TechPaula/PC6502/README.md

# GITHUB PROJECT NOW DEAD
I've now moved away from Micros**t and it's AI slop.

Find this project here - (https://codeberg.org/TechPaula/)
