TechPaula/PC6502/Schematics/PC6502-FM-SPEECH/PC6502-FM-SPEECH.step

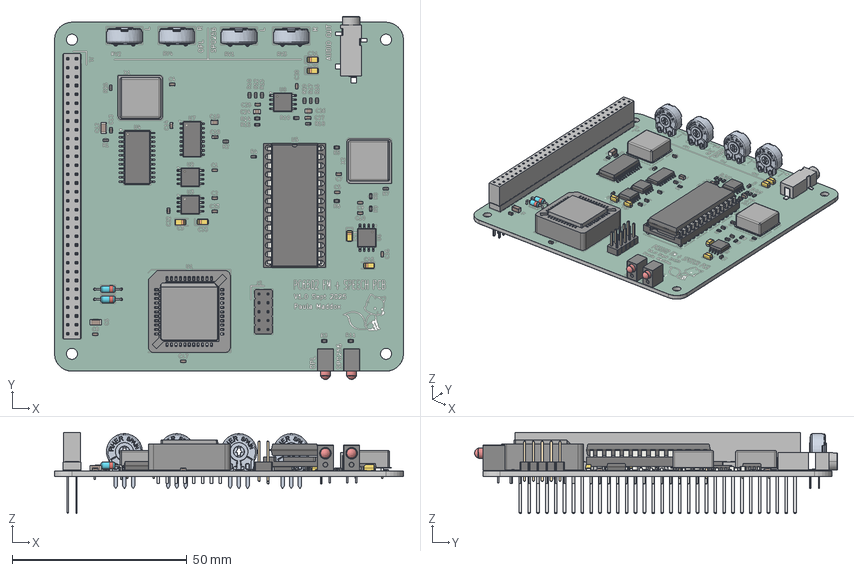
[picture p1: CAD file, 2025-10-02, last stored version]
Schematics/PC6502-FM-SPEECH/PC6502-FM-SPEECH.step
100.0 x 104.0 x 23.2 mm
SOIC-8_5.3x5.3mm_P1.27mm x 4
R_0603_1608Metric x 21
PLCC-44-AT
plcc44
D_DO-35_SOD27_P7.62mm_Horizontal x 2
PT10LH01-CARCASA x 4
PT10LH01-TERMINAL DERECHO x 4
PT10LH01-TERMINAL IZQUIERDO x 4
PT10LH01-COLECTOR x 4
PT10LH01-PORTACURSOR_Predeterminada x 4
C_0603_1608Metric x 18
PinHeader_2x05_P2.54mm_Vertical
C_0805_2012Metric x 3
C_1206_3216Metric x 2
Oscillator_DIP-8 x 2
CP_EIA-3216-18_Kemet-A x 6
LTL-4221NHBP x 2
SOIC-24W_7.5x15.4mm_P1.27mm
ESW-132-14-T-D_socket
ESW-132-14-T-D_pins
ESW-132-14-T-D2_PINS
ESW-132-14-T-D_bsocket
SOIC-16W_5.3x10.2mm_P1.27mm
SJ-3523-SMT-TR
DIP-28_W15.24mm_Socket
DIP-28_W15.24mm
PC6502-FM-SPEECH_silkscreen
PC6502-FM-SPEECH_soldermask
PC6502-FM-SPEECH_PCB
