TechPaula/PC6502/Schematics/PC6502-POWER/PC6502-POWER.step

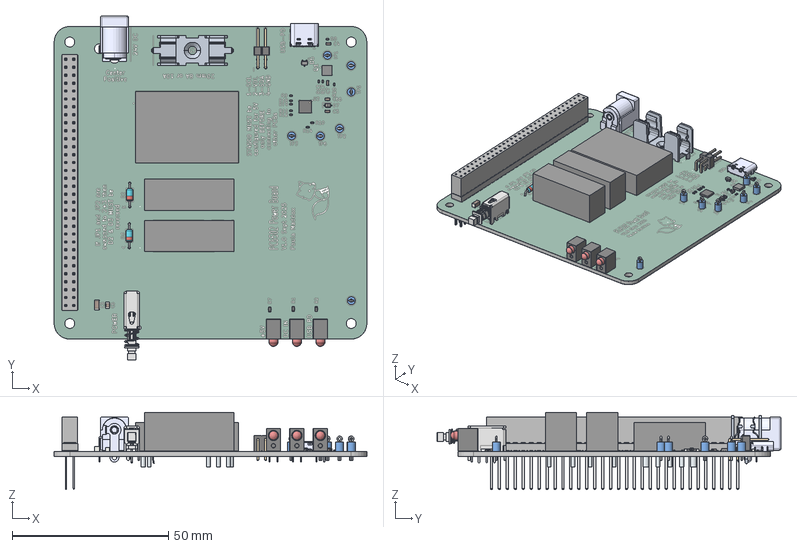
[picture p2: CAD file, 2025-10-02, last stored version]
Schematics/PC6502-POWER/PC6502-POWER.step
100.0 x 110.0 x 24.6 mm
TestPoint_Loop_D1.80mm_Drill1.0mm_Beaded x 7
R_0402_1005Metric x 11
C_0603_1608Metric x 4
C_0805_2012Metric
C_1206_3216Metric
Leads x 18
LC1258EENP
UJ20-C-H-G-SMT-1-P16-TR
R_0603_1608Metric x 3
PinsArrayL
FilletPinR
QFN-24-1EP_4x4mm_P0.5mm_EP2.7x2.7mm
D_SOD-323
LTL-4221NHBP x 3
ESW-132-14-T-D_socket
ESW-132-14-T-D_pins
ESW-132-14-T-D2_PINS
ESW-132-14-T-D_bsocket
STL9P3LLH6
D_DO-35_SOD27_P7.62mm_Horizontal x 2
PinHeader_2x02_P2.54mm_Horizontal
PC6502-POWER_silkscreen
PC6502-POWER_soldermask
PC6502-POWER_PCB
