TechPaula/PC6502/Schematics/PC6502-STORAGE/PC6502-STORAGE.step

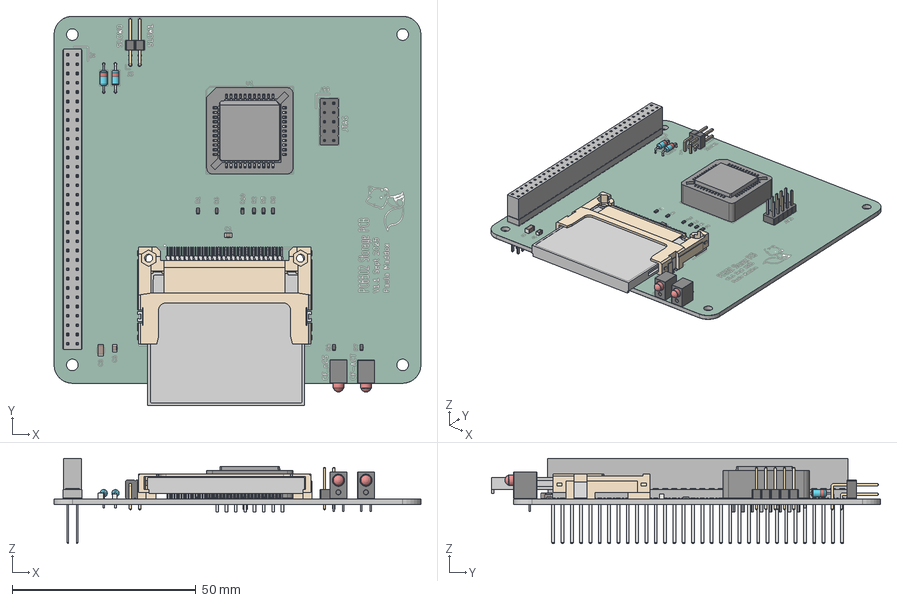
[picture p3: CAD file, 2025-10-02, last stored version]
Schematics/PC6502-STORAGE/PC6502-STORAGE.step
100.0 x 106.1 x 23.2 mm
LTL-4221NHBP x 2
R_0603_1608Metric x 8
D_DO-35_SOD27_P7.62mm_Horizontal x 2
C_0805_2012Metric x 3
C_1206_3216Metric
PinHeader_2x02_P2.54mm_Horizontal
ESW-132-14-T-D_socket
ESW-132-14-T-D_pins
ESW-132-14-T-D2_PINS
ESW-132-14-T-D_bsocket
PinHeader_2x05_P2.54mm_Vertical
693120035011_PATTE x 2
693120035011_PIN_HAUT_COURTE
693120035011_PIN_BAS_LONGUE x 3
693120035011_PIN_HAUT_LONGUE x 2
693120035011_PIN_BAS x 22
693120035011_PIN_HAUT x 22
CompactFlash (CF) Memory Card
PLCC-44-AT
plcc44
PC6502-STORAGE_silkscreen
PC6502-STORAGE_soldermask
PC6502-STORAGE_PCB
