TechPaula/PC6502/Schematics/PC6502-KEYTFT/PC6502-KEYTFT.kicad_pcb

## KiCad design Schematics/PC6502-KEYTFT/PC6502-KEYTFT.kicad_pcb (2026-03-21, last stored version)

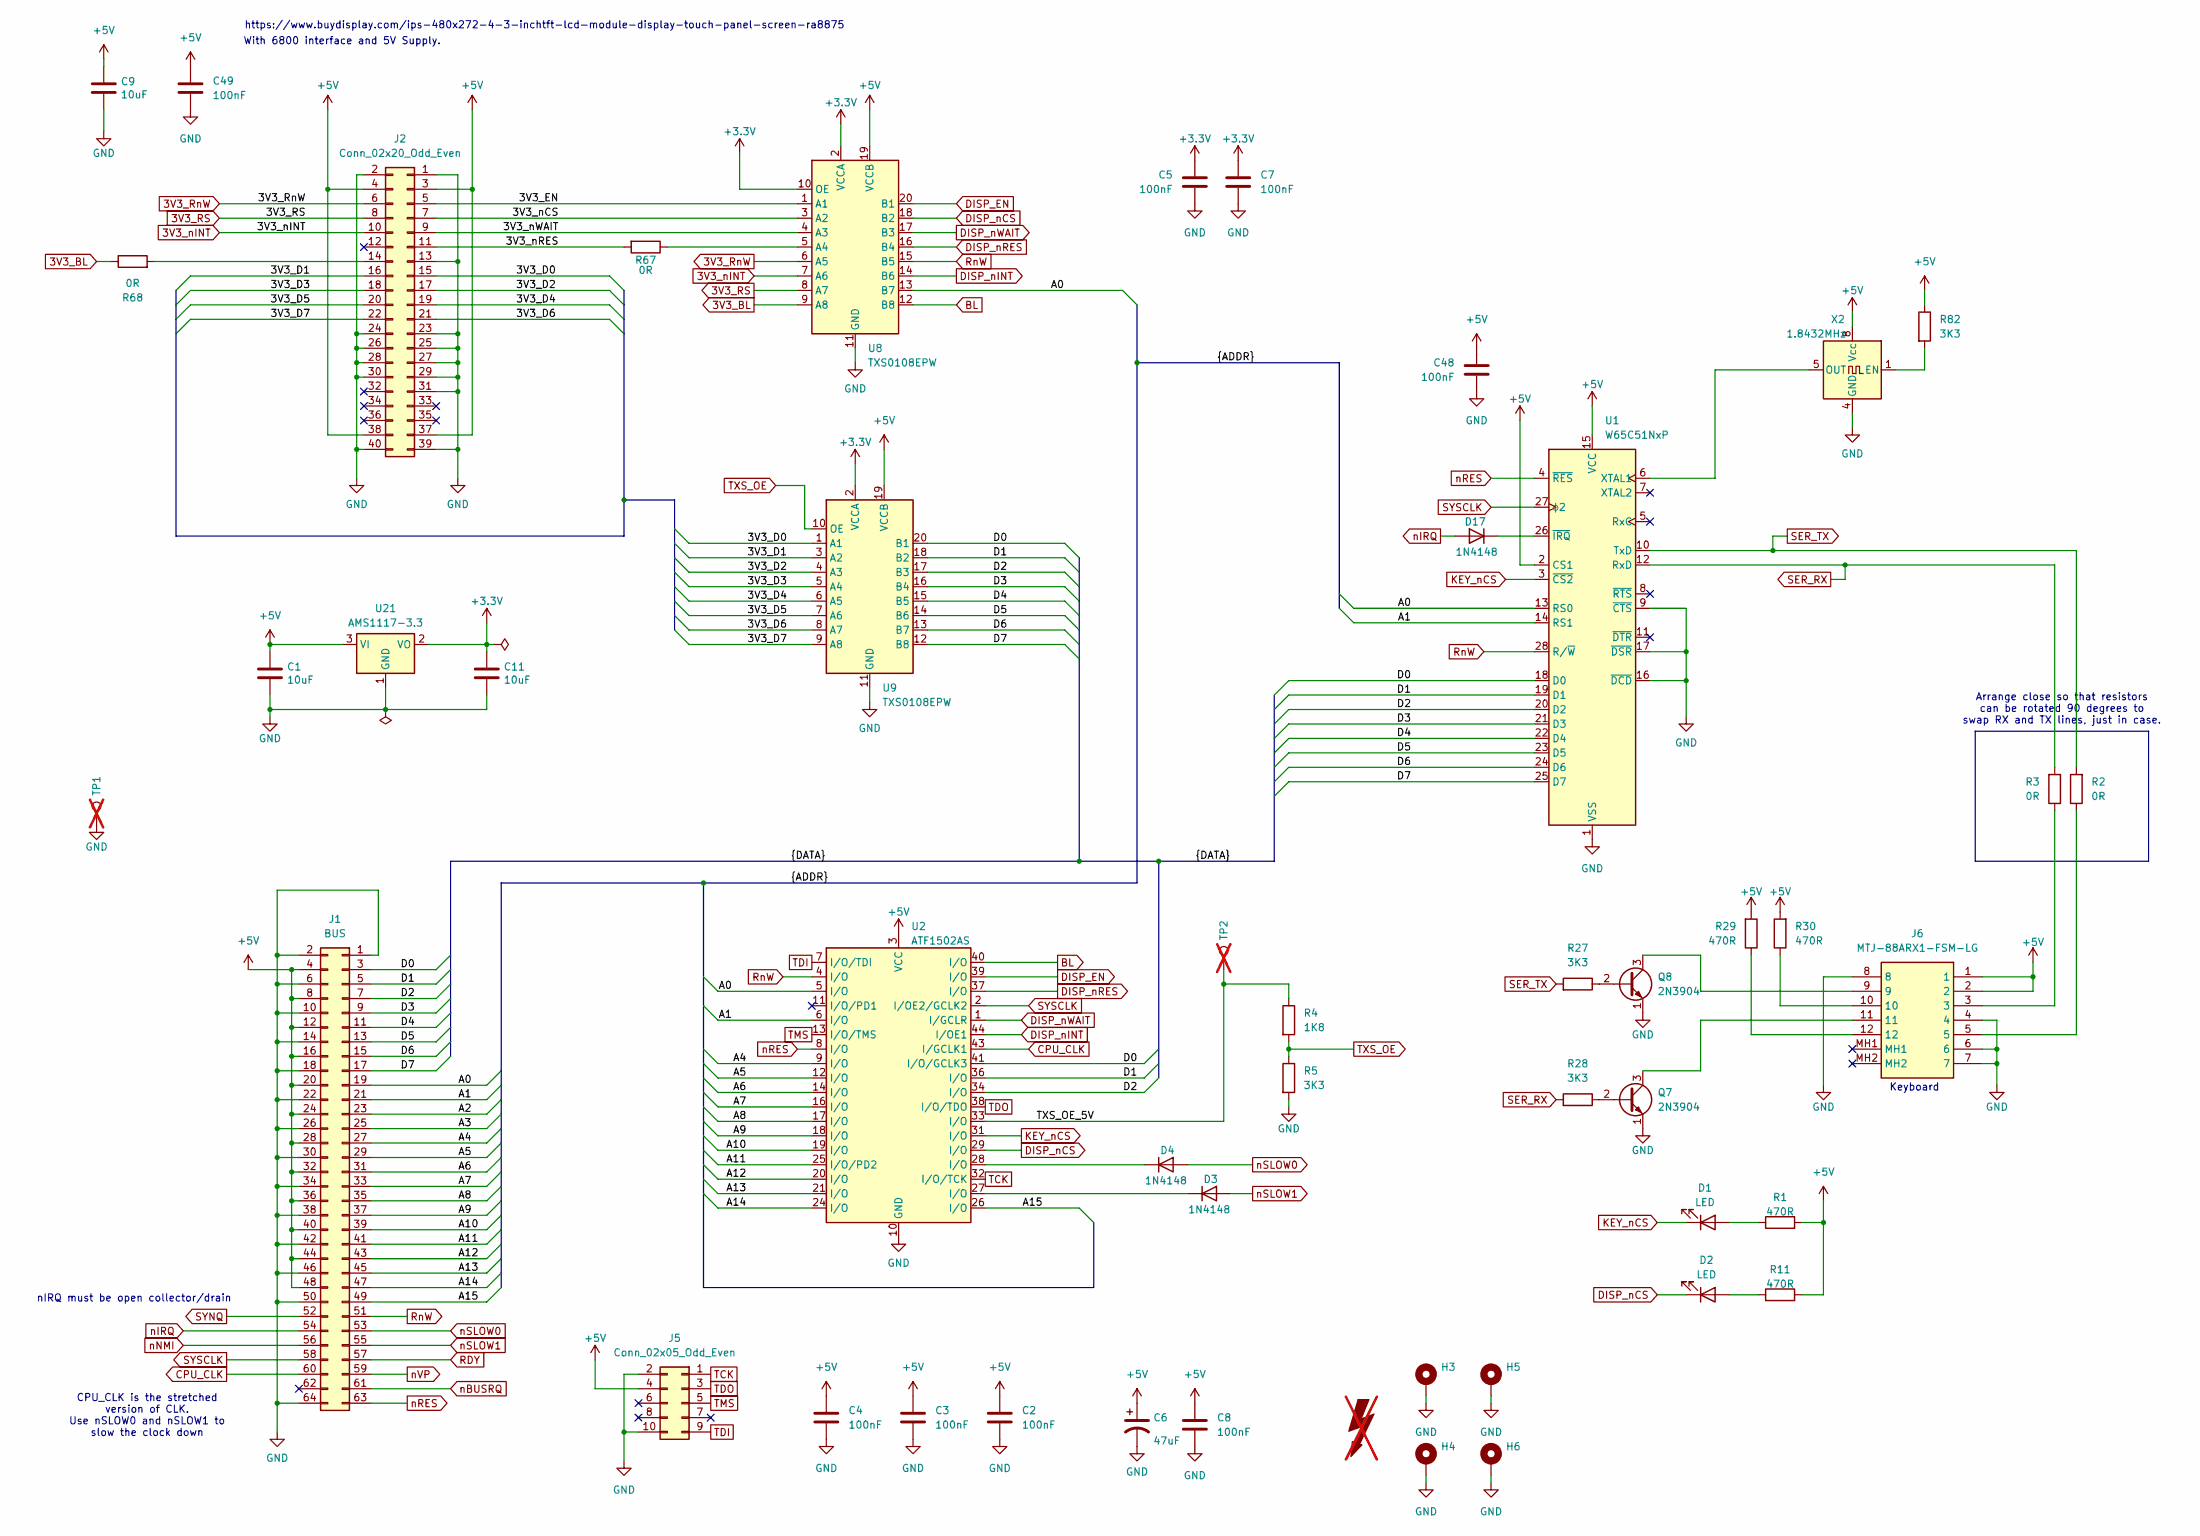
[picture p4: schematic PC6502-KEYTFT.kicad_sch]

Parts:
C1, C9, C11: 10uF; C_0805_2012Metric; ManufacturerPN C3216X7R1E475M085AB; LCSC C15850
C2, C3, C4, C8: 100nF; C_0603_1608Metric
C5, C7, C48, C49: 100nF; C_0603_1608Metric; LCSC C49678
C6: 47uF; C_1206_3216Metric; LCSC C96123
D1, D2: LED; LTL4221NHBP; LCSC DNF
D3, D4: 1N4148; D_DO-35_SOD27_P7.62mm_Horizontal; LCSC DNF
D17: 1N4148; D_DO-35_SOD27_P7.62mm_Horizontal
FOX1: SYM_Flash_Large; Fox_avatar_18mm; LCSC DNF; not fitted
H3, H4, H5, H6: MountingHole_Pad; MountingHole_3.2mm_M3_Pad_TopBottom; LCSC DNF
J1: BUS; PinSocket_2x32_P2.54mm_Vertical; LCSC DNF
J2: Conn_02x20_Odd_Even; PinSocket_2x20_P2.54mm_Horizontal
J5: Conn_02x05_Odd_Even; PinHeader_2x05_P2.54mm_Vertical; LCSC DNF
J6: MTJ-88ARX1-FSM-LG; MTJ88ARX1FSMLG; Mouser Part Number 737-MTJ88ARX1FSMLG
Q7, Q8: 2N3904; TO-92_Inline
R1, R11, R29, R30: 470R; R_0603_1608Metric; LCSC C23179
R2, R3: 0R; R_0603_1608Metric_Pad0.98x0.95mm_HandSolder; LCSC C23179
R4: 1K8; R_0603_1608Metric; LCSC C25890
R5, R27, R28, R82: 3K3; R_0603_1608Metric; LCSC C25890
R67, R68: 0R; R_0603_1608Metric; LCSC DNF
TP1, TP2: TestPoint; TestPoint_Loop_D1.80mm_Drill1.0mm_Beaded; LCSC DNF; not fitted
U1: W65C51NxP; DIP-28_W15.24mm
U2: ATF1502AS; PLCC-44_THT-Socket; LCSC DNF
U8, U9: TXS0108EPW; TSSOP-20_4.4x6.5mm_P0.65mm
U21: AMS1117-3.3; SOT-223-3_TabPin2; LCSC C6186
X2: 1.8432MHz; Oscillator_DIP-8; LCSC DNF

Connections:
3V3_BL: R68.1, U8.9 (A8)
3V3_RS: J2.8, U8.8 (A7)
3V3_RnW: J2.6, U8.6 (A5)
3V3_nINT: J2.10, U8.7 (A6)
+3.3V: C5.1, C7.1, C11.1, U8.2 (VCCA), U8.10 (OE), U9.2 (VCCA), U21.2 (VO)
+5V: C1.1, C2.1, C3.1, C4.1, C6.1, C8.1, C9.1, C48.1, C49.1, J1.4, J1.8, J1.12, J1.16, J1.20, J1.24, J1.28, J1.32, J1.36, J1.40, J1.44, J1.48, J2.3, J2.4, J2.37, J2.38, J5.4, J6.1, J6.2, R1.2, R11.2, R29.2, R30.2, R82.1, U1.2 (CS1), U1.15 (VCC), U2.3 (VCC), U2.15 (VCC), U2.23 (VCC), U2.35 (VCC), U8.19 (VCCB), U9.19 (VCCB), U21.3 (VI), X2.8 (Vcc)
/3V3_D0: J2.15, U9.1 (A1)
/3V3_D1: J2.16, U9.3 (A2)
/3V3_D2: J2.17, U9.4 (A3)
/3V3_D3: J2.18, U9.5 (A4)
/3V3_D4: J2.19, U9.6 (A5)
/3V3_D5: J2.20, U9.7 (A6)
/3V3_D6: J2.21, U9.8 (A7)
/3V3_D7: J2.22, U9.9 (A8)
/3V3_EN: J2.5, U8.1 (A1)
/3V3_nCS: J2.7, U8.3 (A2)
/3V3_nRES: J2.11, R67.2
/3V3_nWAIT: J2.9, U8.4 (A3)
/A0: J1.19, U1.13 (RS0), U2.5 (I/O), U8.13 (B7)
/A1: J1.21, U1.14 (RS1), U2.6 (I/O)
/A2: J1.23
/A3: J1.25
/A4: J1.27, U2.9 (I/O)
/A5: J1.29, U2.12 (I/O)
/A6: J1.31, U2.14 (I/O)
/A7: J1.33, U2.16 (I/O)
/A8: J1.35, U2.17 (I/O)
/A9: J1.37, U2.18 (I/O)
/A10: J1.39, U2.19 (I/O)
/A11: J1.41, U2.25 (I/O/PD2)
/A12: J1.43, U2.20 (I/O)
/A13: J1.45, U2.21 (I/O)
/A14: J1.47, U2.24 (I/O)
/A15: J1.49, U2.26 (I/O)
/D0: J1.3, U1.18 (D0), U2.41 (I/O/GCLK3), U9.20 (B1)
/D1: J1.5, U1.19 (D1), U2.36 (I/O), U9.18 (B2)
/D2: J1.7, U1.20 (D2), U2.34 (I/O), U9.17 (B3)
/D3: J1.9, U1.21 (D3), U9.16 (B4)
/D4: J1.11, U1.22 (D4), U9.15 (B5)
/D5: J1.13, U1.23 (D5), U9.14 (B6)
/D6: J1.15, U1.24 (D6), U9.13 (B7)
/D7: J1.17, U1.25 (D7), U9.12 (B8)
/TXS_OE_5V: R4.1, TP2.1, U2.33 (I/O)
BL: U2.40 (I/O), U8.12 (B8)
CPU_CLK: J1.60, U2.43 (I/GCLK1)
DISP_EN: U2.39 (I/O), U8.20 (B1)
DISP_nCS: D2.1 (K), U2.29 (I/O), U8.18 (B2)
DISP_nINT: U2.44 (I/OE1), U8.14 (B6)
DISP_nRES: U2.37 (I/O), U8.16 (B4)
DISP_nWAIT: U2.1 (I/GCLR), U8.17 (B3)
GND: C1.2, C2.2, C3.2, C4.2, C5.2, C6.2, C7.2, C8.2, C9.2, C11.2, C48.2, C49.2, H3.1, H4.1, H5.1, H6.1, J1.1, J1.2, J1.6, J1.10, J1.14, J1.18, J1.22, J1.26, J1.30, J1.34, J1.38, J1.42, J1.46, J1.50, J1.64, J2.1, J2.2, J2.13, J2.23, J2.24, J2.25, J2.26, J2.27, J2.28, J2.29, J2.30, J2.31, J2.39, J2.40, J5.2, J5.10, J6.4, J6.6, J6.7, J6.8, Q7.1 (E), Q8.1 (E), R5.2, TP1.1, U1.1 (VSS), U1.9 (~CTS), U1.16 (~DCD), U1.17 (~DSR), U2.10 (GND), U2.22 (GND), U2.30 (GND), U2.42 (GND), U8.11 (GND), U9.11 (GND), U21.1 (GND), X2.4 (GND)
KEY_nCS: D1.1 (K), U1.3 (~CS2), U2.31 (I/O)
unnamed: D1.2 (A), R1.1
unnamed: D2.2 (A), R11.1
unnamed: D3.1 (K), U2.27 (I/O)
unnamed: D4.1 (K), U2.28 (I/O)
unnamed: D17.1 (K), U1.26 (~IRQ)
unnamed: J2.14, R68.2
unnamed: J6.3, R3.1
unnamed: J6.5, R2.1
unnamed: J6.10, R30.1
unnamed: J6.12, R29.1
unnamed: Q7.2 (B), R28.1
unnamed: J6.11, Q7.3 (C)
unnamed: Q8.2 (B), R27.1
unnamed: J6.9, Q8.3 (C)
unnamed: U1.6 (XTAL1), X2.5 (OUT)
unnamed: R67.1, U8.5 (A4)
unnamed: R82.2, X2.1 (EN)
RDY: J1.57
RnW: J1.51, U1.28 (R/~W), U2.4 (I/O), U8.15 (B5)
SER_RX: R3.2, R28.2, U1.12 (RxD)
SER_TX: R2.2, R27.2, U1.10 (TxD)
SYNQ: J1.52
SYSCLK: J1.58, U1.27 (ϕ2), U2.2 (I/OE2/GCLK2)
TCK: J5.1, U2.32 (I/O/TCK)
TDI: J5.9, U2.7 (I/O/TDI)
TDO: J5.3, U2.38 (I/O/TDO)
TMS: J5.5, U2.13 (I/O/TMS)
TXS_OE: R4.2, R5.1, U9.10 (OE)
nBUSRQ: J1.61
nIRQ: D17.2 (A), J1.54
nNMI: J1.56
nRES: J1.63, U1.4 (~RES), U2.8 (I/O)
nSLOW0: D4.2 (A), J1.53
nSLOW1: D3.2 (A), J1.55
nVP: J1.59

Notes on the sheet:
With 6800 interface and 5V Supply.
CPU_CLK is the stretched version of CLK. Use nSLOW0 and nSLOW1 to slow the clock down
Arrange close so that resistors can be rotated 90 degrees to swap RX and TX lines, just in case.
https://www.buydisplay.com/ips-480x272-4-3-inchtft-lcd-module-display-touch-panel-screen-ra8875
Keyboard
nIRQ must be open collector/drain

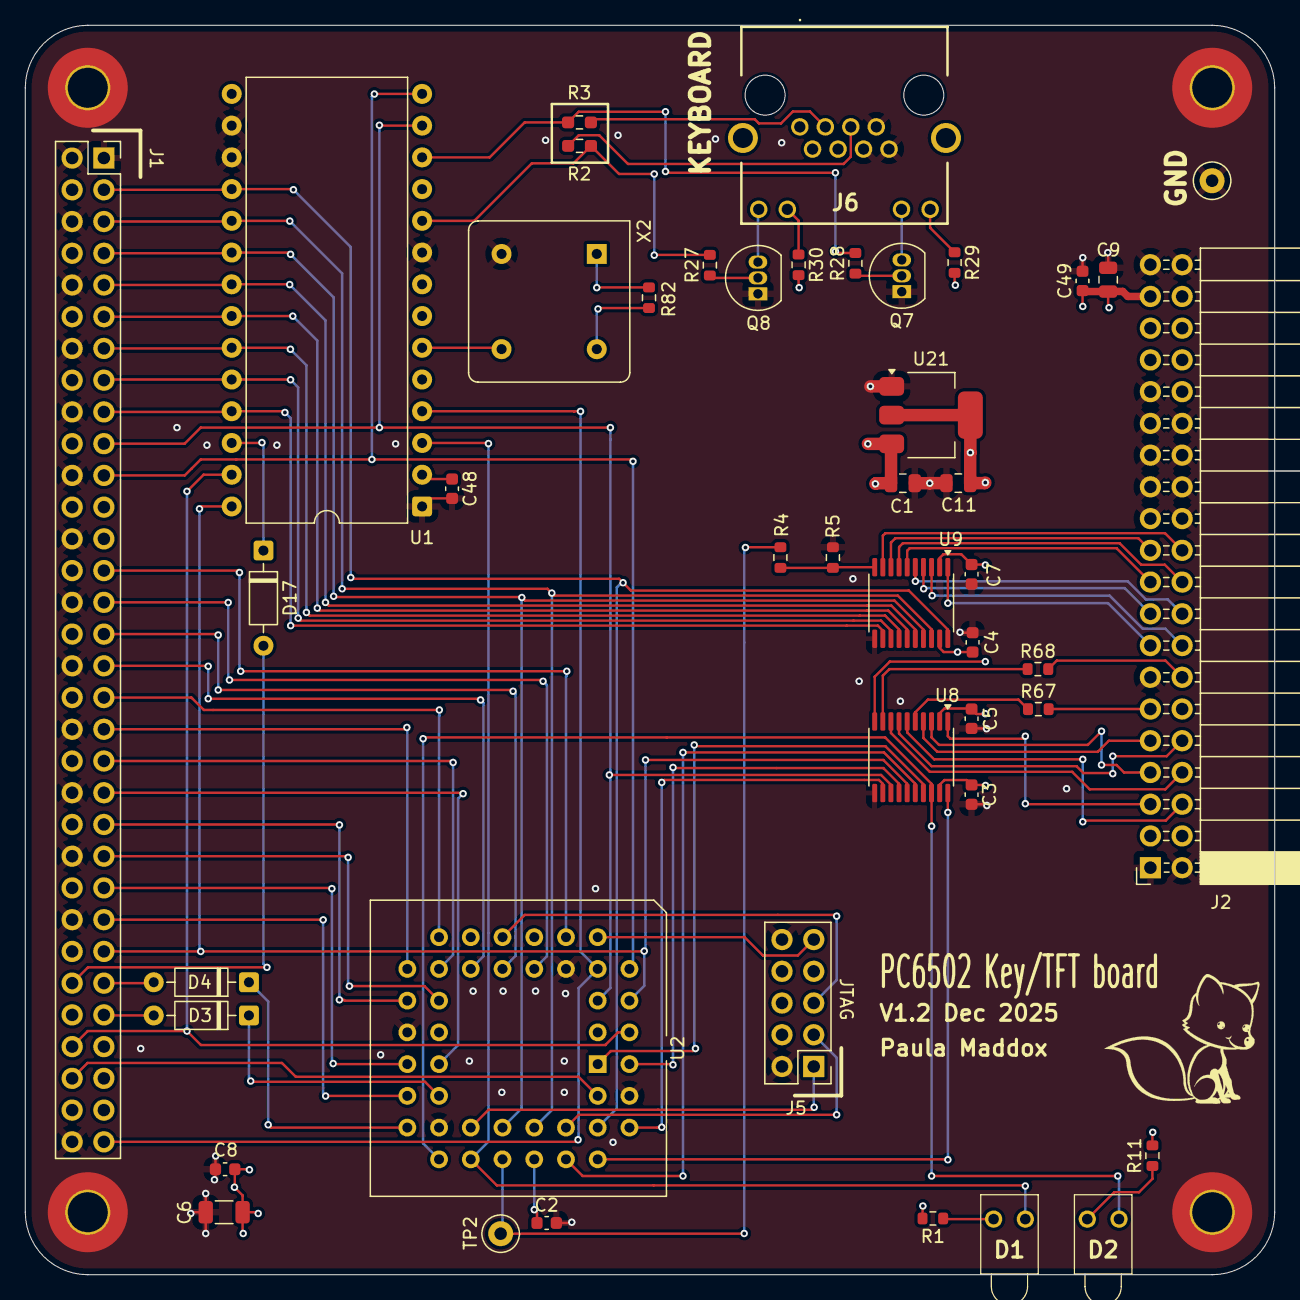
[picture p5: board PC6502-KEYTFT.kicad_pcb from above]

Board: 4 copper layers, 100.0 x 100.0 mm, 49 parts (0 on the bottom side), 80 nets.
