TechPaula/PC6502/Schematics/PC6502-SOUND_GEN_A/PC6502-SOUND_GEN_A.kicad_pcb

## KiCad design Schematics/PC6502-SOUND_GEN_A/PC6502-SOUND_GEN_A.kicad_pcb (2025-12-28, last stored version)

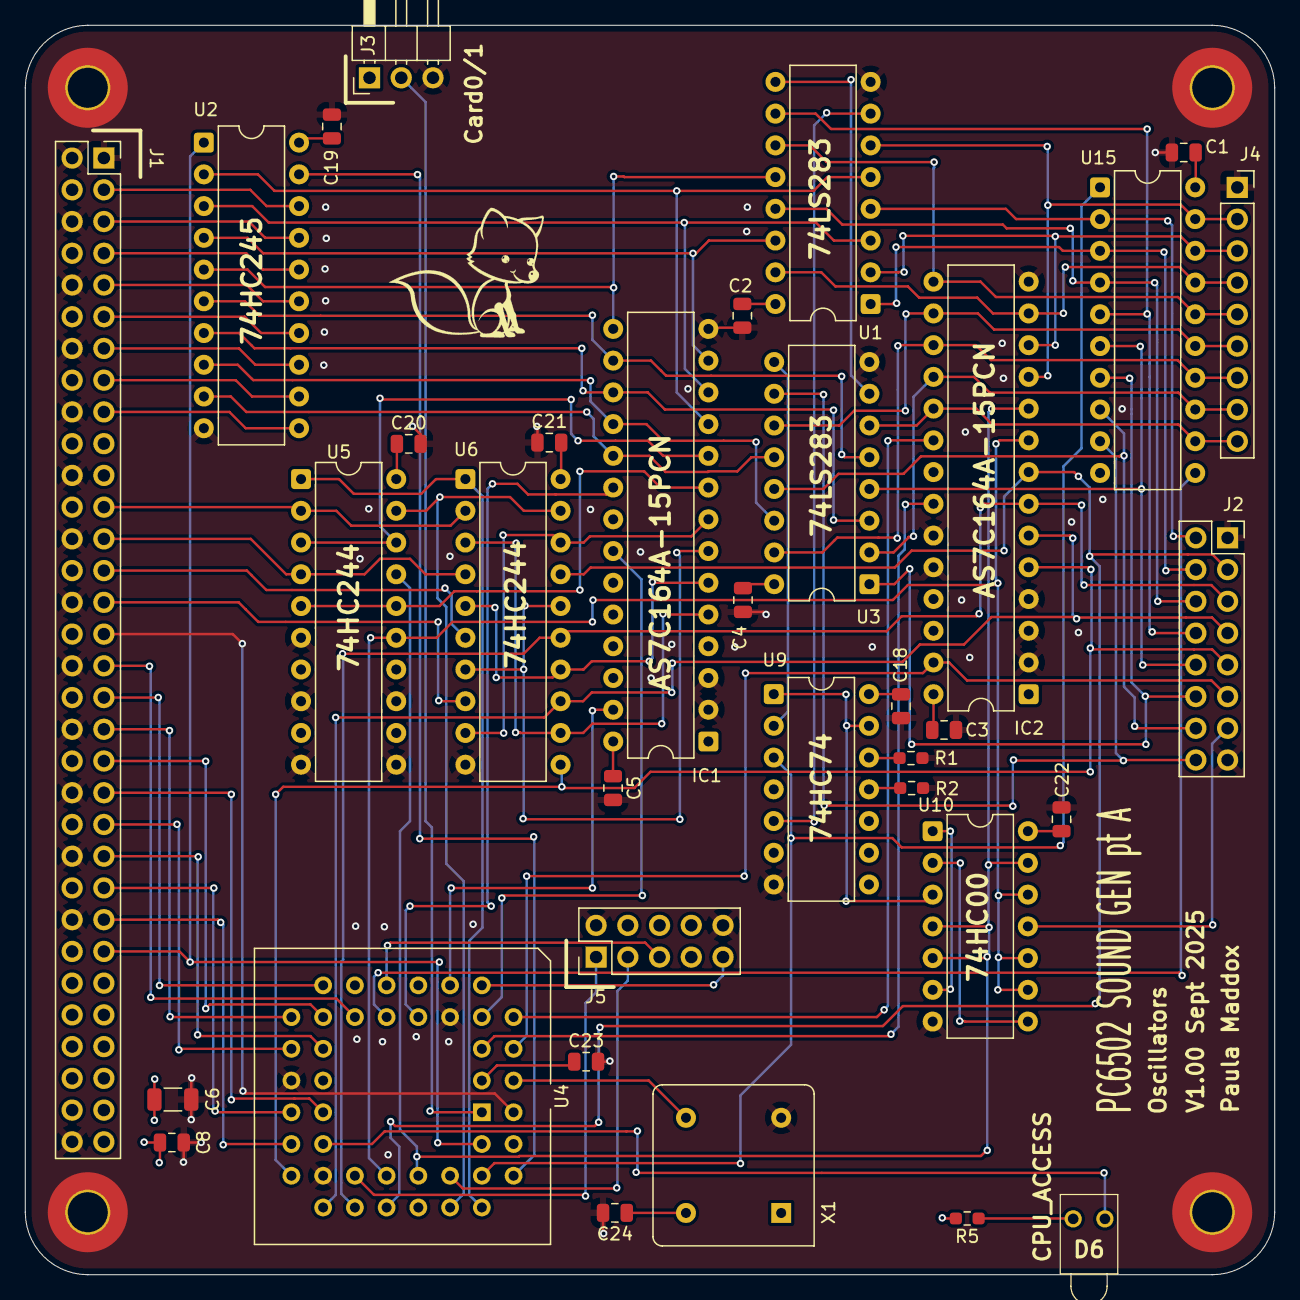
[picture p6: board PC6502-SOUND_GEN_A.kicad_pcb from above]

Board: 4 copper layers, 100.0 x 100.0 mm, 40 parts (0 on the bottom side), 89 nets.

Parts:
C1, C2, C3, C4, C5, C8, C18, C19, C20, C21, C22, C23, C24: 100nF; C_0805_2012Metric
C6: 47uF; C_1206_3216Metric
D6: LED; LTL4221NHBP
FOX1: SYM_Flash_Large; Fox_avatar_18mm
H3, H4, H5, H6: MountingHole_Pad; MountingHole_3.2mm_M3_Pad_TopBottom
IC1, IC2: AS7C164A-15PCN; DIP-28_W7.62mm
J1: BUS; PinSocket_2x32_P2.54mm_Vertical
J2: NCO_OUT; PinSocket_2x08_P2.54mm_Vertical
J3: SND0/SND1; PinHeader_1x03_P2.54mm_Horizontal
J4: Conn_01x09; PinSocket_1x09_P2.54mm_Vertical
J5: Conn_02x05_Odd_Even; PinHeader_2x05_P2.54mm_Vertical
R1, R2: 10K; R_0603_1608Metric_Pad0.98x0.95mm_HandSolder
R5: 470R; R_0603_1608Metric_Pad0.98x0.95mm_HandSolder
U1, U3: 74LS283; DIP-16_W7.62mm
U2: 74HC245; DIP-20_W7.62mm
U4: ATF1504AS; PLCC-44_THT-Socket
U5, U6: 74AHCT244; DIP-20_W7.62mm
U9: 74HC74; DIP-14_W7.62mm
U10: 74HC00; DIP-14_W7.62mm
U15: 74HCT574; DIP-20_W7.62mm
X1: CXO_DIP8; Oscillator_DIP-8

Connections:
+5V: C1.1, C2.1, C3.1, C4.1, C5.1, C6.1, C8.1, C18.1, C19.1, C20.1, C21.1, C22.1, C23.1, C24.1, IC1.21 (A10), IC1.23 (A11), IC1.24 (A9), IC1.25 (A8), IC1.26 (CE2), IC1.28 (VCC), IC2.26 (CE2), IC2.28 (VCC), J1.4, J1.8, J1.12, J1.16, J1.20, J1.24, J1.28, J1.32, J1.36, J1.40, J1.44, J1.48, J3.1, J5.4, R5.2, U1.16 (VCC), U2.20 (VCC), U3.16 (VCC), U4.3 (VCC), U4.15 (VCC), U4.23 (VCC), U4.35 (VCC), U5.20 (VCC), U6.20 (VCC), U9.4 (~S), U9.10 (~S), U9.14 (VCC), U10.14 (VCC), U15.20 (VCC), X1.8 (Vcc)
/8BitNCO/ACC_DQ0: IC2.11 (DQ0), J4.2, U1.6 (B1), U15.19 (Q0)
/8BitNCO/ACC_DQ1: IC2.12 (DQ1), J4.3, U1.2 (B2), U15.18 (Q1)
/8BitNCO/ACC_DQ2: IC2.13 (DQ2), J4.4, U1.15 (B3), U15.17 (Q2)
/8BitNCO/ACC_DQ3: IC2.15 (DQ3), J4.5, U1.11 (B4), U15.16 (Q3)
/8BitNCO/ACC_DQ4: IC2.16 (DQ4), J4.6, U3.11 (B4), U15.15 (Q4)
/8BitNCO/ACC_DQ5: IC2.17 (DQ5), J4.7, U3.15 (B3), U15.14 (Q5)
/8BitNCO/ACC_DQ6: IC2.18 (DQ6), J4.8, U3.2 (B2), U15.13 (Q6)
/8BitNCO/ACC_DQ7: IC2.19 (DQ7), J4.9, U3.6 (B1), U15.12 (Q7)
/8BitNCO/Cin: U1.7 (C0), U9.5 (Q)
/8BitNCO/Cout: U3.9 (C4), U9.2 (D)
/8BitNCO/PTC_A0: IC1.10 (A0), U5.3 (2Y0), U5.18 (1Y0)
/8BitNCO/PTC_A1: IC1.9 (A1), U5.5 (2Y1), U5.16 (1Y1)
/8BitNCO/PTC_A2: IC1.8 (A2), U6.9 (2Y3), U6.18 (1Y0)
/8BitNCO/PTC_A3: IC1.7 (A3), U6.7 (2Y2), U6.16 (1Y1)
/8BitNCO/PTC_A4: IC1.6 (A4), U6.5 (2Y1), U6.14 (1Y2)
/8BitNCO/PTC_A5: IC1.5 (A5), U6.3 (2Y0), U6.12 (1Y3)
/8BitNCO/PTC_DQ0: IC1.11 (DQ0), U1.5 (A1), U2.2 (A0)
/8BitNCO/PTC_DQ1: IC1.12 (DQ1), U1.3 (A2), U2.3 (A1)
/8BitNCO/PTC_DQ2: IC1.13 (DQ2), U1.14 (A3), U2.4 (A2)
/8BitNCO/PTC_DQ3: IC1.15 (DQ3), U1.12 (A4), U2.5 (A3)
/8BitNCO/PTC_DQ4: IC1.16 (DQ4), U2.6 (A4), U3.5 (A1)
/8BitNCO/PTC_DQ5: IC1.17 (DQ5), U2.7 (A5), U3.3 (A2)
/8BitNCO/PTC_DQ6: IC1.18 (DQ6), U2.8 (A6), U3.14 (A3)
/8BitNCO/PTC_DQ7: IC1.19 (DQ7), U2.9 (A7), U3.12 (A4)
/8BitNCO/SUM0: J2.2, U1.4 (S1), U15.2 (D0)
/8BitNCO/SUM1: J2.4, U1.1 (S2), U15.3 (D1)
/8BitNCO/SUM2: J2.6, U1.13 (S3), U15.4 (D2)
/8BitNCO/SUM3: J2.8, U1.10 (S4), U15.5 (D3)
/8BitNCO/SUM4: J2.10, U3.4 (S1), U15.6 (D4)
/8BitNCO/SUM5: J2.12, U3.1 (S2), U15.7 (D5)
/8BitNCO/SUM6: J2.14, U3.13 (S3), U15.8 (D6)
/8BitNCO/SUM7: J2.16, U3.10 (S4), U15.9 (D7)
/A2: J1.23, U5.2 (1A0), U6.2 (1A0)
/A3: J1.25, U5.4 (1A1), U6.4 (1A1)
/A4: J1.27, U6.6 (1A2)
/A5: J1.29, U6.8 (1A3)
/A6: J1.31, U4.44 (I/OE1)
/A7: J1.33, U4.16 (I/O)
/A8: J1.35, U4.17 (I/O)
/A9: J1.37, U4.18 (I/O)
/A10: J1.39, U4.19 (I/O)
/A11: J1.41, U4.25 (I/O/PD2)
/A12: J1.43, U4.20 (I/O)
/A13: J1.45, U4.21 (I/O)
/A14: J1.47, U4.24 (I/O)
/A15: J1.49, U4.26 (I/O)
/D0: J1.3, U2.18 (B0)
/D1: J1.5, U2.17 (B1)
/D2: J1.7, U2.16 (B2)
/D3: J1.9, U2.15 (B3)
/D4: J1.11, U2.14 (B4)
/D5: J1.13, U2.13 (B5)
/D6: J1.15, U2.12 (B6)
/D7: J1.17, U2.11 (B7)
/nWAVE_VALID: J2.13, U10.11
/nZERO_CARRY: U9.1 (~R), U9.13 (~R), U10.3
ACC_nCS: IC2.20 (CE#), U4.6 (I/O)
ACC_nOE: IC2.22 (OE#), U4.5 (I/O)
ACC_nWR: IC2.27 (WE#), J2.11, U4.4 (I/O)
BYTE_SEL_A0: IC2.10 (A0), U4.36 (I/O), U5.17 (2A0), U10.4, U10.5, U10.13
BYTE_SEL_A1: IC2.9 (A1), U4.34 (I/O), U5.15 (2A1), U10.9, U10.10, U10.12
GND: C1.2, C2.2, C3.2, C4.2, C5.2, C6.2, C8.2, C18.2, C19.2, C20.2, C21.2, C22.2, C23.2, C24.2, H3.1, H4.1, H5.1, H6.1, IC1.2 (A12), IC1.3 (A7), IC1.4 (A6), IC1.14 (VSS), IC2.2 (A12), IC2.3 (A7), IC2.4 (A6), IC2.14 (VSS), IC2.21 (A10), IC2.23 (A11), IC2.24 (A9), IC2.25 (A8), J1.1, J1.2, J1.6, J1.10, J1.14, J1.18, J1.22, J1.26, J1.30, J1.34, J1.38, J1.42, J1.46, J1.50, J1.64, J2.1, J2.15, J3.3, J4.1, J5.2, J5.10, R1.2, R2.2, U1.8 (GND), U2.10 (GND), U3.8 (GND), U4.10 (GND), U4.22 (GND), U4.30 (GND), U4.42 (GND), U5.6 (1A2), U5.8 (1A3), U5.10 (GND), U5.11 (2A3), U5.13 (2A2), U6.10 (GND), U9.7 (GND), U10.7 (GND), U15.10 (GND), X1.4 (GND)
NCO_ADDR_nEN: U4.37 (I/O), U5.19 (2OE), U6.19 (2OE)
NCO_CLK: U4.2 (I/OE2/GCLK2), X1.5 (OUT)
unnamed: D6.2 (A), R5.1
unnamed: D6.1 (K), U4.27 (I/O)
unnamed: J3.2, U4.1 (I/GCLR)
unnamed: U1.9 (C4), U3.7 (C0)
unnamed: R2.1, U9.11 (C)
unnamed: R1.1, U9.12 (D)
unnamed: U10.1, U10.6
unnamed: U10.2, U10.8
OSC_A0: IC2.8 (A2), J2.3, U4.33 (I/O), U6.17 (2A0)
OSC_A1: IC2.7 (A3), J2.5, U4.31 (I/O), U6.15 (2A1)
OSC_A2: IC2.6 (A4), J2.7, U4.29 (I/O), U6.13 (2A2)
OSC_A3: IC2.5 (A5), J2.9, U4.28 (I/O), U6.11 (2A3)
PTC_nCS: IC1.20 (CE#), U4.12 (I/O)
PTC_nOE: IC1.22 (OE#), U4.8 (I/O)
PTC_nWR: IC1.27 (WE#), U4.9 (I/O)
RnW: J1.51, U2.1 (A->B), U4.43 (I/GCLK1)
SUM_BUFF_CK: U4.14 (I/O), U15.11 (Cp)
SUM_BUFF_nOE: U4.41 (I/O/GCLK3), U9.3 (C), U15.1 (OE)
SYS_ADDR_nEN: U4.39 (I/O), U5.1 (1OE), U6.1 (1OE)
TCK: J5.1, U4.32 (I/O/TCK)
TDI: J5.9, U4.7 (I/O/TDI)
TDO: J5.3, U4.38 (I/O/TDO)
TMS: J5.5, U4.13 (I/O/TMS)
nSYSDATA_TO_PTC: U2.19 (CE), U4.40 (I/O)
