TechPaula/PC6502/Schematics/PC6502-DUALTRANSPUTER/PC6502-DUALTRANSPUTER.kicad_pcb

## KiCad design Schematics/PC6502-DUALTRANSPUTER/PC6502-DUALTRANSPUTER.kicad_pcb (2025-12-24, last stored version)

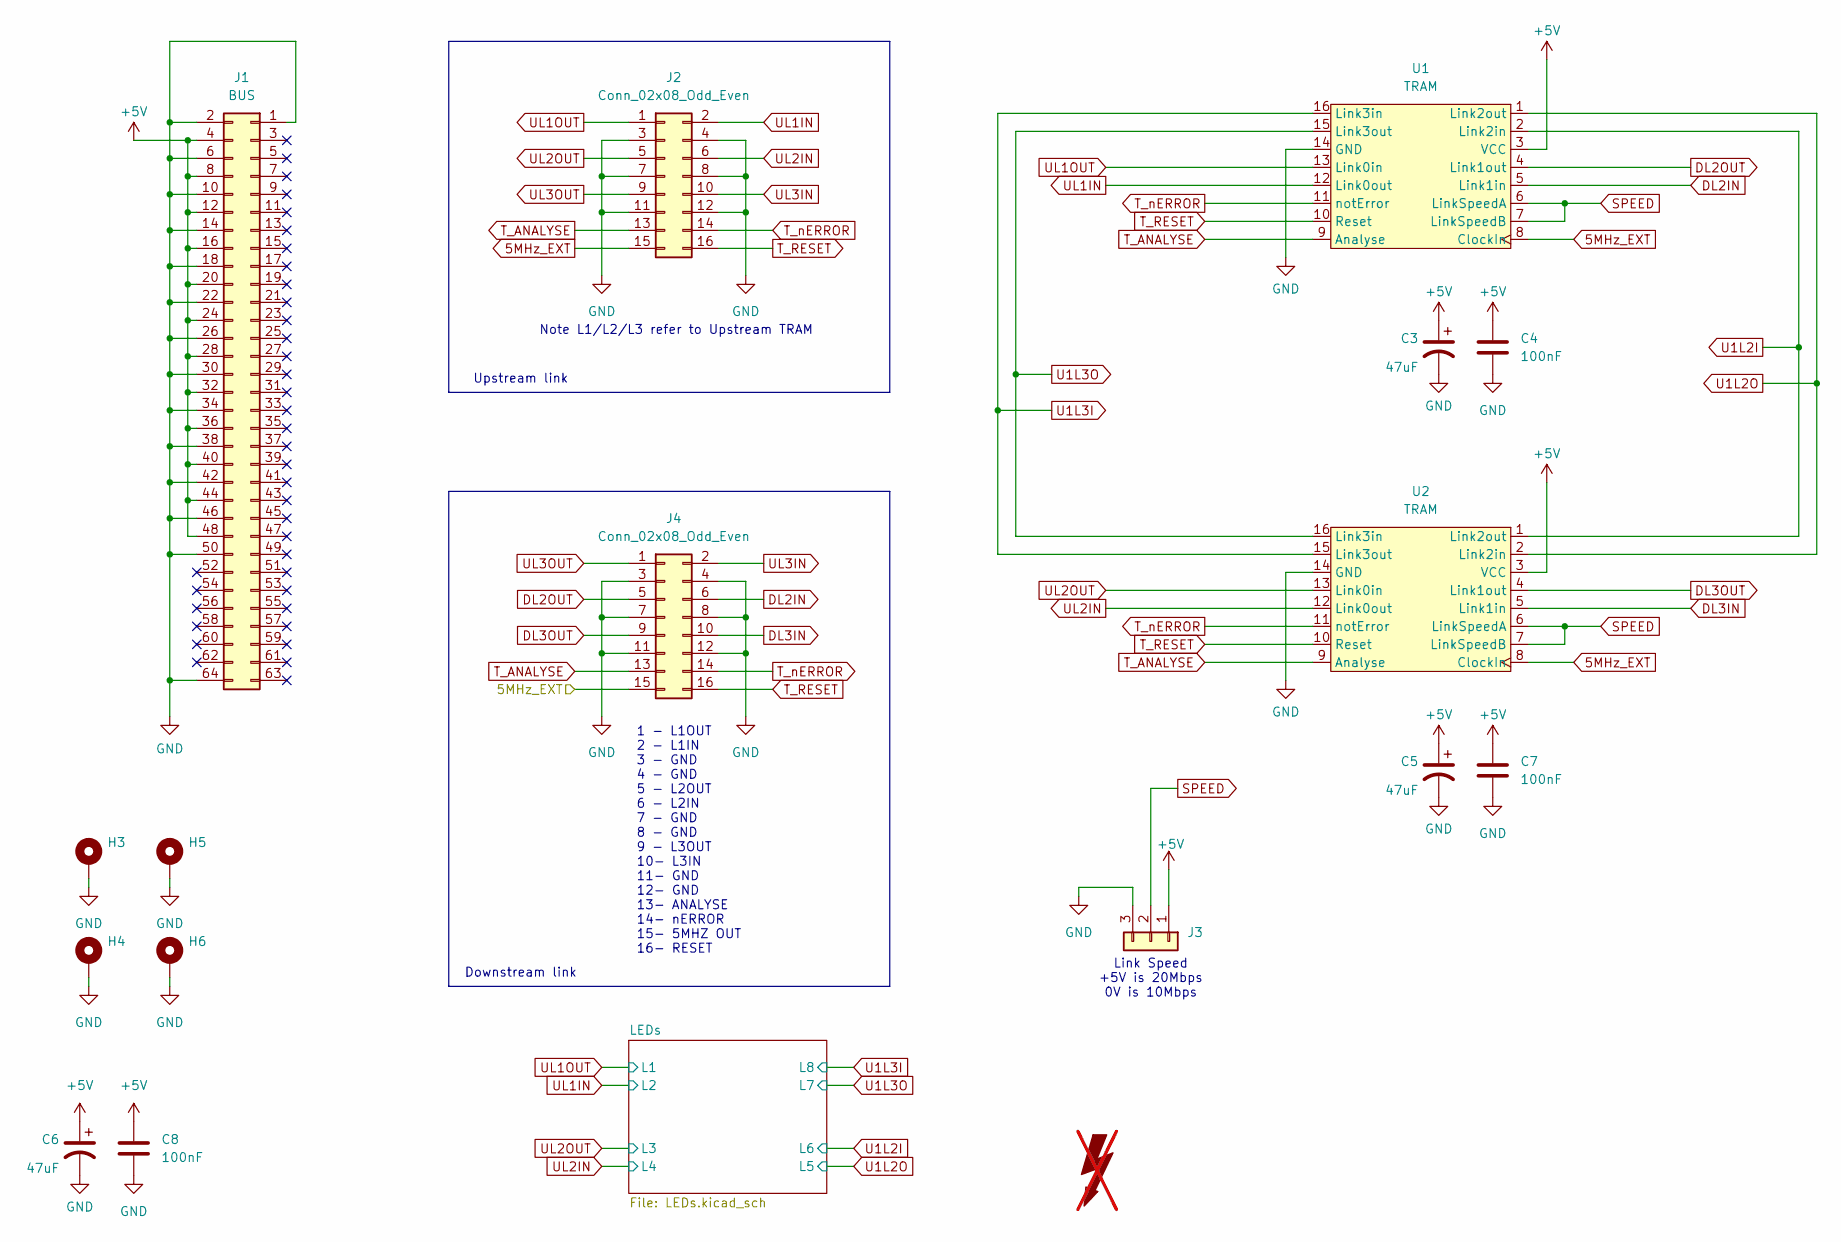
[picture p7: schematic PC6502-DUALTRANSPUTER.kicad_sch]

Parts:
C3, C5, C6: 47uF; C_1206_3216Metric; LCSC C96123
C4, C7: 100nF; C_0603_1608Metric
C8: 100nF; C_0805_2012Metric
FOX1: SYM_Flash_Large; Fox_avatar_18mm; LCSC DNF; not fitted
H3, H4, H5, H6: MountingHole_Pad; MountingHole_3.2mm_M3_Pad_TopBottom; LCSC DNF
J1: BUS; PinSocket_2x32_P2.54mm_Vertical; LCSC DNF
J2, J4: Conn_02x08_Odd_Even; PinHeader_2x08_P2.54mm_Horizontal
J3: Conn_01x03; PinHeader_1x03_P2.54mm_Horizontal
U1, U2: TRAM

Connections:
5MHz_EXT: J2.15, J4.15, U1.8 (ClockIn), U2.8 (ClockIn)
+5V: C3.1, C4.1, C5.1, C6.1, C7.1, C8.1, J1.4, J1.8, J1.12, J1.16, J1.20, J1.24, J1.28, J1.32, J1.36, J1.40, J1.44, J1.48, J3.1, U1.3 (VCC), U2.3 (VCC); also elsewhere on the board
DL2IN: J4.6, U1.5 (Link1in)
DL2OUT: J4.5, U1.4 (Link1out)
DL3IN: J4.10, U2.5 (Link1in)
DL3OUT: J4.9, U2.4 (Link1out)
GND: C3.2, C4.2, C5.2, C6.2, C7.2, C8.2, H3.1, H4.1, H5.1, H6.1, J1.1, J1.2, J1.6, J1.10, J1.14, J1.18, J1.22, J1.26, J1.30, J1.34, J1.38, J1.42, J1.46, J1.50, J1.64, J2.3, J2.4, J2.7, J2.8, J2.11, J2.12, J3.3, J4.3, J4.4, J4.7, J4.8, J4.11, J4.12, U1.14 (GND), U2.14 (GND); also elsewhere on the board
SPEED: J3.2, U1.6 (LinkSpeedA), U1.7 (LinkSpeedB), U2.6 (LinkSpeedA), U2.7 (LinkSpeedB)
T_ANALYSE: J2.13, J4.13, U1.9 (Analyse), U2.9 (Analyse)
T_RESET: J2.16, J4.16, U1.10 (Reset), U2.10 (Reset)
T_nERROR: J2.14, J4.14, U1.11 (notError), U2.11 (notError)
U1L2I: U1.2 (Link2in), U2.1 (Link2out); also elsewhere on the board
U1L2O: U1.1 (Link2out), U2.2 (Link2in); also elsewhere on the board
U1L3I: U1.16 (Link3in), U2.15 (Link3out); also elsewhere on the board
U1L3O: U1.15 (Link3out), U2.16 (Link3in); also elsewhere on the board
UL1IN: J2.2, U1.12 (Link0out); also elsewhere on the board
UL1OUT: J2.1, U1.13 (Link0in); also elsewhere on the board
UL2IN: J2.6, U2.12 (Link0out); also elsewhere on the board
UL2OUT: J2.5, U2.13 (Link0in); also elsewhere on the board
UL3IN: J2.10, J4.2
UL3OUT: J2.9, J4.1

Notes on the sheet:
Upstream link
1 - L1OUT 2 - L1IN 3 - GND 4 - GND 5 - L2OUT 6 - L2IN 7 - GND 8 - GND 9 - L3OUT 10- L3IN 11- GND 12- GND 13- ANALYSE 14- nERROR 15- 5MHZ OUT 16- RESET
Link Speed +5V is 20Mbps 0V is 10Mbps
Downstream link
Note L1/L2/L3 refer to Upstream TRAM

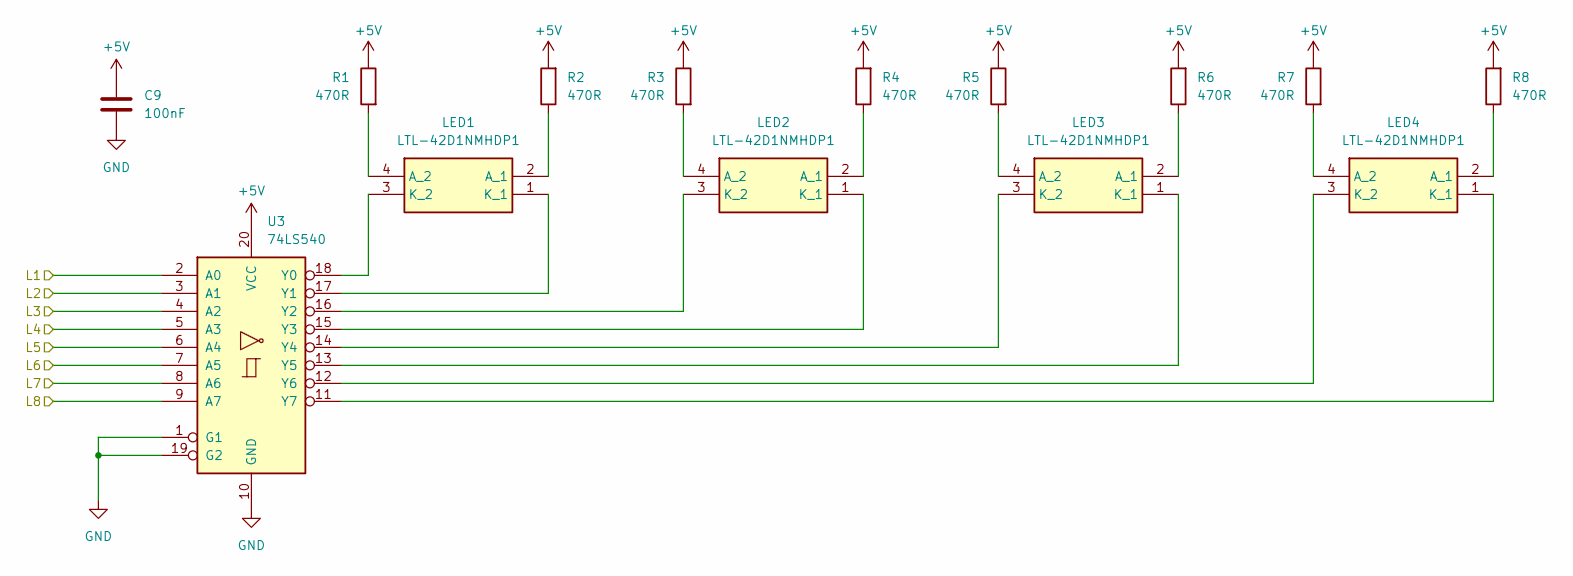
[picture p8: schematic LEDs.kicad_sch]

Parts:
C9: 100nF; C_0603_1608Metric
LED1, LED2, LED3, LED4: LTL-42D1NMHDP1; LTL42D1NMHDP1; Mouser Part Number 859-LTL-42D1NMHDP1
R1, R2, R3, R4, R5, R6, R7, R8: 470R; R_0603_1608Metric_Pad0.98x0.95mm_HandSolder; LCSC C23179
U3: 74LS540; TSSOP-20_4.4x6.5mm_P0.65mm

Connections:
+5V: C9.1, R1.1, R2.2, R3.1, R4.2, R5.1, R6.2, R7.1, R8.2, U3.20 (VCC); also elsewhere on the board
GND: C9.2, U3.1 (G1), U3.10 (GND), U3.19 (G2); also elsewhere on the board
unnamed: LED1.2 (A_1), R2.1
unnamed: LED1.4 (A_2), R1.2
unnamed: LED1.1 (K_1), U3.17 (Y1)
unnamed: LED1.3 (K_2), U3.18 (Y0)
unnamed: LED2.2 (A_1), R4.1
unnamed: LED2.4 (A_2), R3.2
unnamed: LED2.1 (K_1), U3.15 (Y3)
unnamed: LED2.3 (K_2), U3.16 (Y2)
unnamed: LED3.2 (A_1), R6.1
unnamed: LED3.4 (A_2), R5.2
unnamed: LED3.1 (K_1), U3.13 (Y5)
unnamed: LED3.3 (K_2), U3.14 (Y4)
unnamed: LED4.2 (A_1), R8.1
unnamed: LED4.4 (A_2), R7.2
unnamed: LED4.1 (K_1), U3.11 (Y7)
unnamed: LED4.3 (K_2), U3.12 (Y6)
U1L2I: U3.7 (A5); also elsewhere on the board
U1L2O: U3.6 (A4); also elsewhere on the board
U1L3I: U3.8 (A6); also elsewhere on the board
U1L3O: U3.9 (A7); also elsewhere on the board
UL1IN: U3.3 (A1); also elsewhere on the board
UL1OUT: U3.2 (A0); also elsewhere on the board
UL2IN: U3.5 (A3); also elsewhere on the board
UL2OUT: U3.4 (A2); also elsewhere on the board

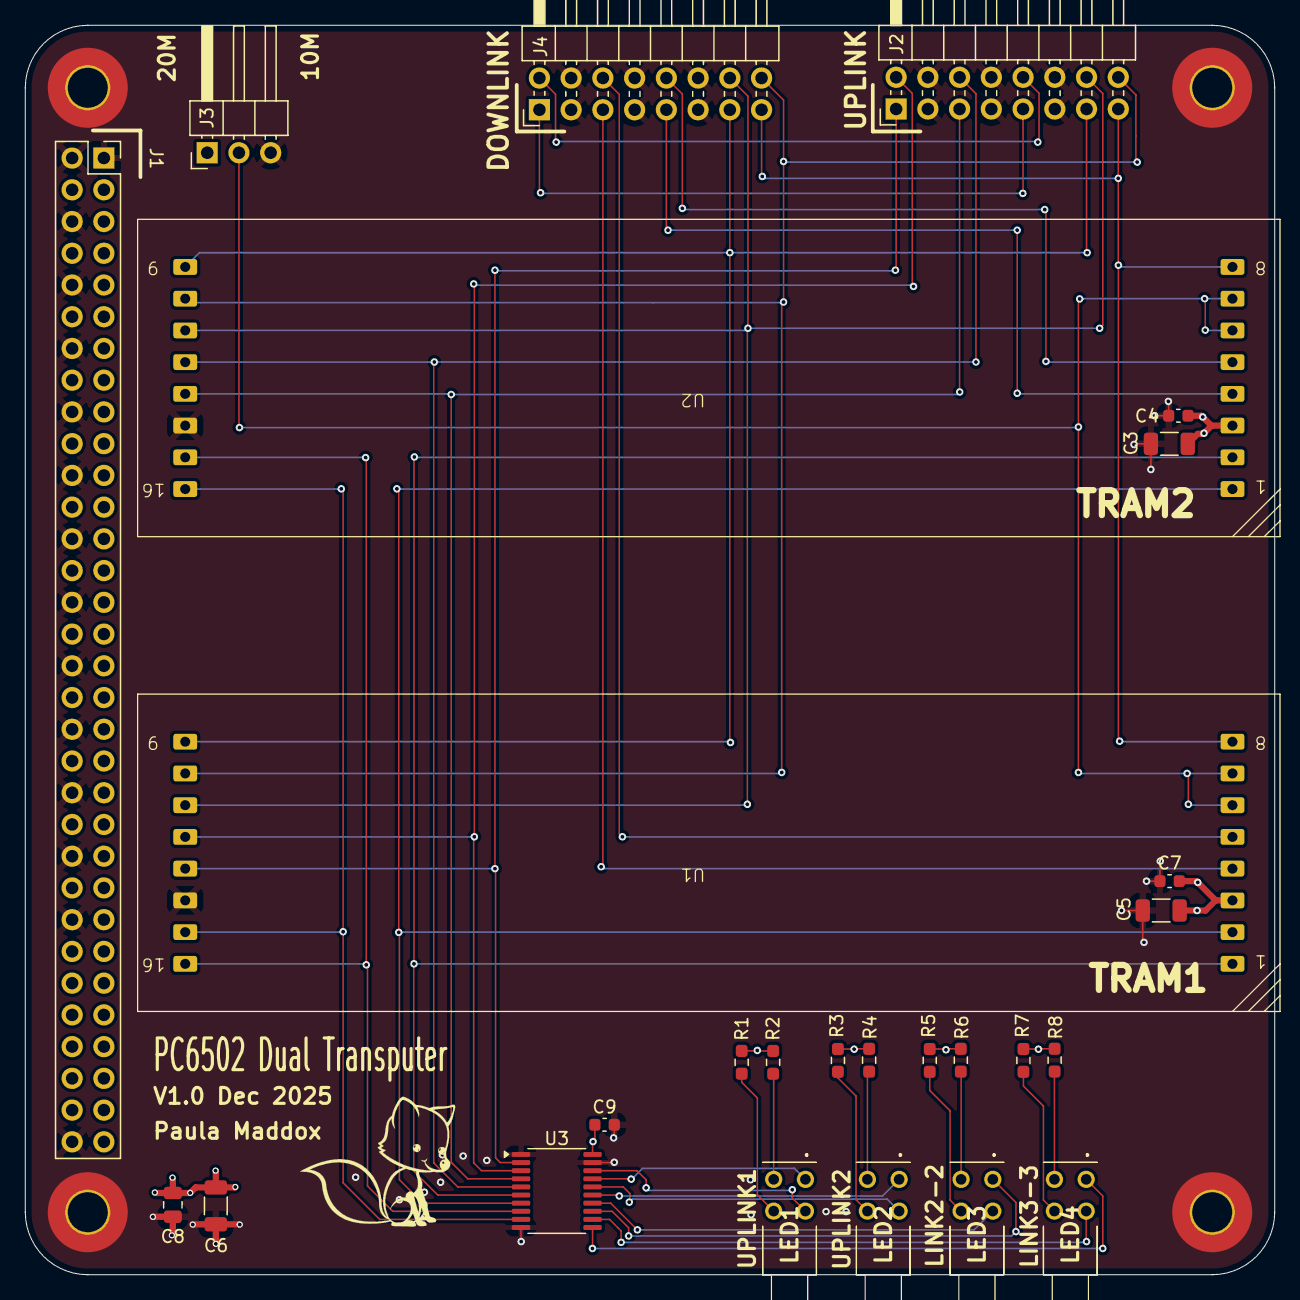
[picture p9: board PC6502-DUALTRANSPUTER.kicad_pcb from above]

Board: 4 copper layers, 100.0 x 100.0 mm, 31 parts (0 on the bottom side), 37 nets.
