TechPaula/PC6502/Schematics/PC6502-TRANSPUTER/PC6502-TRANSPUTER.kicad_pcb

## KiCad design Schematics/PC6502-TRANSPUTER/PC6502-TRANSPUTER.kicad_pcb (2025-12-24, last stored version)

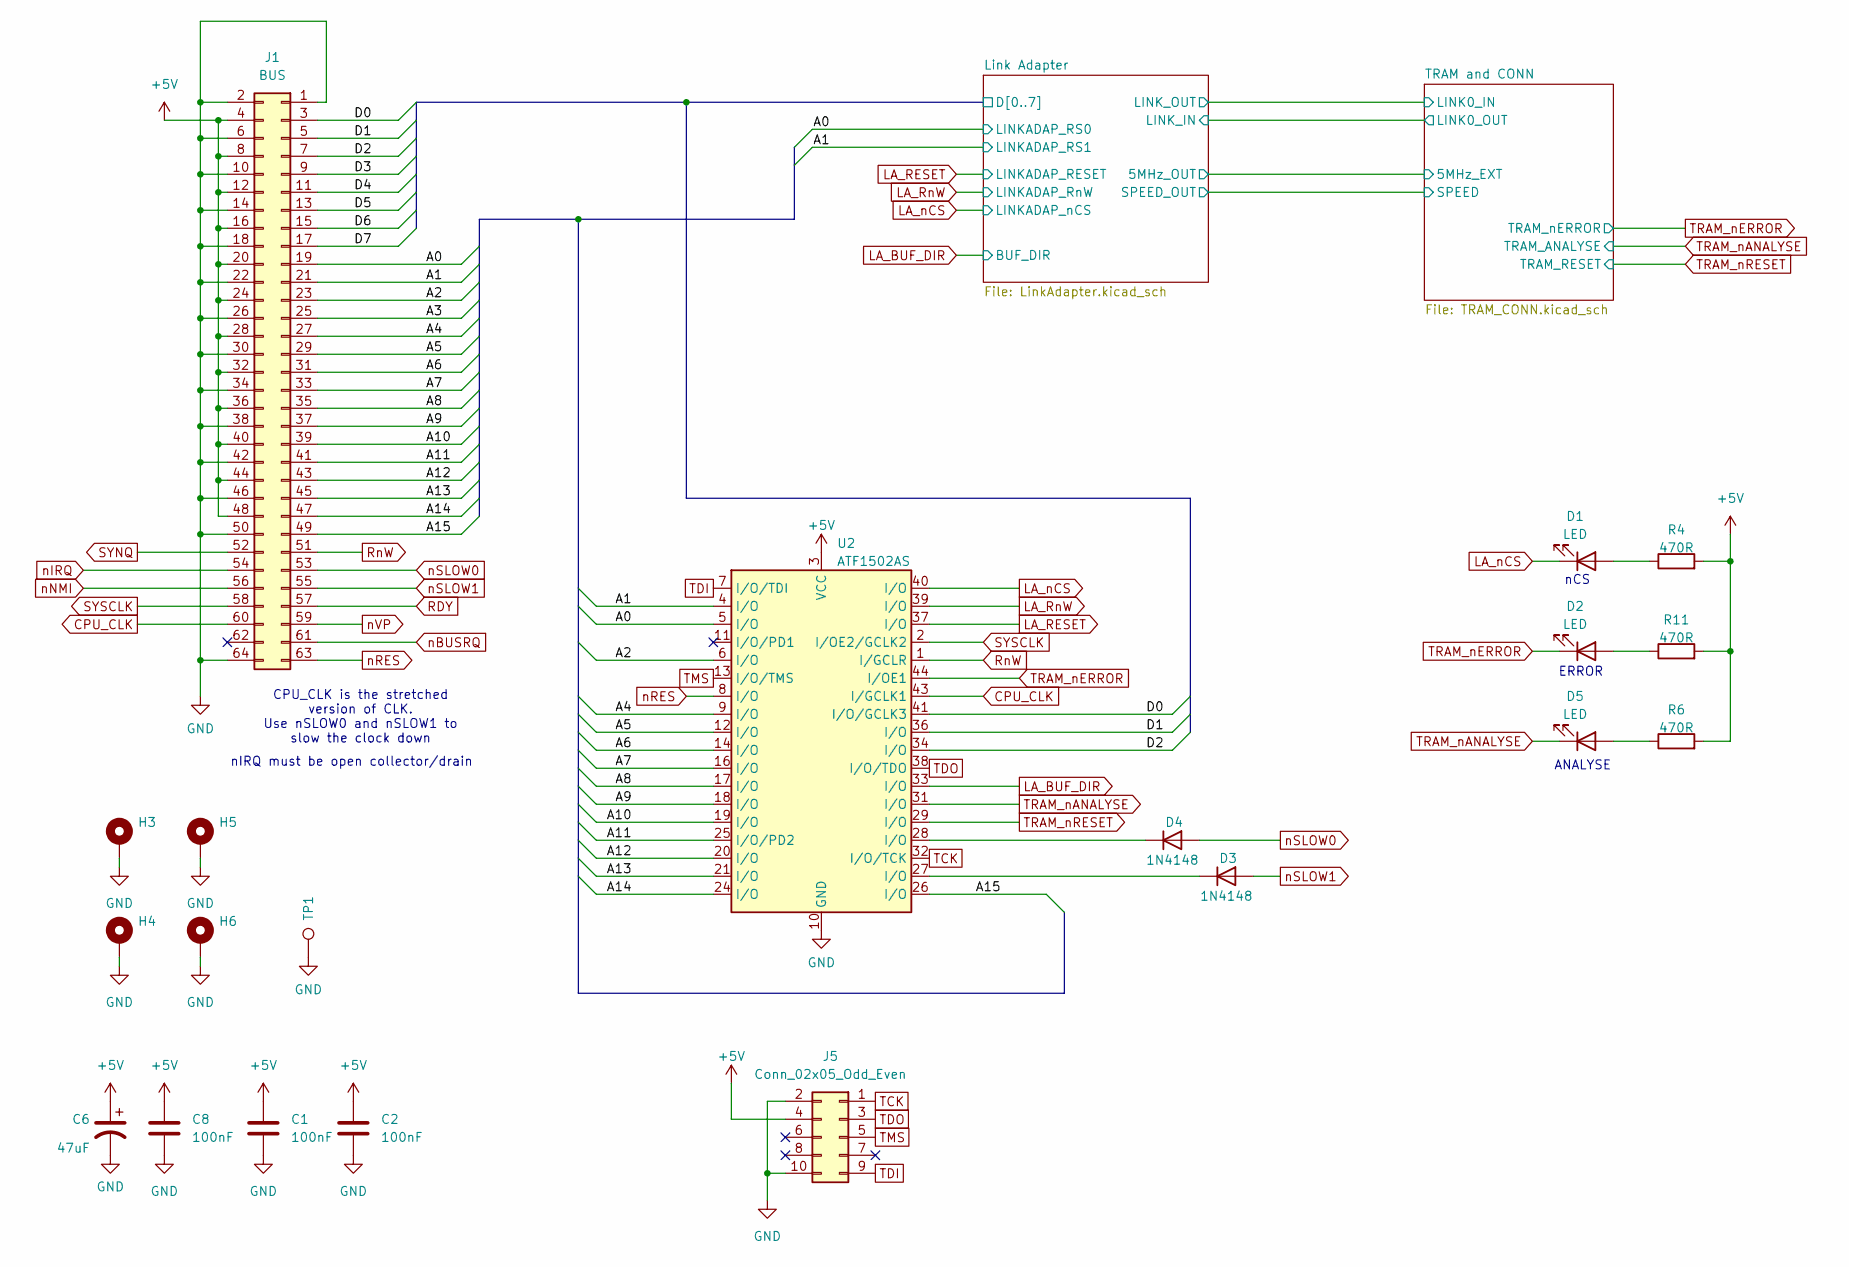
[picture p10: schematic PC6502-TRANSPUTER.kicad_sch]

Parts:
C1, C2: 100nF; C_0603_1608Metric
C6: 47uF; C_1206_3216Metric; LCSC C96123
C8: 100nF; C_0805_2012Metric
D1, D2, D5: LED; LTL4221NHBP; LCSC DNF
D3, D4: 1N4148; D_DO-35_SOD27_P7.62mm_Horizontal; LCSC DNF
H3, H4, H5, H6: MountingHole_Pad; MountingHole_3.2mm_M3_Pad_TopBottom; LCSC DNF
J1: BUS; PinSocket_2x32_P2.54mm_Vertical; LCSC DNF
J5: Conn_02x05_Odd_Even; PinHeader_2x05_P2.54mm_Vertical; LCSC DNF
R4, R6, R11: 470R; R_0603_1608Metric_Pad0.98x0.95mm_HandSolder; LCSC C23179
TP1: TestPoint; TestPoint_Loop_D1.80mm_Drill1.0mm_Beaded; LCSC DNF
U2: ATF1502AS; PLCC-44_THT-Socket; LCSC DNF

Connections:
+5V: C1.1, C2.1, C6.1, C8.1, J1.4, J1.8, J1.12, J1.16, J1.20, J1.24, J1.28, J1.32, J1.36, J1.40, J1.44, J1.48, J5.4, R4.2, R6.2, R11.2, U2.3 (VCC), U2.15 (VCC), U2.23 (VCC), U2.35 (VCC); also elsewhere on the board
/A0: J1.19, U2.5 (I/O); also elsewhere on the board
/A1: J1.21, U2.4 (I/O); also elsewhere on the board
/A2: J1.23, U2.6 (I/O)
/A3: J1.25
/A4: J1.27, U2.9 (I/O)
/A5: J1.29, U2.12 (I/O)
/A6: J1.31, U2.14 (I/O)
/A7: J1.33, U2.16 (I/O)
/A8: J1.35, U2.17 (I/O)
/A9: J1.37, U2.18 (I/O)
/A10: J1.39, U2.19 (I/O)
/A11: J1.41, U2.25 (I/O/PD2)
/A12: J1.43, U2.20 (I/O)
/A13: J1.45, U2.21 (I/O)
/A14: J1.47, U2.24 (I/O)
/A15: J1.49, U2.26 (I/O)
/Link Adapter/D0: J1.3, U2.41 (I/O/GCLK3); also elsewhere on the board
/Link Adapter/D1: J1.5, U2.36 (I/O); also elsewhere on the board
/Link Adapter/D2: J1.7, U2.34 (I/O); also elsewhere on the board
/Link Adapter/D3: J1.9; also elsewhere on the board
/Link Adapter/D4: J1.11; also elsewhere on the board
/Link Adapter/D5: J1.13; also elsewhere on the board
/Link Adapter/D6: J1.15; also elsewhere on the board
/Link Adapter/D7: J1.17; also elsewhere on the board
CPU_CLK: J1.60, U2.43 (I/GCLK1)
GND: C1.2, C2.2, C6.2, C8.2, H3.1, H4.1, H5.1, H6.1, J1.1, J1.2, J1.6, J1.10, J1.14, J1.18, J1.22, J1.26, J1.30, J1.34, J1.38, J1.42, J1.46, J1.50, J1.64, J5.2, J5.10, TP1.1, U2.10 (GND), U2.22 (GND), U2.30 (GND), U2.42 (GND); also elsewhere on the board
LA_BUF_DIR: U2.33 (I/O); also elsewhere on the board
LA_RESET: U2.37 (I/O); also elsewhere on the board
LA_RnW: U2.39 (I/O); also elsewhere on the board
LA_nCS: D1.1 (K), U2.40 (I/O); also elsewhere on the board
unnamed: D1.2 (A), R4.1
unnamed: D2.2 (A), R11.1
unnamed: D3.1 (K), U2.27 (I/O)
unnamed: D4.1 (K), U2.28 (I/O)
unnamed: D5.2 (A), R6.1
RDY: J1.57
RnW: J1.51, U2.1 (I/GCLR)
SYNQ: J1.52
SYSCLK: J1.58, U2.2 (I/OE2/GCLK2)
TCK: J5.1, U2.32 (I/O/TCK)
TDI: J5.9, U2.7 (I/O/TDI)
TDO: J5.3, U2.38 (I/O/TDO)
TMS: J5.5, U2.13 (I/O/TMS)
TRAM_nANALYSE: D5.1 (K), U2.31 (I/O); also elsewhere on the board
TRAM_nERROR: D2.1 (K), U2.44 (I/OE1); also elsewhere on the board
TRAM_nRESET: U2.29 (I/O); also elsewhere on the board
nBUSRQ: J1.61
nIRQ: J1.54
nNMI: J1.56
nRES: J1.63, U2.8 (I/O)
nSLOW0: D4.2 (A), J1.53
nSLOW1: D3.2 (A), J1.55
nVP: J1.59

Notes on the sheet:
ANALYSE
CPU_CLK is the stretched version of CLK. Use nSLOW0 and nSLOW1 to slow the clock down
nCS
ERROR
nIRQ must be open collector/drain

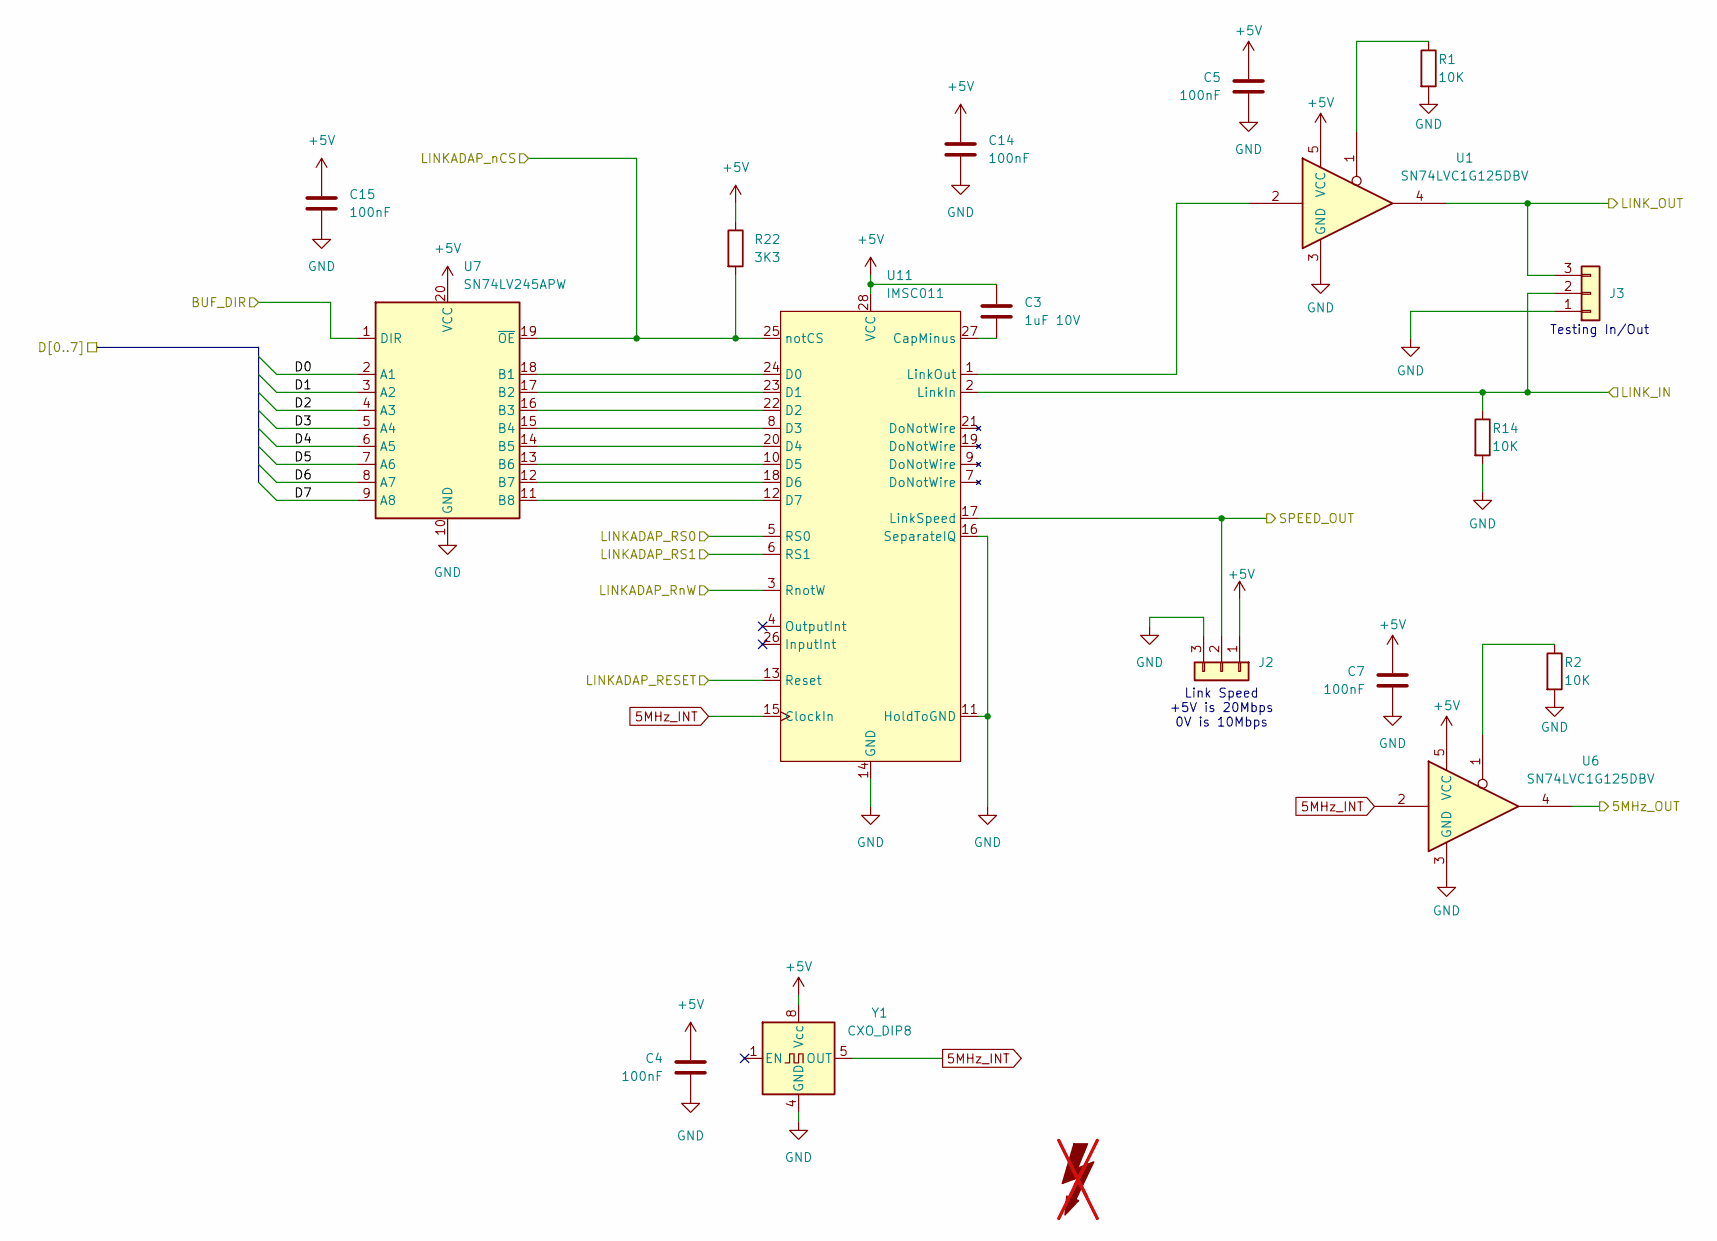
[picture p11: schematic LinkAdapter.kicad_sch]

Parts:
C3: 1uF 10V; C_0805_2012Metric
C4, C5, C7, C14, C15: 100nF; C_0603_1608Metric
FOX1: SYM_Flash_Large; Fox_avatar_18mm; LCSC DNF; not fitted
J2: Conn_01x03; PinHeader_1x03_P2.54mm_Horizontal
J3: Conn_01x03; PinHeader_1x03_P2.54mm_Vertical
R1, R2, R14: 10K; R_0603_1608Metric_Pad0.98x0.95mm_HandSolder; LCSC C25744
R22: 3K3; R_0603_1608Metric_Pad0.98x0.95mm_HandSolder; LCSC C25890
U1, U6: SN74LVC1G125DBV; SOT-23-5; Mouser PN 595-SN74LVC1G125DBVR
U7: SN74LV245APW; TSSOP-20_4.4x6.5mm_P0.65mm; Mouser PN 595-SN74LV245ATPWR
U11: IMSC011; DIP-28_W15.24mm
Y1: CXO_DIP8; Oscillator_DIP-8

Connections:
5MHz_INT: U6.2, U11.15 (ClockIn), Y1.5 (OUT)
+5V: C3.1, C4.1, C5.1, C7.1, C14.1, C15.1, J2.1, R22.1, U1.5 (VCC), U6.5 (VCC), U7.20 (VCC), U11.28 (VCC), Y1.8 (Vcc); also elsewhere on the board
/A0: U11.5 (RS0); also elsewhere on the board
/A1: U11.6 (RS1); also elsewhere on the board
/Link Adapter/5MHz_OUT: U6.4; also elsewhere on the board
/Link Adapter/D0: U7.2 (A1); also elsewhere on the board
/Link Adapter/D1: U7.3 (A2); also elsewhere on the board
/Link Adapter/D2: U7.4 (A3); also elsewhere on the board
/Link Adapter/D3: U7.5 (A4); also elsewhere on the board
/Link Adapter/D4: U7.6 (A5); also elsewhere on the board
/Link Adapter/D5: U7.7 (A6); also elsewhere on the board
/Link Adapter/D6: U7.8 (A7); also elsewhere on the board
/Link Adapter/D7: U7.9 (A8); also elsewhere on the board
/Link Adapter/LINK_IN: J3.2, R14.1, U11.2 (LinkIn); also elsewhere on the board
/Link Adapter/LINK_OUT: J3.3, U1.4; also elsewhere on the board
/Link Adapter/SPEED_OUT: J2.2, U11.17 (LinkSpeed); also elsewhere on the board
GND: C4.2, C5.2, C7.2, C14.2, C15.2, J2.3, J3.1, R1.2, R2.2, R14.2, U1.3 (GND), U6.3 (GND), U7.10 (GND), U11.11 (HoldToGND), U11.14 (GND), U11.16 (SeparateIQ), Y1.4 (GND); also elsewhere on the board
LA_BUF_DIR: U7.1 (DIR); also elsewhere on the board
LA_RESET: U11.13 (Reset); also elsewhere on the board
LA_RnW: U11.3 (RnotW); also elsewhere on the board
LA_nCS: R22.2, U7.19 (~OE), U11.25 (notCS); also elsewhere on the board
unnamed: R1.1, U1.1
unnamed: R2.1, U6.1
unnamed: C3.2, U11.27 (CapMinus)
unnamed: U7.18 (B1), U11.24 (D0)
unnamed: U7.17 (B2), U11.23 (D1)
unnamed: U7.16 (B3), U11.22 (D2)
unnamed: U7.15 (B4), U11.8 (D3)
unnamed: U7.14 (B5), U11.20 (D4)
unnamed: U7.13 (B6), U11.10 (D5)
unnamed: U7.12 (B7), U11.18 (D6)
unnamed: U7.11 (B8), U11.12 (D7)
unnamed: U1.2, U11.1 (LinkOut)

Notes on the sheet:
Link Speed +5V is 20Mbps 0V is 10Mbps
Testing In/Out

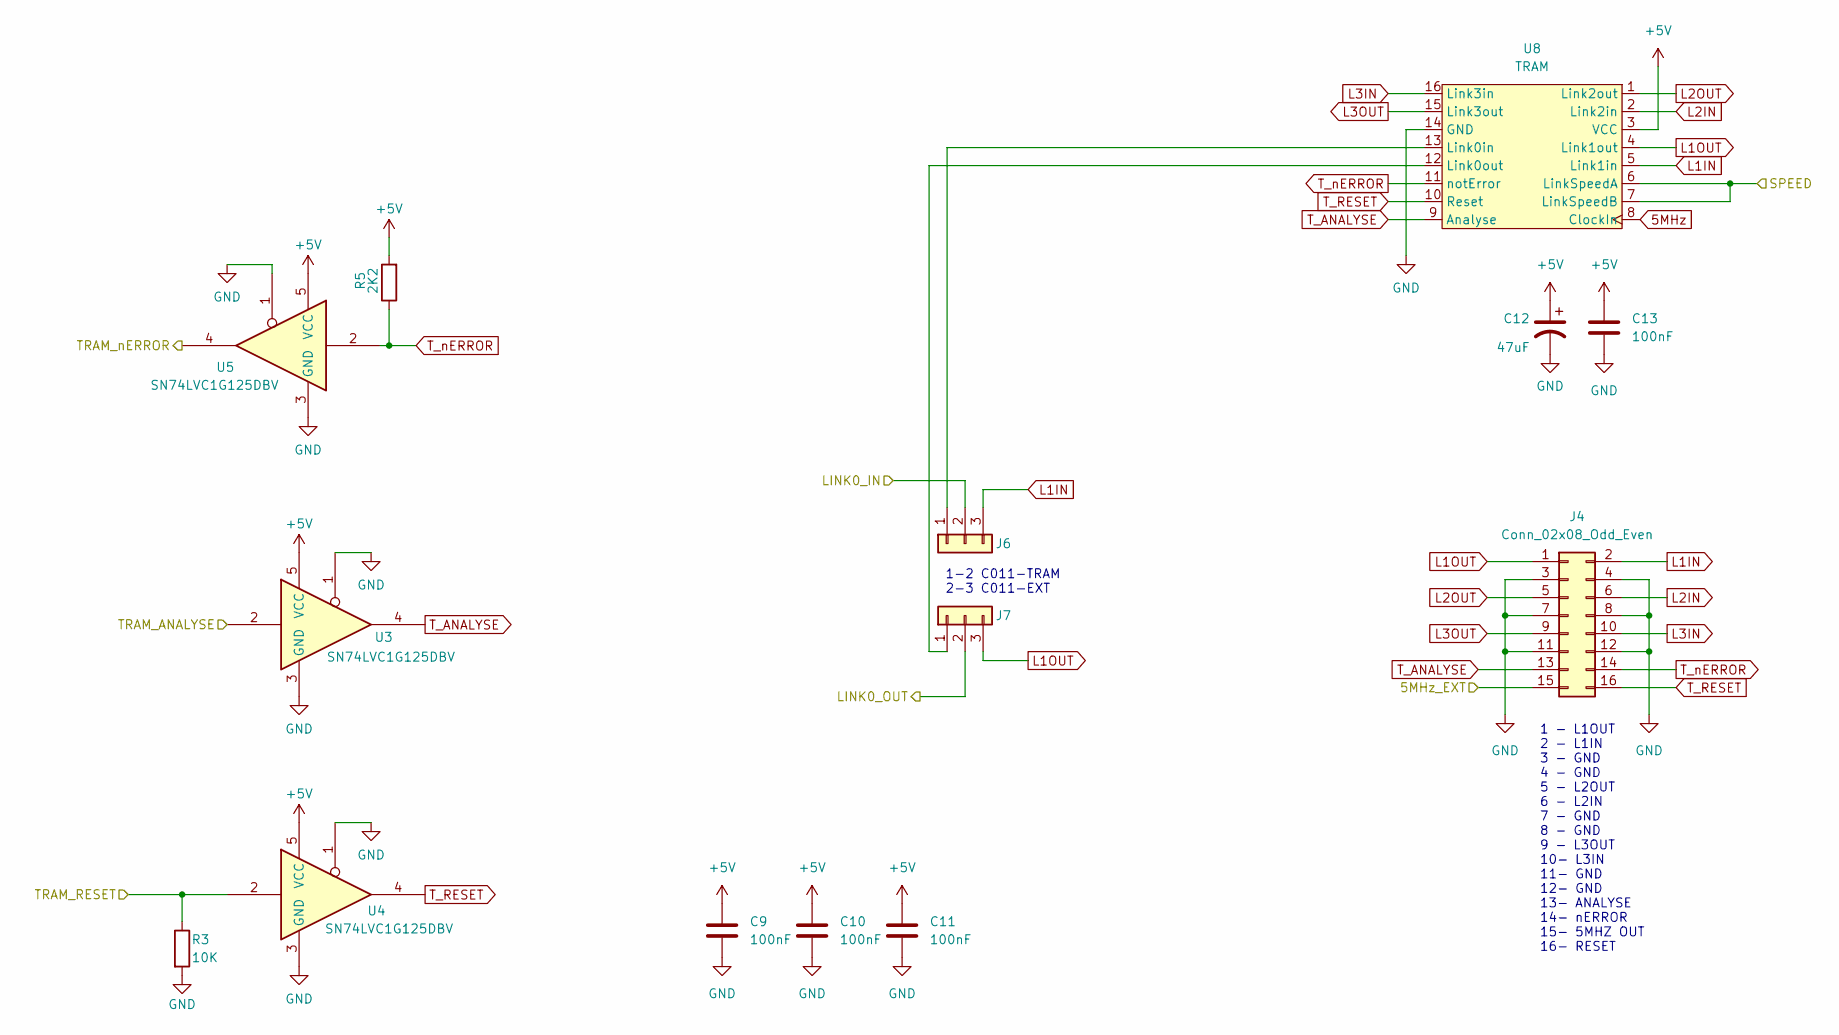
[picture p12: schematic TRAM_CONN.kicad_sch]

Parts:
C9, C10, C11, C13: 100nF; C_0603_1608Metric
C12: 47uF; C_1206_3216Metric; LCSC C96123
J4: Conn_02x08_Odd_Even; PinHeader_2x08_P2.54mm_Horizontal
J6, J7: Conn_01x03; PinHeader_1x03_P2.54mm_Vertical
R3: 10K; R_0603_1608Metric_Pad0.98x0.95mm_HandSolder; LCSC C25744
R5: 2K2; R_0603_1608Metric
U3, U4, U5: SN74LVC1G125DBV; SOT-23-5; Mouser PN 595-SN74LVC1G125DBVR
U8: TRAM

Connections:
5MHz: U8.8 (ClockIn)
+5V: C9.1, C10.1, C11.1, C12.1, C13.1, R5.2, U3.5 (VCC), U4.5 (VCC), U5.5 (VCC), U8.3 (VCC); also elsewhere on the board
/Link Adapter/5MHz_OUT: J4.15; also elsewhere on the board
/Link Adapter/LINK_IN: J7.2; also elsewhere on the board
/Link Adapter/LINK_OUT: J6.2; also elsewhere on the board
/Link Adapter/SPEED_OUT: U8.6 (LinkSpeedA), U8.7 (LinkSpeedB); also elsewhere on the board
GND: C9.2, C10.2, C11.2, C12.2, C13.2, J4.3, J4.4, J4.7, J4.8, J4.11, J4.12, R3.2, U3.1, U3.3 (GND), U4.1, U4.3 (GND), U5.1, U5.3 (GND), U8.14 (GND); also elsewhere on the board
L1IN: J4.2, J6.3, U8.5 (Link1in)
L1OUT: J4.1, J7.3, U8.4 (Link1out)
L2IN: J4.6, U8.2 (Link2in)
L2OUT: J4.5, U8.1 (Link2out)
L3IN: J4.10, U8.16 (Link3in)
L3OUT: J4.9, U8.15 (Link3out)
unnamed: J6.1, U8.13 (Link0in)
unnamed: J7.1, U8.12 (Link0out)
TRAM_nANALYSE: U3.2; also elsewhere on the board
TRAM_nERROR: U5.4; also elsewhere on the board
TRAM_nRESET: R3.1, U4.2; also elsewhere on the board
T_ANALYSE: J4.13, U3.4, U8.9 (Analyse)
T_RESET: J4.16, U4.4, U8.10 (Reset)
T_nERROR: J4.14, R5.1, U5.2, U8.11 (notError)

Notes on the sheet:
1 - L1OUT 2 - L1IN 3 - GND 4 - GND 5 - L2OUT 6 - L2IN 7 - GND 8 - GND 9 - L3OUT 10- L3IN 11- GND 12- GND 13- ANALYSE 14- nERROR 15- 5MHZ OUT 16- RESET
1-2 C011-TRAM 2-3 C011-EXT

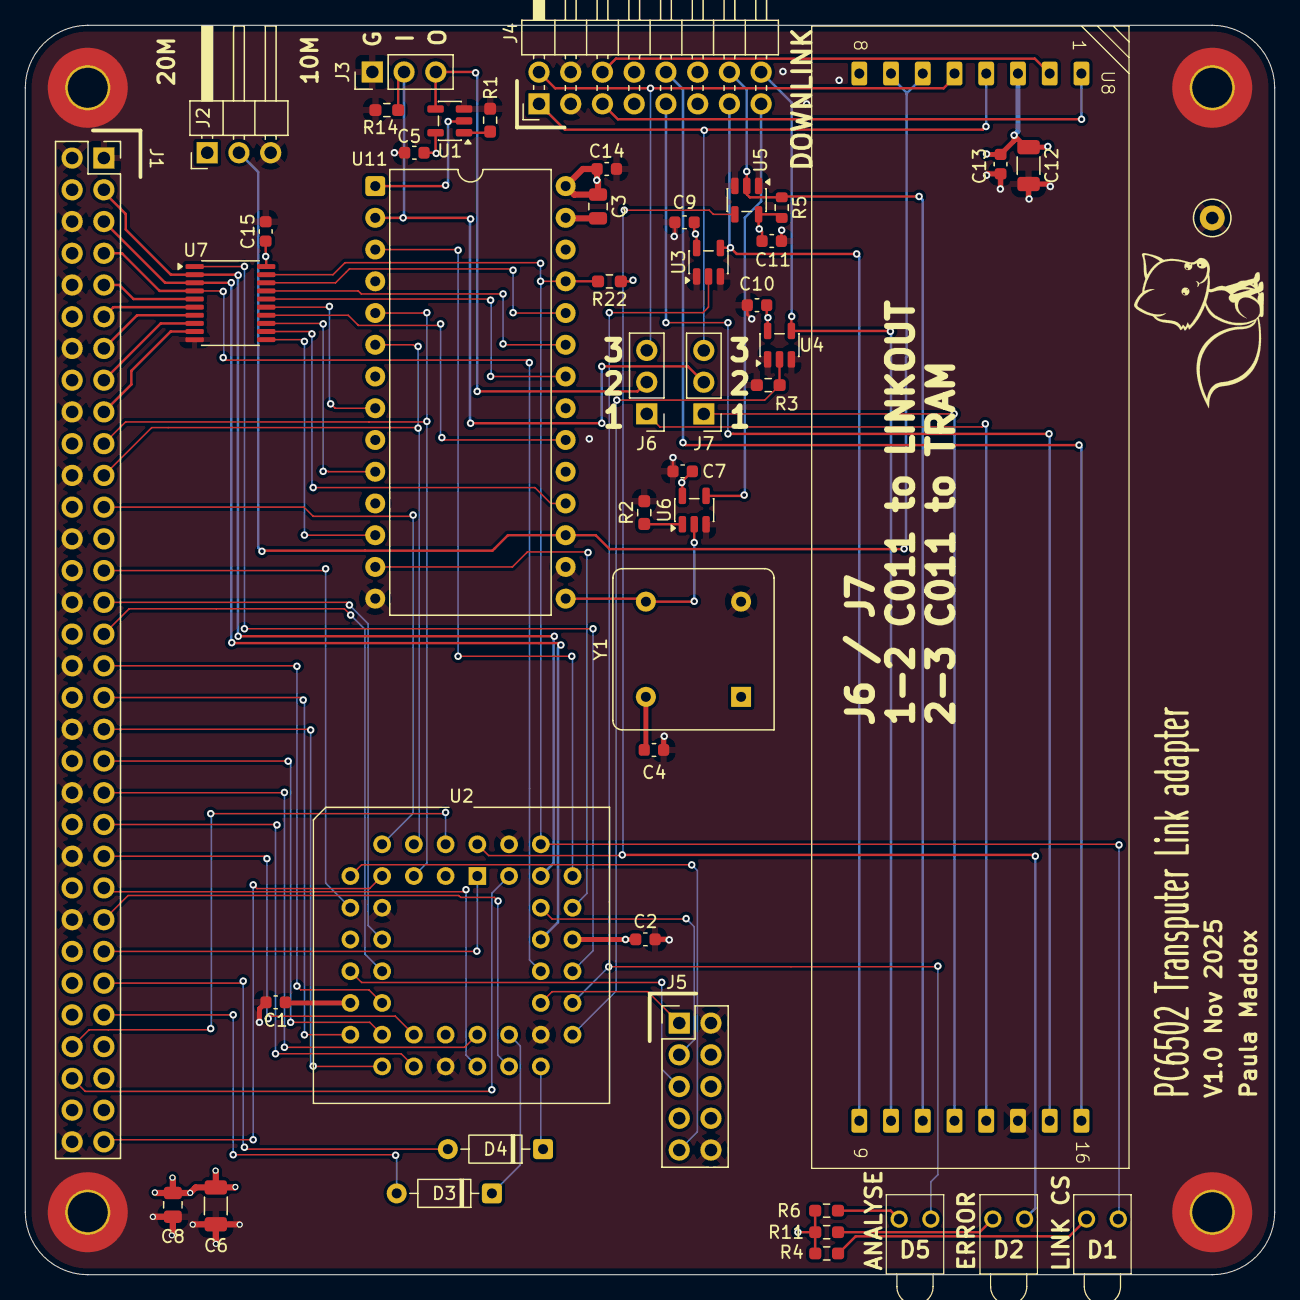
[picture p13: board PC6502-TRANSPUTER.kicad_pcb from above]

Board: 4 copper layers, 100.0 x 100.0 mm, 52 parts (0 on the bottom side), 75 nets.
