TechPaula/PC6502/Schematics/PC6502-CPU/PC6502-CPU.kicad_pcb

## KiCad design Schematics/PC6502-CPU/PC6502-CPU.kicad_pcb (2025-11-15, last stored version)

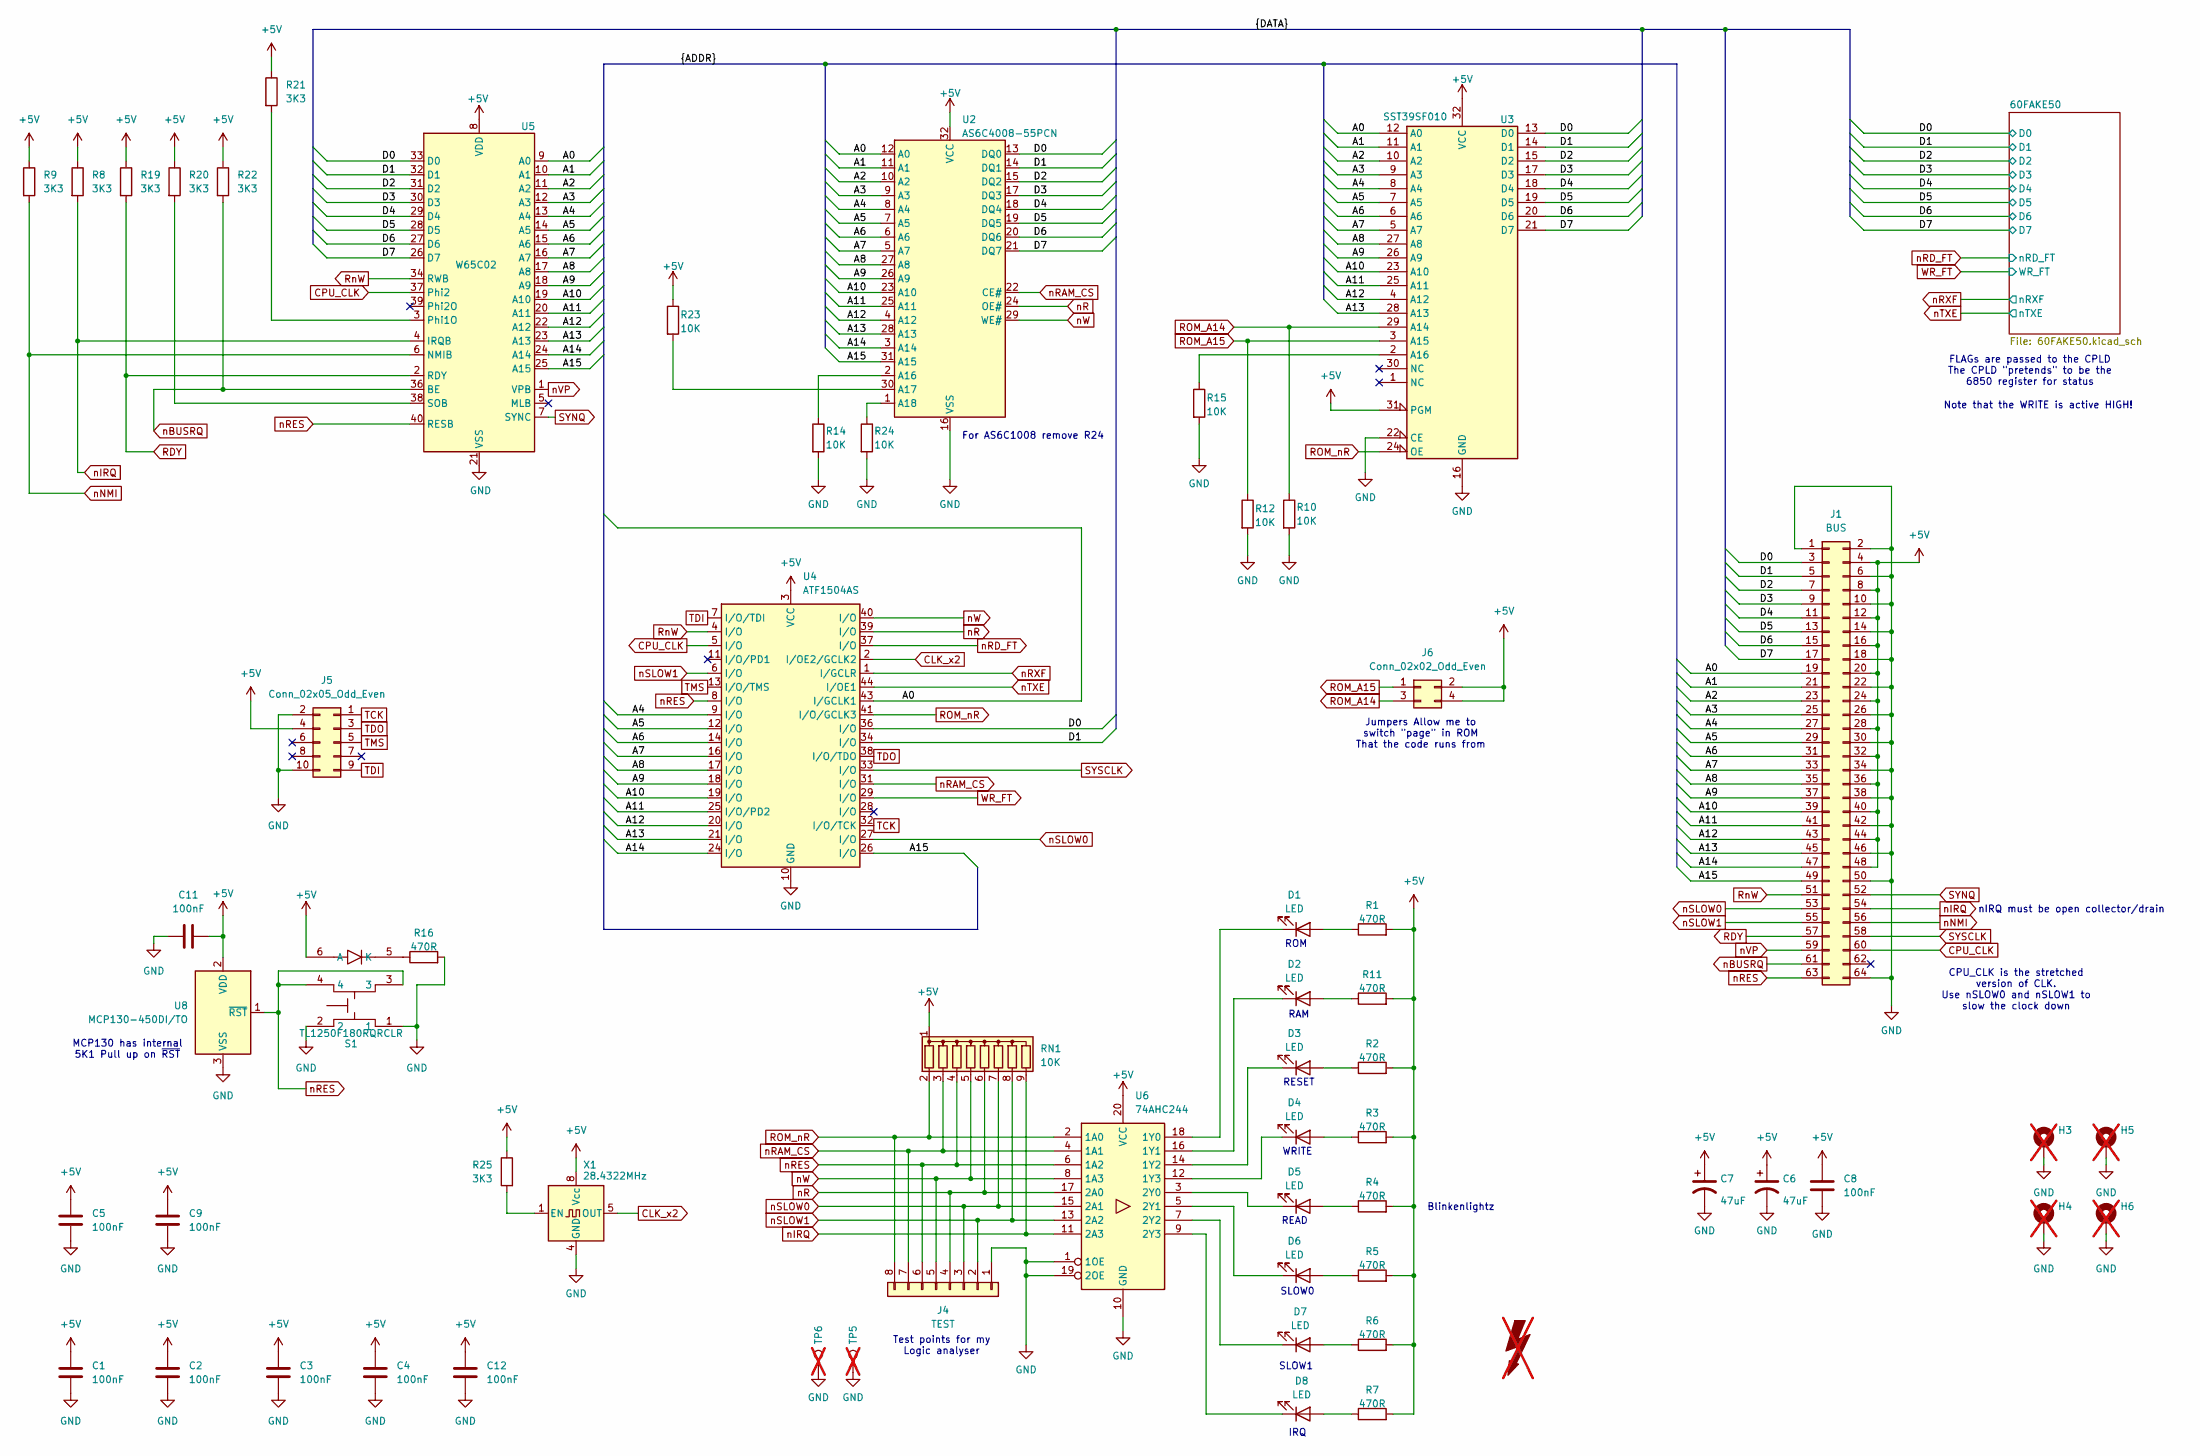
[picture p14: schematic PC6502-CPU.kicad_sch]

Parts:
C1, C2, C3, C4, C5, C8, C9, C11, C12: 100nF; C_0805_2012Metric; LCSC C49678
C6, C7: 47uF; C_1206_3216Metric; LCSC C96123
D1, D2, D3, D4, D5, D6, D7, D8: LED; LTL4221NHBP; LCSC DNF
FOX1: SYM_Flash_Large; Fox_avatar_18mm; LCSC DNF; not fitted
H3, H4, H5, H6: MountingHole_Pad; MountingHole_3.2mm_M3_Pad_TopBottom; LCSC DNF; not fitted
J1: BUS; PinSocket_2x32_P2.54mm_Vertical; LCSC DNF
J4: TEST; PinHeader_1x08_P2.54mm_Vertical; LCSC DNF
J5: Conn_02x05_Odd_Even; PinHeader_2x05_P2.54mm_Vertical; LCSC DNF
J6: Conn_02x02_Odd_Even; PinHeader_2x02_P2.54mm_Horizontal; LCSC D NF
R1, R2, R3, R4, R5, R6, R7, R11, R16: 470R; R_0603_1608Metric_Pad0.98x0.95mm_HandSolder; LCSC C23179
R8, R9, R19, R20, R22, R25: 3K3; R_0603_1608Metric_Pad0.98x0.95mm_HandSolder; LCSC C25890
R10, R12, R14, R15, R23, R24: 10K; R_0603_1608Metric_Pad0.98x0.95mm_HandSolder; LCSC C25744
R21: 3K3; R_0603_1608Metric_Pad0.98x0.95mm_HandSolder; LCSC DNF
RN1: 10K; R_Array_SIP9; LCSC DNF
S1: TL1250F180RQRCLR; Mouser Part Number 612-TL1250F180RQRCLR
TP5, TP6: TestPoint; TestPoint_Loop_D1.80mm_Drill1.0mm_Beaded; LCSC DNF; not fitted
U2: AS6C4008-55PCN; DIP-32_W15.24mm; LCSC DNF
U3: SST39SF010; DIP-32_W15.24mm_Socket; LCSC DNF
U4: ATF1504AS; PLCC-44_THT-Socket; LCSC DNF
U5: W65C02; DIP-40_W15.24mm_LongPads; LCSC DNF
U6: 74AHC244; DIP-20_W7.62mm_Socket; LCSC DNF
U8: MCP130-450DI/TO; TO-92_Inline; LCSC DNF
X1: 28.4322MHz; Oscillator_DIP-8; LCSC DNF

Connections:
+5V: C1.1, C2.1, C3.1, C4.1, C5.1, C6.1, C7.1, C8.1, C9.1, C11.2, C12.1, J1.4, J1.8, J1.12, J1.16, J1.20, J1.24, J1.28, J1.32, J1.36, J1.40, J1.44, J1.48, J5.4, J6.2, J6.4, R1.2, R2.2, R3.2, R4.2, R5.2, R6.2, R7.2, R8.1, R9.1, R11.2, R19.1, R20.1, R21.1, R22.1, R23.1, R25.1, RN1.1 (common), S1.6 (A), U2.32 (VCC), U3.31 (PGM), U3.32 (VCC), U4.3 (VCC), U4.15 (VCC), U4.23 (VCC), U4.35 (VCC), U5.8 (VDD), U6.20 (VCC), U8.2 (VDD), X1.8 (Vcc); also elsewhere on the board
/A0: J1.19, U2.12 (A0), U3.12 (A0), U4.43 (I/GCLK1), U5.9 (A0)
/A1: J1.21, U2.11 (A1), U3.11 (A1), U5.10 (A1)
/A2: J1.23, U2.10 (A2), U3.10 (A2), U5.11 (A2)
/A3: J1.25, U2.9 (A3), U3.9 (A3), U5.12 (A3)
/A4: J1.27, U2.8 (A4), U3.8 (A4), U4.9 (I/O), U5.13 (A4)
/A5: J1.29, U2.7 (A5), U3.7 (A5), U4.12 (I/O), U5.14 (A5)
/A6: J1.31, U2.6 (A6), U3.6 (A6), U4.14 (I/O), U5.15 (A6)
/A7: J1.33, U2.5 (A7), U3.5 (A7), U4.16 (I/O), U5.16 (A7)
/A8: J1.35, U2.27 (A8), U3.27 (A8), U4.17 (I/O), U5.17 (A8)
/A9: J1.37, U2.26 (A9), U3.26 (A9), U4.18 (I/O), U5.18 (A9)
/A10: J1.39, U2.23 (A10), U3.23 (A10), U4.19 (I/O), U5.19 (A10)
/A11: J1.41, U2.25 (A11), U3.25 (A11), U4.25 (I/O/PD2), U5.20 (A11)
/A12: J1.43, U2.4 (A12), U3.4 (A12), U4.20 (I/O), U5.22 (A12)
/A13: J1.45, U2.28 (A13), U3.28 (A13), U4.21 (I/O), U5.23 (A13)
/A14: J1.47, U2.3 (A14), U4.24 (I/O), U5.24 (A14)
/A15: J1.49, U2.31 (A15), U4.26 (I/O), U5.25 (A15)
/D0: J1.3, U2.13 (DQ0), U3.13 (D0), U4.36 (I/O), U5.33 (D0); also elsewhere on the board
/D1: J1.5, U2.14 (DQ1), U3.14 (D1), U4.34 (I/O), U5.32 (D1); also elsewhere on the board
/D2: J1.7, U2.15 (DQ2), U3.15 (D2), U5.31 (D2); also elsewhere on the board
/D3: J1.9, U2.17 (DQ3), U3.17 (D3), U5.30 (D3); also elsewhere on the board
/D4: J1.11, U2.18 (DQ4), U3.18 (D4), U5.29 (D4); also elsewhere on the board
/D5: J1.13, U2.19 (DQ5), U3.19 (D5), U5.28 (D5); also elsewhere on the board
/D6: J1.15, U2.20 (DQ6), U3.20 (D6), U5.27 (D6); also elsewhere on the board
/D7: J1.17, U2.21 (DQ7), U3.21 (D7), U5.26 (D7); also elsewhere on the board
CLK_x2: U4.2 (I/OE2/GCLK2), X1.5 (OUT)
CPU_CLK: J1.60, U4.5 (I/O), U5.37 (Phi2)
GND: C1.2, C2.2, C3.2, C4.2, C5.2, C6.2, C7.2, C8.2, C9.2, C11.1, C12.2, H3.1, H4.1, H5.1, H6.1, J1.1, J1.2, J1.6, J1.10, J1.14, J1.18, J1.22, J1.26, J1.30, J1.34, J1.38, J1.42, J1.46, J1.50, J1.64, J4.1, J5.2, J5.10, R10.2, R12.2, R14.2, R15.2, R16.2, R24.2, S1.1, S1.2, TP5.1, TP6.1, U2.16 (VSS), U3.16 (GND), U3.22 (CE), U4.10 (GND), U4.22 (GND), U4.30 (GND), U4.42 (GND), U5.21 (VSS), U6.1 (1OE), U6.10 (GND), U6.19 (2OE), U8.3 (VSS), X1.4 (GND); also elsewhere on the board
unnamed: D1.2 (A), R1.1
unnamed: D1.1 (K), U6.18 (1Y0)
unnamed: D2.2 (A), R11.1
unnamed: D2.1 (K), U6.16 (1Y1)
unnamed: D3.2 (A), R2.1
unnamed: D3.1 (K), U6.14 (1Y2)
unnamed: D4.2 (A), R3.1
unnamed: D4.1 (K), U6.12 (1Y3)
unnamed: D5.2 (A), R4.1
unnamed: D5.1 (K), U6.3 (2Y0)
unnamed: D6.2 (A), R5.1
unnamed: D6.1 (K), U6.5 (2Y1)
unnamed: D7.2 (A), R6.1
unnamed: D7.1 (K), U6.7 (2Y2)
unnamed: D8.2 (A), R7.1
unnamed: D8.1 (K), U6.9 (2Y3)
unnamed: R16.1, S1.5 (K)
unnamed: R14.1, U2.2 (A16)
unnamed: R23.2, U2.30 (A17)
unnamed: R24.1, U2.1 (A18)
unnamed: R15.1, U3.2 (A16)
unnamed: R21.2, U5.3 (Phi1O)
unnamed: R20.2, U5.38 (SOB)
unnamed: R25.2, X1.1 (EN)
RDY: J1.57, R19.2, U5.2 (RDY)
ROM_A14: J6.3, R10.1, U3.29 (A14)
ROM_A15: J6.1, R12.1, U3.3 (A15)
ROM_nR: J4.8, RN1.2 (R1), U3.24 (OE), U4.41 (I/O/GCLK3), U6.2 (1A0)
RnW: J1.51, U4.4 (I/O), U5.34 (RWB)
SYNQ: J1.52, U5.7 (SYNC)
SYSCLK: J1.58, U4.33 (I/O)
TCK: J5.1, U4.32 (I/O/TCK)
TDI: J5.9, U4.7 (I/O/TDI)
TDO: J5.3, U4.38 (I/O/TDO)
TMS: J5.5, U4.13 (I/O/TMS)
WR_FT: U4.29 (I/O); also elsewhere on the board
nBUSRQ: J1.61, R22.2, U5.36 (BE)
nIRQ: J1.54, R8.2, RN1.9 (R8), U5.4 (IRQB), U6.11 (2A3)
nNMI: J1.56, R9.2, U5.6 (NMIB)
nR: J4.4, RN1.6 (R5), U2.24 (OE#), U4.39 (I/O), U6.17 (2A0)
nRAM_CS: J4.7, RN1.3 (R2), U2.22 (CE#), U4.31 (I/O), U6.4 (1A1)
nRD_FT: U4.37 (I/O); also elsewhere on the board
nRES: J1.63, J4.6, RN1.4 (R3), S1.3, S1.4, U4.8 (I/O), U5.40 (RESB), U6.6 (1A2), U8.1 (~RST)
nRXF: U4.1 (I/GCLR); also elsewhere on the board
nSLOW0: J1.53, J4.3, RN1.7 (R6), U4.27 (I/O), U6.15 (2A1)
nSLOW1: J1.55, J4.2, RN1.8 (R7), U4.6 (I/O), U6.13 (2A2)
nTXE: U4.44 (I/OE1); also elsewhere on the board
nVP: J1.59, U5.1 (VPB)
nW: J4.5, RN1.5 (R4), U2.29 (WE#), U4.40 (I/O), U6.8 (1A3)

Notes on the sheet:
FLAGs are passed to the CPLD The CPLD "pretends" to be the 6850 register for status
Test points for my Logic analyser
Blinkenlightz
READ
MCP130 has internal 5K1 Pull up on ~{RST}
CPU_CLK is the stretched version of CLK. Use nSLOW0 and nSLOW1 to slow the clock down
SLOW1
Jumpers Allow me to switch "page" in ROM That the code runs from
WRITE
nIRQ must be open collector/drain
RAM
Note that the WRITE is active HIGH!
SLOW0
ROM
For AS6C1008 remove R24
RESET
IRQ

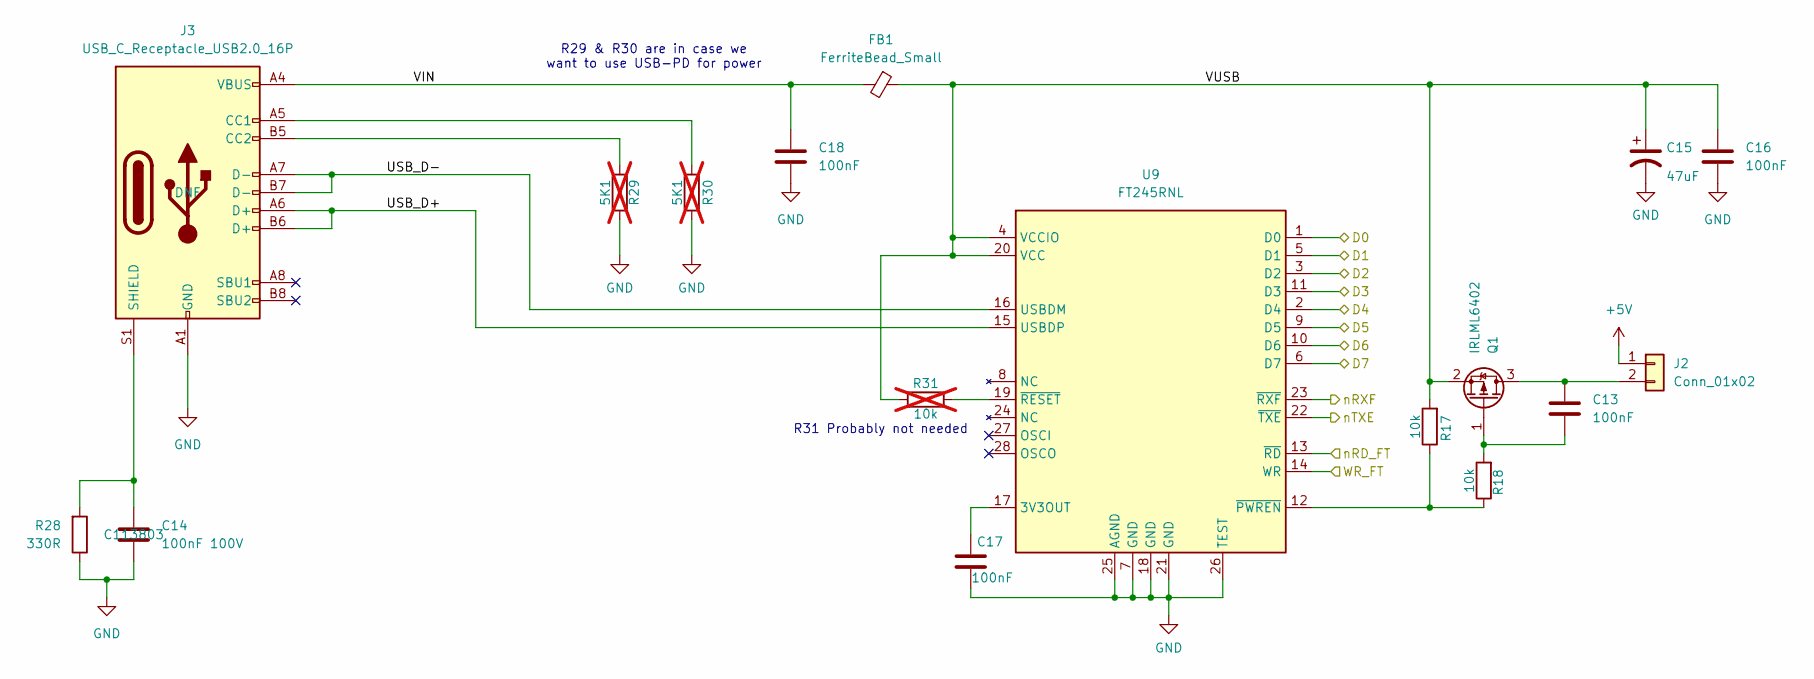
[picture p15: schematic 60FAKE50.kicad_sch]

Parts:
C13, C17: 100nF; C_0603_1608Metric_Pad1.08x0.95mm_HandSolder; LCSC C113803
C14: 100nF 100V; C_0603_1608Metric; LCSC C113803
C15: 47uF; C_1206_3216Metric; LCSC C96123
C16, C18: 100nF; C_0805_2012Metric; LCSC C49678
FB1: FerriteBead_Small; L_0805_2012Metric_Pad1.05x1.20mm_HandSolder; LCSC DNF
J2: Conn_01x02; PinHeader_1x02_P2.54mm_Horizontal; LCSC DNF
J3: USB_C_Receptacle_USB2.0_16P; USB_C_Receptacle_HCTL_HC-TYPE-C-16P-01A; LCSC DNF
Q1: IRLML6402; SOT-23; LCSC C2593
R17, R18: 10k; R_0603_1608Metric_Pad0.98x0.95mm_HandSolder; LCSC C25744
R28: 330R; R_0402_1005Metric; LCSC C25104
R29, R30: 5K1; R_0603_1608Metric_Pad0.98x0.95mm_HandSolder; LCSC DNF; not fitted
R31: 10k; R_0603_1608Metric_Pad0.98x0.95mm_HandSolder; LCSC DNF; not fitted
U9: FT245RNL; SSOP-28_5.3x10.2mm_P0.65mm; LCSC C6558294

Connections:
+5V: J2.1; also elsewhere on the board
/60FAKE50/USB_D+: J3.A6 (D+), J3.B6 (D+), U9.15 (USBDP)
/60FAKE50/USB_D-: J3.A7 (D-), J3.B7 (D-), U9.16 (USBDM)
/60FAKE50/VIN: C18.1, FB1.2, J3.A4 (VBUS), J3.A9 (VBUS), J3.B4 (VBUS), J3.B9 (VBUS)
/60FAKE50/VUSB: C15.1, C16.1, FB1.1, Q1.2 (S), R17.2, R31.2, U9.4 (VCCIO), U9.20 (VCC)
/D0: U9.1 (D0); also elsewhere on the board
/D1: U9.5 (D1); also elsewhere on the board
/D2: U9.3 (D2); also elsewhere on the board
/D3: U9.11 (D3); also elsewhere on the board
/D4: U9.2 (D4); also elsewhere on the board
/D5: U9.9 (D5); also elsewhere on the board
/D6: U9.10 (D6); also elsewhere on the board
/D7: U9.6 (D7); also elsewhere on the board
GND: C14.2, C15.2, C16.2, C17.2, C18.2, J3.A1 (GND), J3.A12 (GND), J3.B1 (GND), J3.B12 (GND), R28.1, R29.1, R30.1, U9.7 (GND), U9.18 (GND), U9.21 (GND), U9.25 (AGND), U9.26 (TEST); also elsewhere on the board
unnamed: C13.1, J2.2, Q1.3 (D)
unnamed: J3.A5 (CC1), R30.2
unnamed: J3.B5 (CC2), R29.2
unnamed: C14.1, J3.S1 (SHIELD), R28.2
unnamed: C13.2, Q1.1 (G), R18.2
unnamed: C17.1, U9.17 (3V3OUT)
unnamed: R17.1, R18.1, U9.12 (~PWREN)
unnamed: R31.1, U9.19 (~RESET)
WR_FT: U9.14 (WR); also elsewhere on the board
nRD_FT: U9.13 (~RD); also elsewhere on the board
nRXF: U9.23 (~RXF); also elsewhere on the board
nTXE: U9.22 (~TXE); also elsewhere on the board

Notes on the sheet:
R29 & R30 are in case we want to use USB-PD for power
R31 Probably not needed
