TechPaula/PC6502/Schematics/PC6502-CPU/PC6502-CPU.kicad_pcb

## KiCad design Schematics/PC6502-CPU/PC6502-CPU.kicad_pcb (continued)

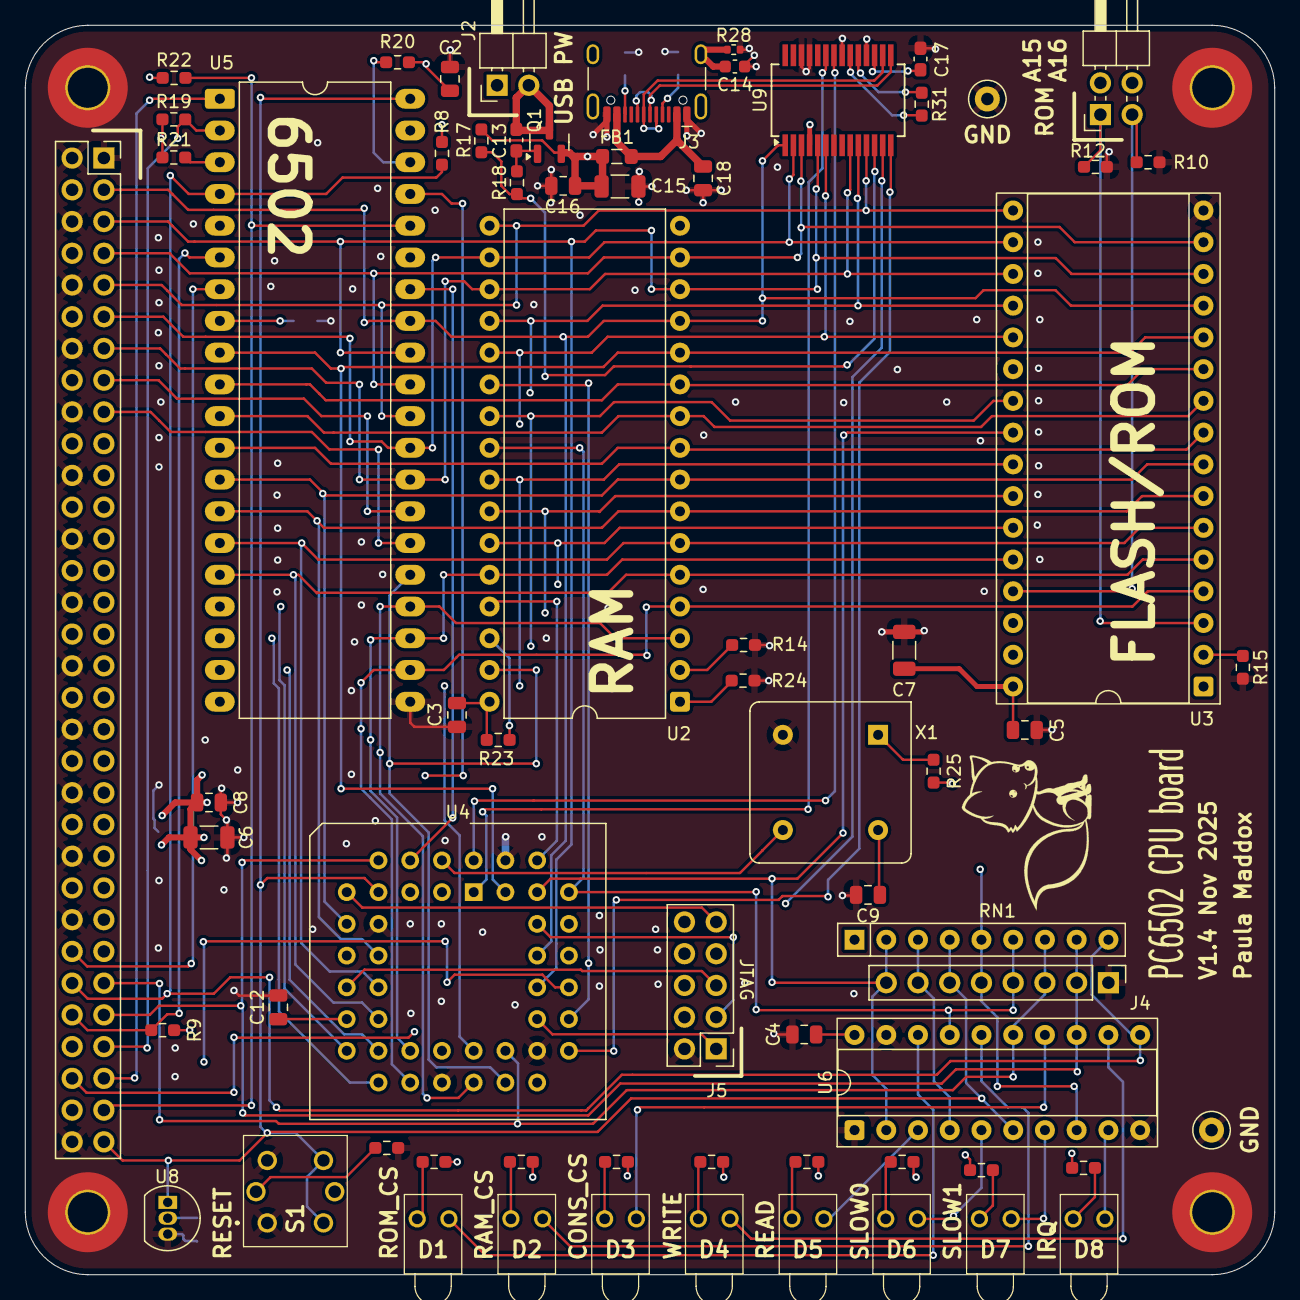
[picture p16: board PC6502-CPU.kicad_pcb from above]

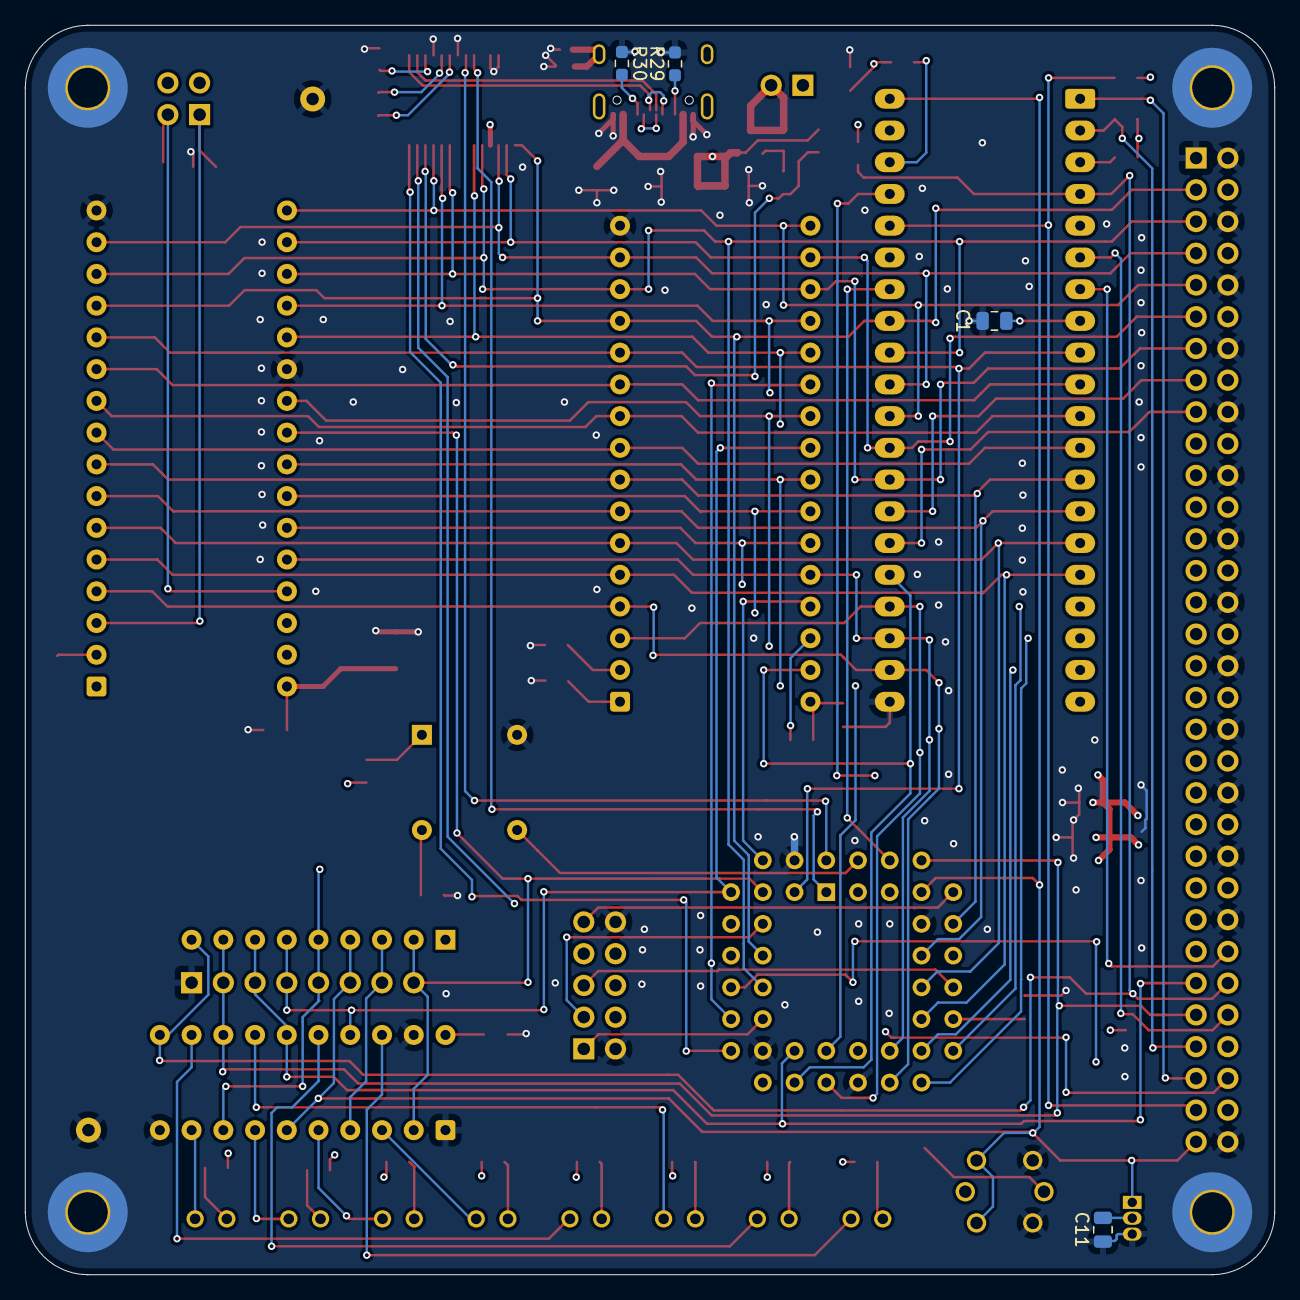
[picture p17: board PC6502-CPU.kicad_pcb from below]

Board: 4 copper layers, 100.0 x 100.0 mm, 78 parts (4 on the bottom side), 89 nets.
