TechPaula/PC6502/Schematics/PMOD-LEVEL-SHIFTER/PMOD-LEVEL-SHIFTER.kicad_pcb

## KiCad design Schematics/PMOD-LEVEL-SHIFTER/PMOD-LEVEL-SHIFTER.kicad_pcb (2025-11-02, last stored version)

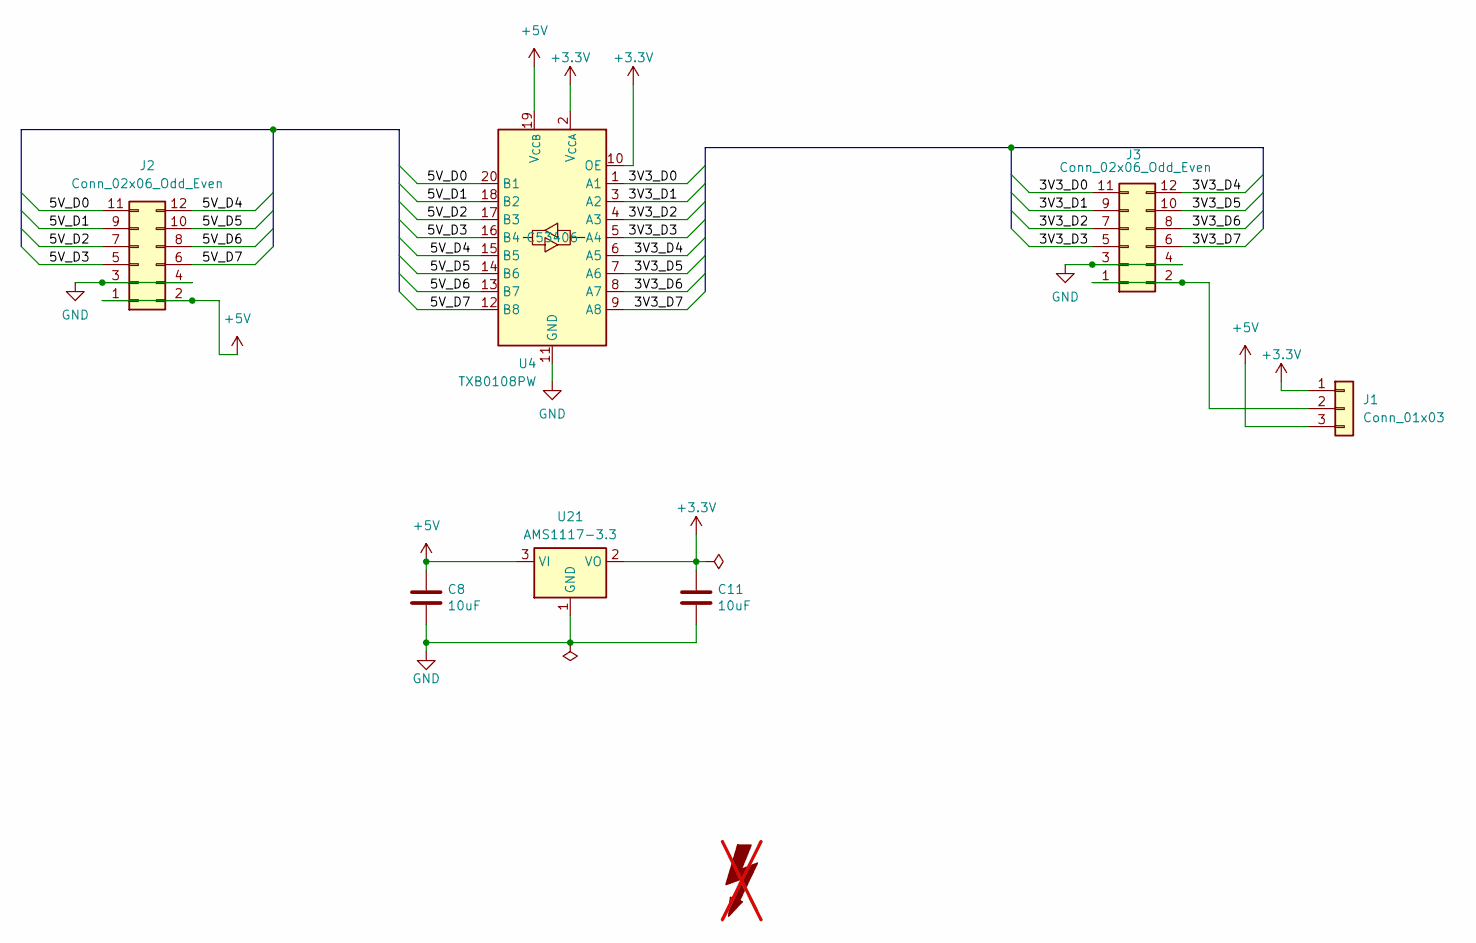
[picture p23: schematic PMOD-LEVEL-SHIFTER.kicad_sch]

Parts:
C8, C11: 10uF; C_0805_2012Metric; ManufacturerPN C3216X7R1E475M085AB; LCSC C15850
FOX1: SYM_Flash_Large; Fox_avatar_18mm; LCSC DNF; not fitted
J1: Conn_01x03; PinHeader_1x03_P2.54mm_Vertical
J2: Conn_02x06_Odd_Even; PinHeader_2x06_P2.54mm_Horizontal
J3: Conn_02x06_Odd_Even; PinSocket_2x06_P2.54mm_Horizontal
U4: TXB0108PW; TSSOP-20_4.4x6.5mm_P0.65mm; LCSC C53406
U21: AMS1117-3.3; SOT-223-3_TabPin2; LCSC C6186

Connections:
+3.3V: C11.1, J1.1, U4.2 (V_{CCA}), U4.10 (OE), U21.2 (VO)
+5V: C8.1, J1.3, J2.1, J2.2, U4.19 (V_{CCB}), U21.3 (VI)
/3V3_D0: J3.11, U4.1 (A1)
/3V3_D1: J3.9, U4.3 (A2)
/3V3_D2: J3.7, U4.4 (A3)
/3V3_D3: J3.5, U4.5 (A4)
/3V3_D4: J3.12, U4.6 (A5)
/3V3_D5: J3.10, U4.7 (A6)
/3V3_D6: J3.8, U4.8 (A7)
/3V3_D7: J3.6, U4.9 (A8)
/5V_D0: J2.11, U4.20 (B1)
/5V_D1: J2.9, U4.18 (B2)
/5V_D2: J2.7, U4.17 (B3)
/5V_D3: J2.5, U4.16 (B4)
/5V_D4: J2.12, U4.15 (B5)
/5V_D5: J2.10, U4.14 (B6)
/5V_D6: J2.8, U4.13 (B7)
/5V_D7: J2.6, U4.12 (B8)
GND: C8.2, C11.2, J2.3, J2.4, J3.3, J3.4, U4.11 (GND), U21.1 (GND)
unnamed: J1.2, J3.1, J3.2

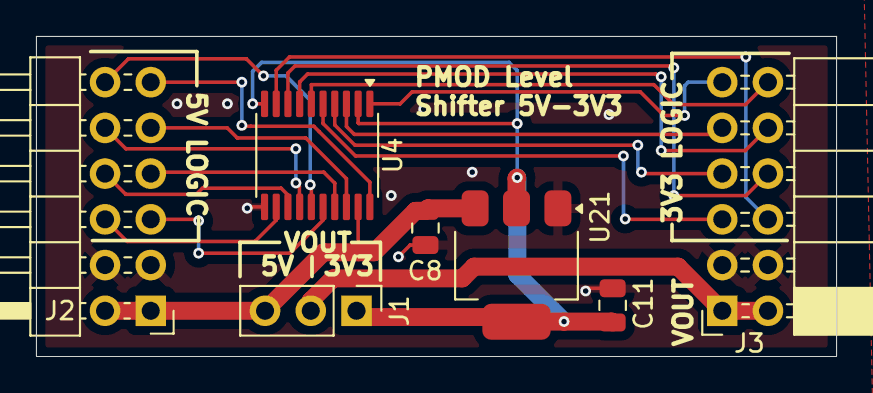
[picture p24: board PMOD-LEVEL-SHIFTER.kicad_pcb from above]

Board: 4 copper layers, 44.5 x 17.8 mm, 8 parts (1 on the bottom side), 20 nets.
