TechPaula/PC6502/Schematics/PC6502-FM-SPEECH/PC6502-FM-SPEECH.kicad_pcb

## KiCad design Schematics/PC6502-FM-SPEECH/PC6502-FM-SPEECH.kicad_pcb (2025-10-24, last stored version)

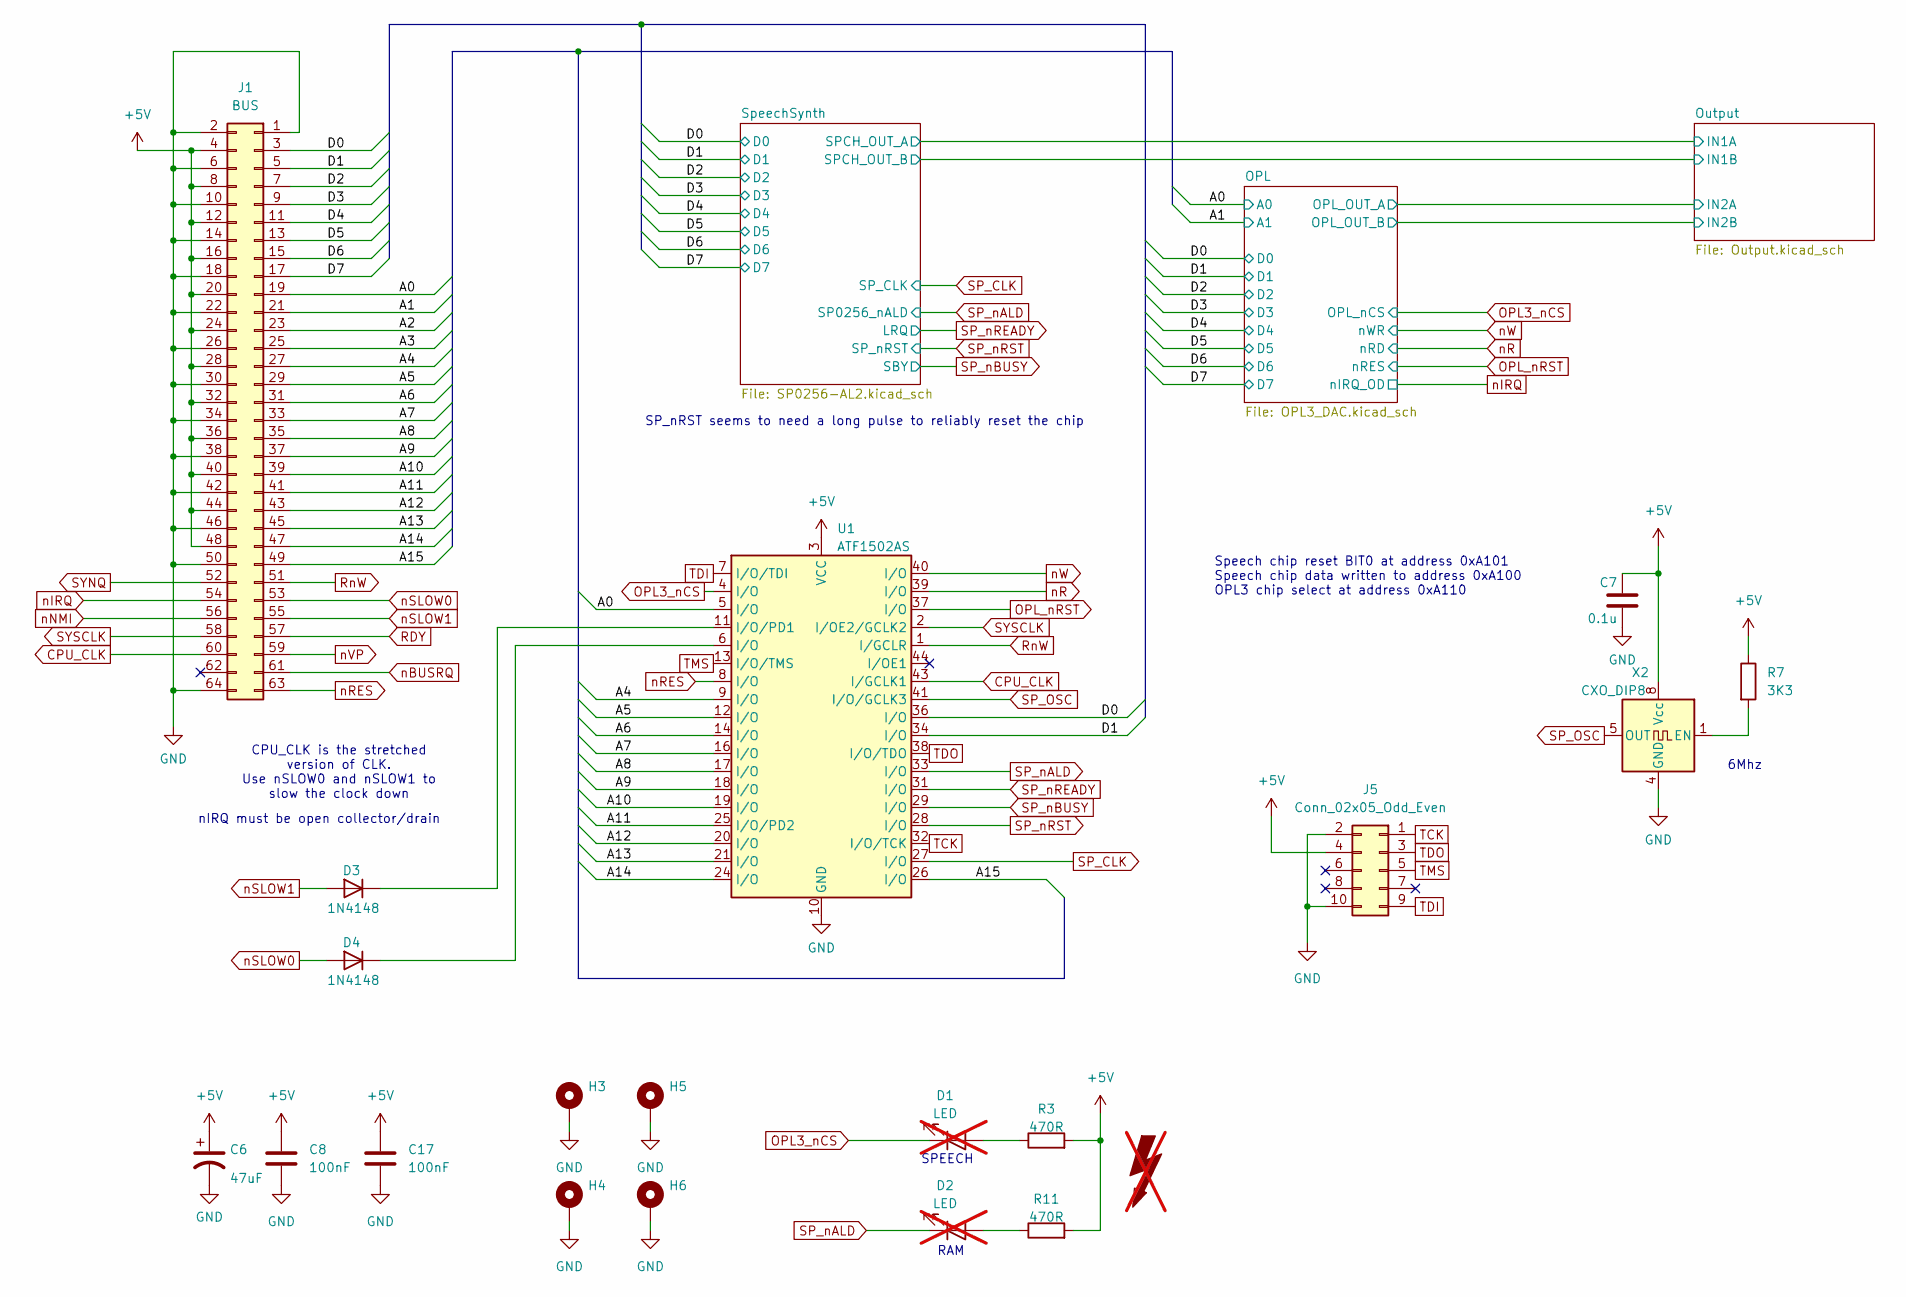
[picture p25: schematic PC6502-FM-SPEECH.kicad_sch]

Parts:
C6: 47uF; C_1206_3216Metric; LCSC C96123
C7: 0.1u; C_0603_1608Metric; ManufacturerPN C0603C104K3RAC7867
C8, C17: 100nF; C_0603_1608Metric
D1, D2: LED; LTL4221NHBP; LCSC DNF; not fitted
D3, D4: 1N4148; D_DO-35_SOD27_P7.62mm_Horizontal; LCSC DNF
FOX1: SYM_Flash_Large; Fox_avatar_18mm; LCSC DNF; not fitted
H3, H4, H5, H6: MountingHole_Pad; MountingHole_3.2mm_M3_Pad_TopBottom; LCSC DNF
J1: BUS; PinSocket_2x32_P2.54mm_Vertical; LCSC DNF
J5: Conn_02x05_Odd_Even; PinHeader_2x05_P2.54mm_Vertical; LCSC DNF
R3, R11: 470R; R_0603_1608Metric_Pad0.98x0.95mm_HandSolder; LCSC C23179
R7: 3K3; R_0603_1608Metric_Pad0.98x0.95mm_HandSolder; LCSC C25890
U1: ATF1502AS; PLCC-44_THT-Socket; LCSC DNF
X2: CXO_DIP8; Oscillator_DIP-8; LCSC DNF

Connections:
+5V: C6.1, C7.1, C8.1, C17.1, J1.4, J1.8, J1.12, J1.16, J1.20, J1.24, J1.28, J1.32, J1.36, J1.40, J1.44, J1.48, J5.4, R3.2, R7.1, R11.2, U1.3 (VCC), U1.15 (VCC), U1.23 (VCC), U1.35 (VCC), X2.8 (Vcc); also elsewhere on the board
/A0: J1.19, U1.5 (I/O); also elsewhere on the board
/A1: J1.21; also elsewhere on the board
/A2: J1.23
/A3: J1.25
/A4: J1.27, U1.9 (I/O)
/A5: J1.29, U1.12 (I/O)
/A6: J1.31, U1.14 (I/O)
/A7: J1.33, U1.16 (I/O)
/A8: J1.35, U1.17 (I/O)
/A9: J1.37, U1.18 (I/O)
/A10: J1.39, U1.19 (I/O)
/A11: J1.41, U1.25 (I/O/PD2)
/A12: J1.43, U1.20 (I/O)
/A13: J1.45, U1.21 (I/O)
/A14: J1.47, U1.24 (I/O)
/A15: J1.49, U1.26 (I/O)
/D0: J1.3, U1.36 (I/O); also elsewhere on the board
/D1: J1.5, U1.34 (I/O); also elsewhere on the board
/D2: J1.7; also elsewhere on the board
/D3: J1.9; also elsewhere on the board
/D4: J1.11; also elsewhere on the board
/D5: J1.13; also elsewhere on the board
/D6: J1.15; also elsewhere on the board
/D7: J1.17; also elsewhere on the board
CPU_CLK: J1.60, U1.43 (I/GCLK1)
GND: C6.2, C7.2, C8.2, C17.2, H3.1, H4.1, H5.1, H6.1, J1.1, J1.2, J1.6, J1.10, J1.14, J1.18, J1.22, J1.26, J1.30, J1.34, J1.38, J1.42, J1.46, J1.50, J1.64, J5.2, J5.10, U1.10 (GND), U1.22 (GND), U1.30 (GND), U1.42 (GND), X2.4 (GND); also elsewhere on the board
unnamed: D1.2 (A), R3.1
unnamed: D2.2 (A), R11.1
unnamed: D3.1 (K), U1.11 (I/O/PD1)
unnamed: D4.1 (K), U1.6 (I/O)
unnamed: R7.2, X2.1 (EN)
OPL3_nCS: D1.1 (K), U1.4 (I/O); also elsewhere on the board
OPL_nRST: U1.37 (I/O); also elsewhere on the board
RDY: J1.57
RnW: J1.51, U1.1 (I/GCLR)
SP_CLK: U1.27 (I/O); also elsewhere on the board
SP_OSC: U1.41 (I/O/GCLK3), X2.5 (OUT)
SP_nALD: D2.1 (K), U1.33 (I/O); also elsewhere on the board
SP_nBUSY: U1.29 (I/O); also elsewhere on the board
SP_nREADY: U1.31 (I/O); also elsewhere on the board
SP_nRST: U1.28 (I/O); also elsewhere on the board
SYNQ: J1.52
SYSCLK: J1.58, U1.2 (I/OE2/GCLK2)
TCK: J5.1, U1.32 (I/O/TCK)
TDI: J5.9, U1.7 (I/O/TDI)
TDO: J5.3, U1.38 (I/O/TDO)
TMS: J5.5, U1.13 (I/O/TMS)
nBUSRQ: J1.61
nIRQ: J1.54; also elsewhere on the board
nNMI: J1.56
nR: U1.39 (I/O); also elsewhere on the board
nRES: J1.63, U1.8 (I/O)
nSLOW0: D4.2 (A), J1.53
nSLOW1: D3.2 (A), J1.55
nVP: J1.59
nW: U1.40 (I/O); also elsewhere on the board

Notes on the sheet:
RAM
Speech chip reset BIT0 at address 0xA101 Speech chip data written to address 0xA100 OPL3 chip select at address 0xA110
SP_nRST seems to need a long pulse to reliably reset the chip
SPEECH
CPU_CLK is the stretched version of CLK. Use nSLOW0 and nSLOW1 to slow the clock down
6Mhz
nIRQ must be open collector/drain

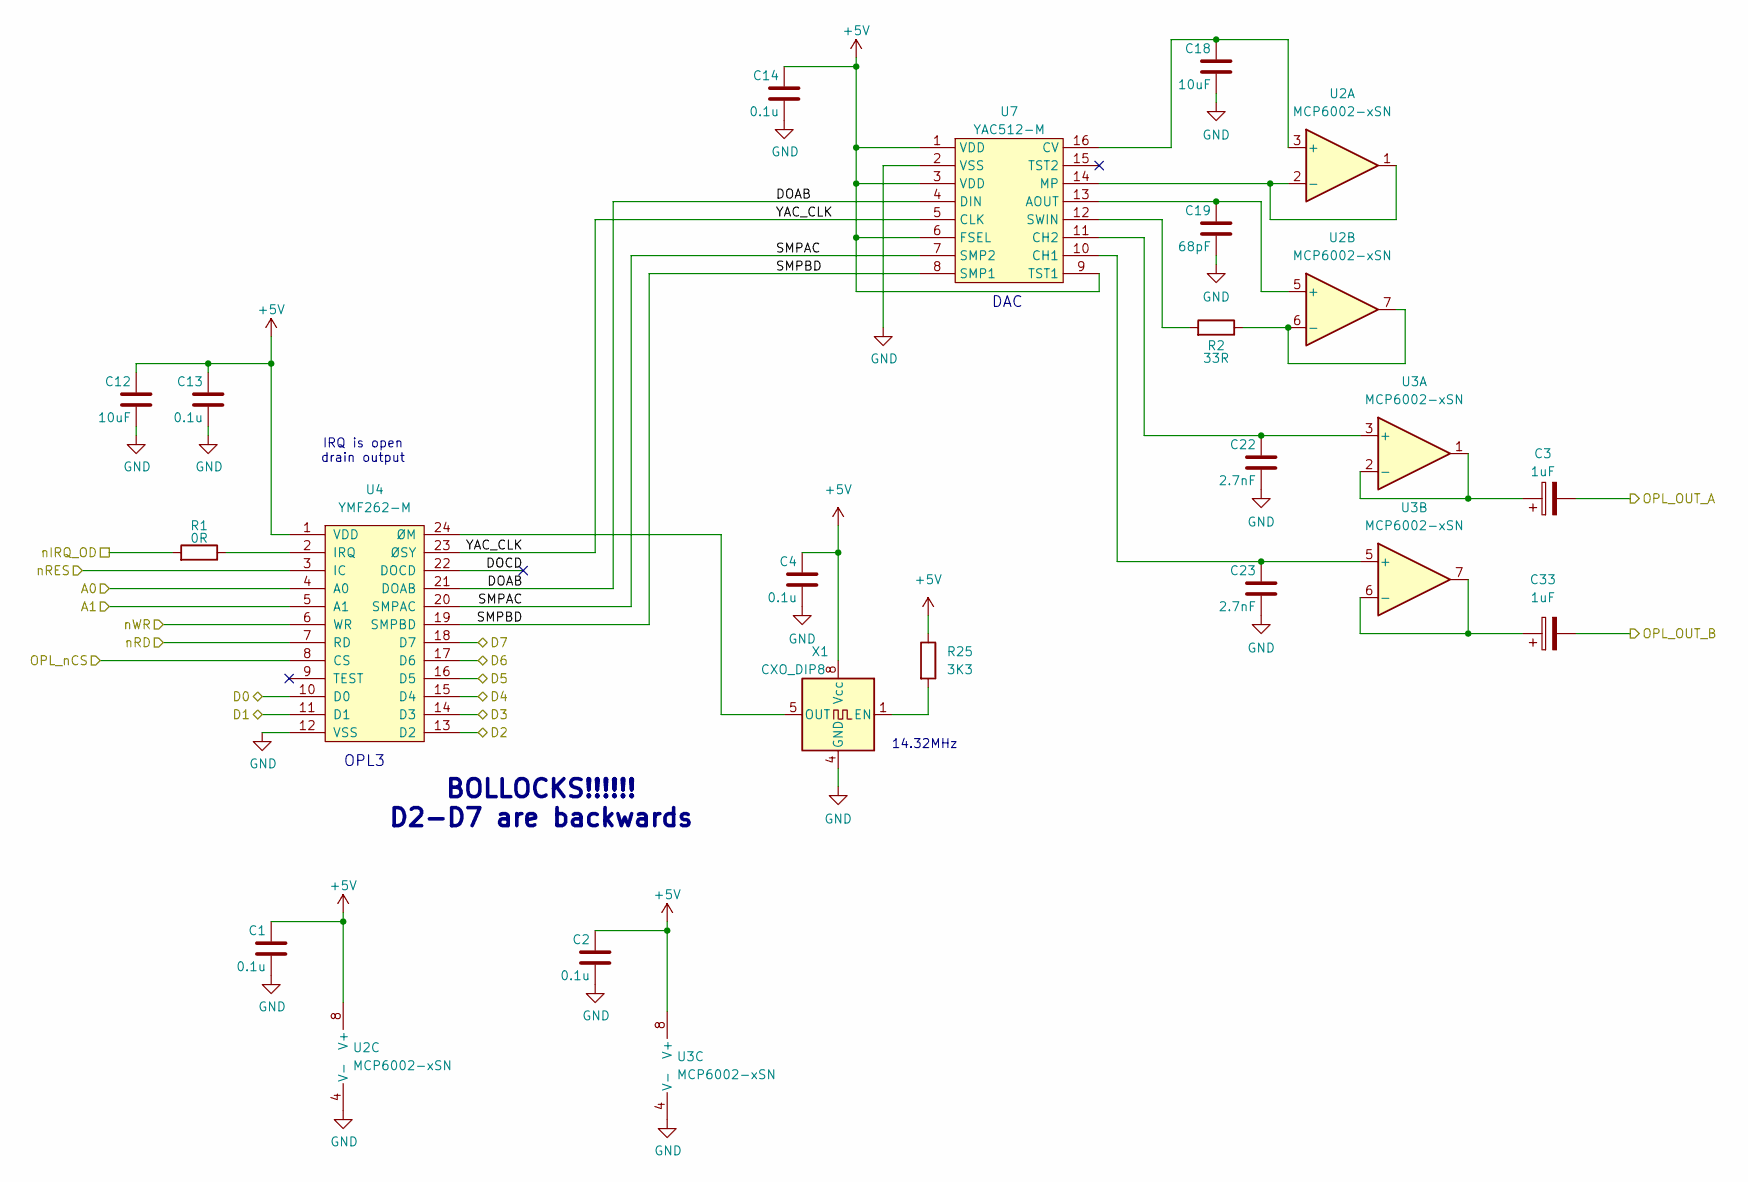
[picture p26: schematic OPL3_DAC.kicad_sch, Dual OPL3 Caladan VoiceCard]

Parts:
C1, C2, C4, C13, C14: 0.1u; C_0603_1608Metric; ManufacturerPN C0603C104K3RAC7867
C3, C33: 1uF; CP_EIA-3216-18_Kemet-A
C12: 10uF; C_1206_3216Metric; ManufacturerPN CL21X106KOQNNNE
C18: 10uF; C_0805_2012Metric
C19: 68pF; C_0603_1608Metric; ManufacturerPN CL21X106KOQNNNE
C22, C23: 2.7nF; C_0603_1608Metric; ManufacturerPN CL21X106KOQNNNE
R1: 0R; R_0603_1608Metric
R2: 33R; R_0603_1608Metric
R25: 3K3; R_0603_1608Metric_Pad0.98x0.95mm_HandSolder; LCSC C25890
U2, U3: MCP6002-xSN; SOIC-8_5.3x5.3mm_P1.27mm
U4: YMF262-M; SOIC-24W_7.5x15.4mm_P1.27mm
U7: YAC512-M; SOIC-16W_5.3x10.2mm_P1.27mm
X1: CXO_DIP8; Oscillator_DIP-8; LCSC DNF

Connections:
+5V: C1.1, C2.1, C4.1, C12.1, C13.1, C14.1, R25.1, U2.8 (V+), U3.8 (V+), U4.1 (VDD), U7.1 (VDD), U7.3 (VDD), U7.6 (FSEL), U7.9 (TST1), X1.8 (Vcc); also elsewhere on the board
/A0: U4.4 (A0); also elsewhere on the board
/A1: U4.5 (A1); also elsewhere on the board
/D0: U4.10 (D0); also elsewhere on the board
/D1: U4.11 (D1); also elsewhere on the board
/D2: U4.13 (D2); also elsewhere on the board
/D3: U4.14 (D3); also elsewhere on the board
/D4: U4.15 (D4); also elsewhere on the board
/D5: U4.16 (D5); also elsewhere on the board
/D6: U4.17 (D6); also elsewhere on the board
/D7: U4.18 (D7); also elsewhere on the board
/OPL/DOAB: U4.21 (DOAB), U7.4 (DIN)
/OPL/DOCD: U4.22 (DOCD)
/OPL/OPL_OUT_A: C3.2; also elsewhere on the board
/OPL/OPL_OUT_B: C33.2; also elsewhere on the board
/OPL/SMPAC: U4.20 (SMPAC), U7.7 (SMP2)
/OPL/SMPBD: U4.19 (SMPBD), U7.8 (SMP1)
/OPL/YAC_CLK: U4.23 (ØSY), U7.5 (CLK)
GND: C1.2, C2.2, C4.2, C12.2, C13.2, C14.2, C18.2, C19.2, C22.2, C23.2, U2.4 (V-), U3.4 (V-), U4.12 (VSS), U7.2 (VSS), X1.4 (GND); also elsewhere on the board
unnamed: C18.1, U2.3 (+), U7.16 (CV)
unnamed: U2.1, U2.2 (-), U7.14 (MP)
unnamed: C19.1, U2.5 (+), U7.13 (AOUT)
unnamed: R2.1, U2.6 (-), U2.7
unnamed: C22.1, U3.3 (+), U7.11 (CH2)
unnamed: C3.1, U3.1, U3.2 (-)
unnamed: C23.1, U3.5 (+), U7.10 (CH1)
unnamed: C33.1, U3.6 (-), U3.7
unnamed: R1.1, U4.2 (IRQ)
unnamed: U4.24 (ØM), X1.5 (OUT)
unnamed: R2.2, U7.12 (SWIN)
unnamed: R25.2, X1.1 (EN)
OPL3_nCS: U4.8 (CS); also elsewhere on the board
OPL_nRST: U4.3 (IC); also elsewhere on the board
nIRQ: R1.2; also elsewhere on the board
nR: U4.7 (RD); also elsewhere on the board
nW: U4.6 (WR); also elsewhere on the board

Notes on the sheet:
IRQ is open drain output
OPL3
DAC
BOLLOCKS!!!!!! D2-D7 are backwards
14.32MHz

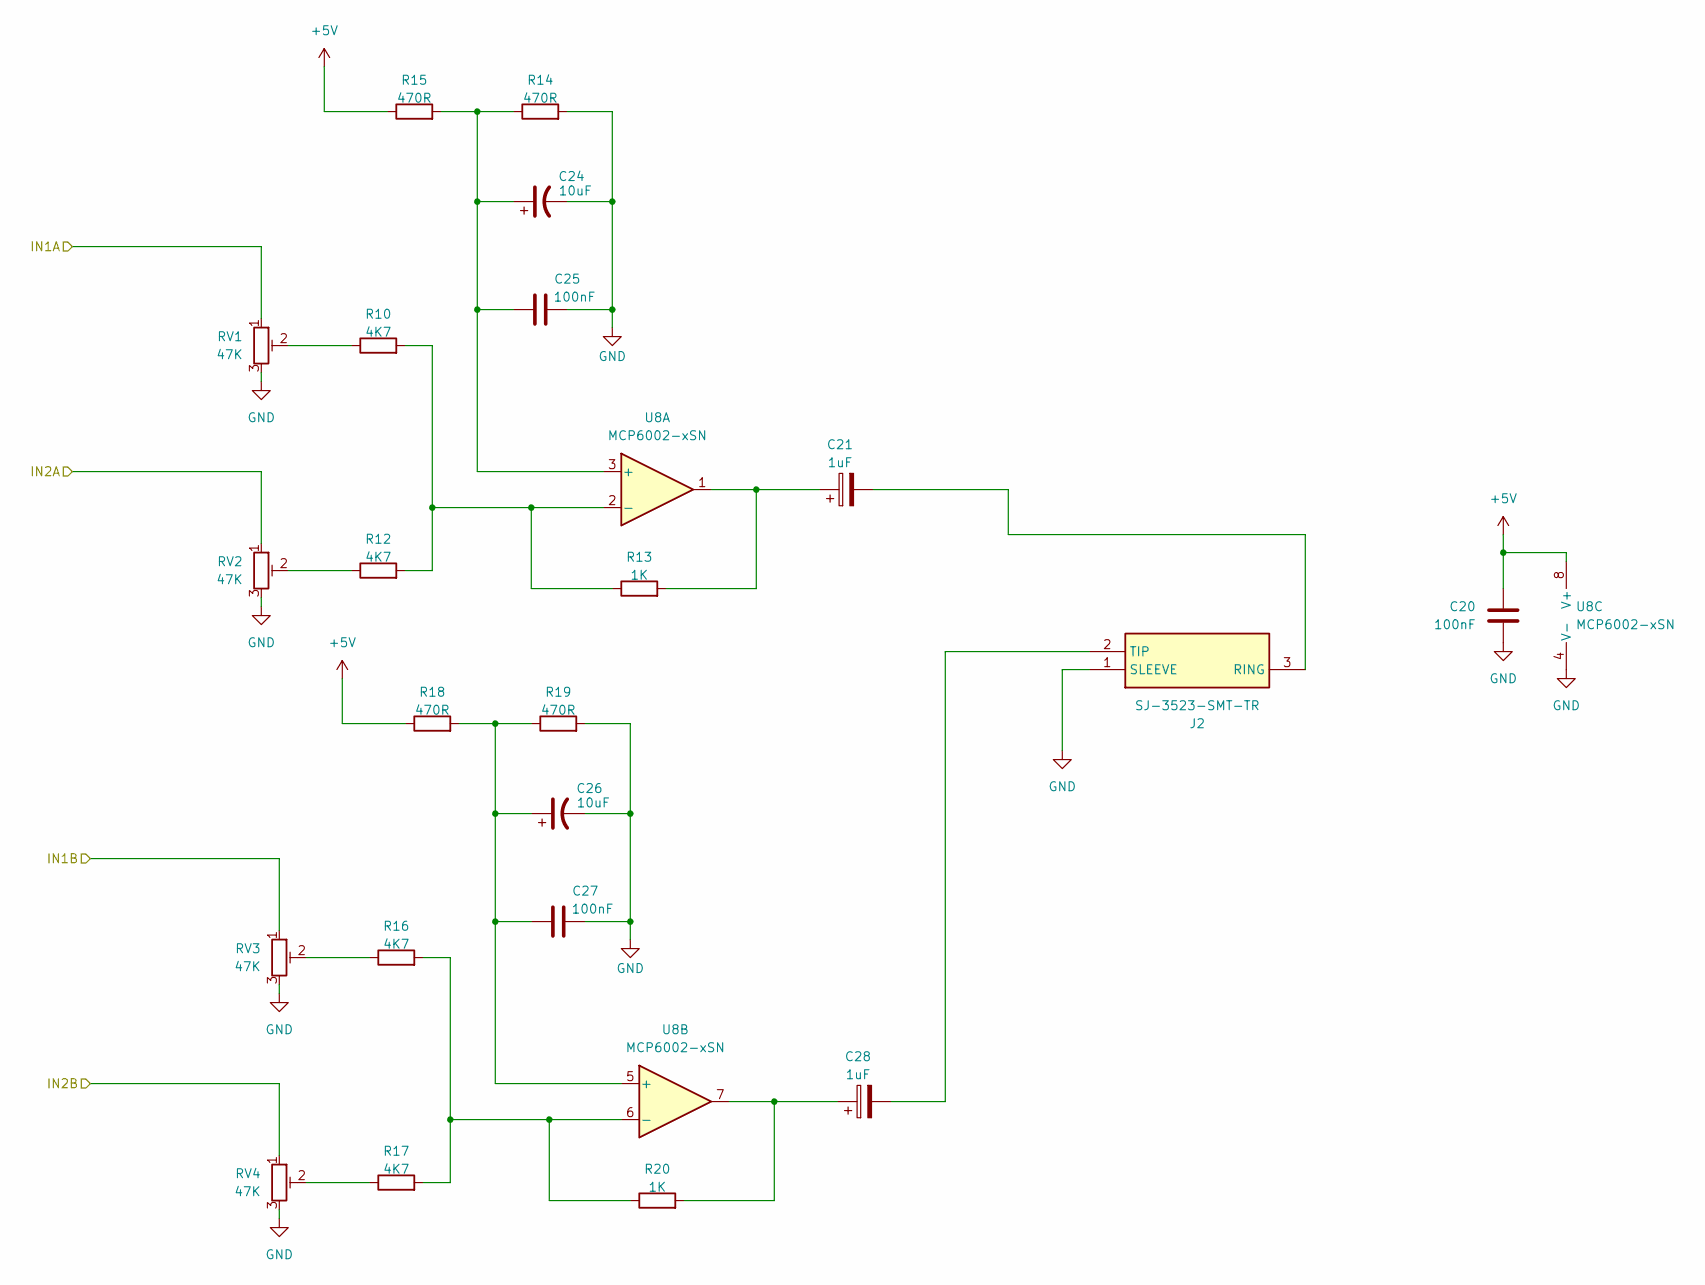
[picture p27: schematic Output.kicad_sch]

Parts:
C20, C25, C27: 100nF; C_0603_1608Metric
C21, C28: 1uF; CP_EIA-3216-18_Kemet-A
C24, C26: 10uF; C_0805_2012Metric; LCSC C96123
J2: SJ-3523-SMT-TR; SJ3523SMTTR; Mouser Part Number 490-SJ-3523-SMT-TR
R10, R12, R16, R17: 4K7; R_0603_1608Metric_Pad0.98x0.95mm_HandSolder; LCSC C23179
R13, R20: 1K; R_0603_1608Metric_Pad0.98x0.95mm_HandSolder; LCSC C23179
R14, R15, R18, R19: 470R; R_0603_1608Metric_Pad0.98x0.95mm_HandSolder; LCSC C23179
RV1, RV2, RV3, RV4: 47K; Potentiometer_Piher_PT-10-H01_Horizontal
U8: MCP6002-xSN; SOIC-8_5.3x5.3mm_P1.27mm

Connections:
+5V: C20.1, R15.1, R18.1, U8.8 (V+); also elsewhere on the board
/OPL/OPL_OUT_A: RV2.1; also elsewhere on the board
/OPL/OPL_OUT_B: RV4.1; also elsewhere on the board
/Output/IN1A: RV1.1; also elsewhere on the board
/Output/IN1B: RV3.1; also elsewhere on the board
GND: C20.2, C24.2, C25.1, C26.2, C27.1, J2.1 (SLEEVE), R14.2, R19.2, RV1.3, RV2.3, RV3.3, RV4.3, U8.4 (V-); also elsewhere on the board
unnamed: C21.1, R13.2, U8.1
unnamed: C28.1, R20.2, U8.7
unnamed: C21.2, J2.3 (RING)
unnamed: C28.2, J2.2 (TIP)
unnamed: R10.1, RV1.2
unnamed: R12.1, RV2.2
unnamed: R16.1, RV3.2
unnamed: R17.1, RV4.2
unnamed: C24.1, C25.2, R14.1, R15.2, U8.3 (+)
unnamed: R10.2, R12.2, R13.1, U8.2 (-)
unnamed: C26.1, C27.2, R18.2, R19.1, U8.5 (+)
unnamed: R16.2, R17.2, R20.1, U8.6 (-)

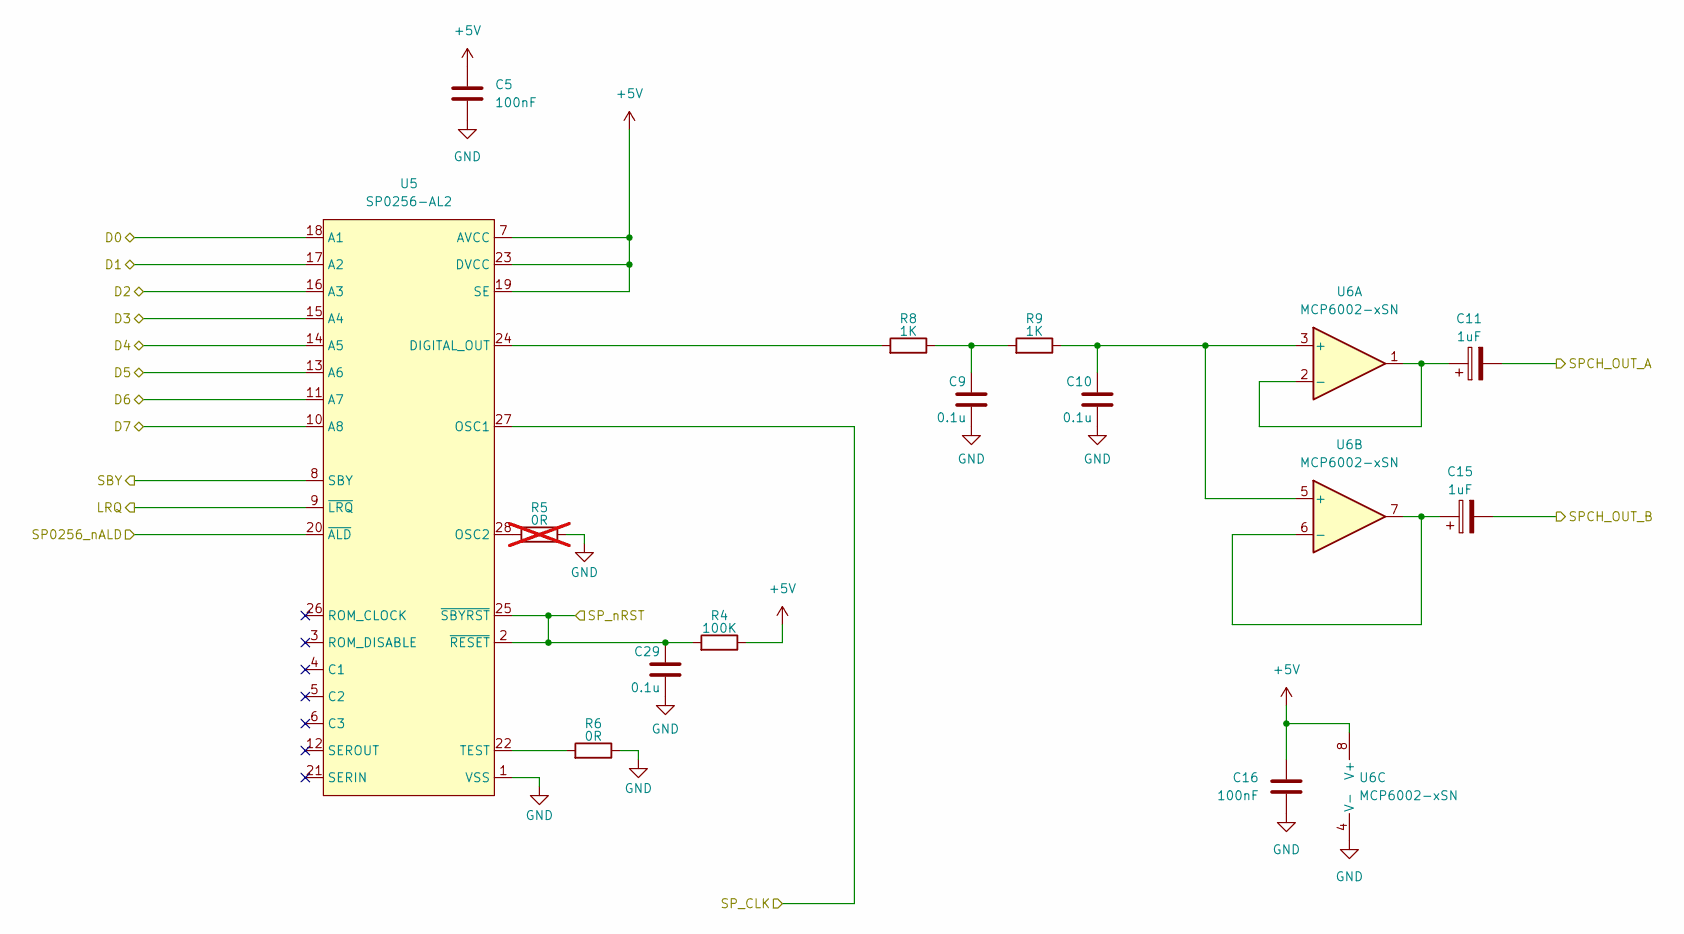
[picture p28: schematic SP0256-AL2.kicad_sch]

Parts:
C5, C16: 100nF; C_0603_1608Metric
C9, C10, C29: 0.1u; C_0603_1608Metric; ManufacturerPN C0603C104K3RAC7867
C11, C15: 1uF; CP_EIA-3216-18_Kemet-A
R4: 100K; R_0603_1608Metric
R5: 0R; R_0603_1608Metric; not fitted
R6: 0R; R_0603_1608Metric
R8, R9: 1K; R_0603_1608Metric
U5: SP0256-AL2; DIP-28_W15.24mm_Socket
U6: MCP6002-xSN; SOIC-8_5.3x5.3mm_P1.27mm

Connections:
+5V: C5.1, C16.1, R4.1, U5.7 (AVCC), U5.19 (SE), U5.23 (DVCC), U6.8 (V+); also elsewhere on the board
/D0: U5.18 (A1); also elsewhere on the board
/D1: U5.17 (A2); also elsewhere on the board
/D2: U5.16 (A3); also elsewhere on the board
/D3: U5.15 (A4); also elsewhere on the board
/D4: U5.14 (A5); also elsewhere on the board
/D5: U5.13 (A6); also elsewhere on the board
/D6: U5.11 (A7); also elsewhere on the board
/D7: U5.10 (A8); also elsewhere on the board
/Output/IN1A: C11.2; also elsewhere on the board
/Output/IN1B: C15.2; also elsewhere on the board
GND: C5.2, C9.2, C10.2, C16.2, C29.2, R5.1, R6.1, U5.1 (VSS), U6.4 (V-); also elsewhere on the board
unnamed: C9.1, R8.1, R9.2
unnamed: R8.2, U5.24 (DIGITAL_OUT)
unnamed: R5.2, U5.28 (OSC2)
unnamed: R6.2, U5.22 (TEST)
unnamed: C10.1, R9.1, U6.3 (+), U6.5 (+)
unnamed: C11.1, U6.1, U6.2 (-)
unnamed: C15.1, U6.6 (-), U6.7
SP_CLK: U5.27 (OSC1); also elsewhere on the board
SP_nALD: U5.20 (~ALD); also elsewhere on the board
SP_nBUSY: U5.8 (SBY); also elsewhere on the board
SP_nREADY: U5.9 (~LRQ); also elsewhere on the board
SP_nRST: C29.1, R4.2, U5.2 (~RESET), U5.25 (~SBYRST); also elsewhere on the board

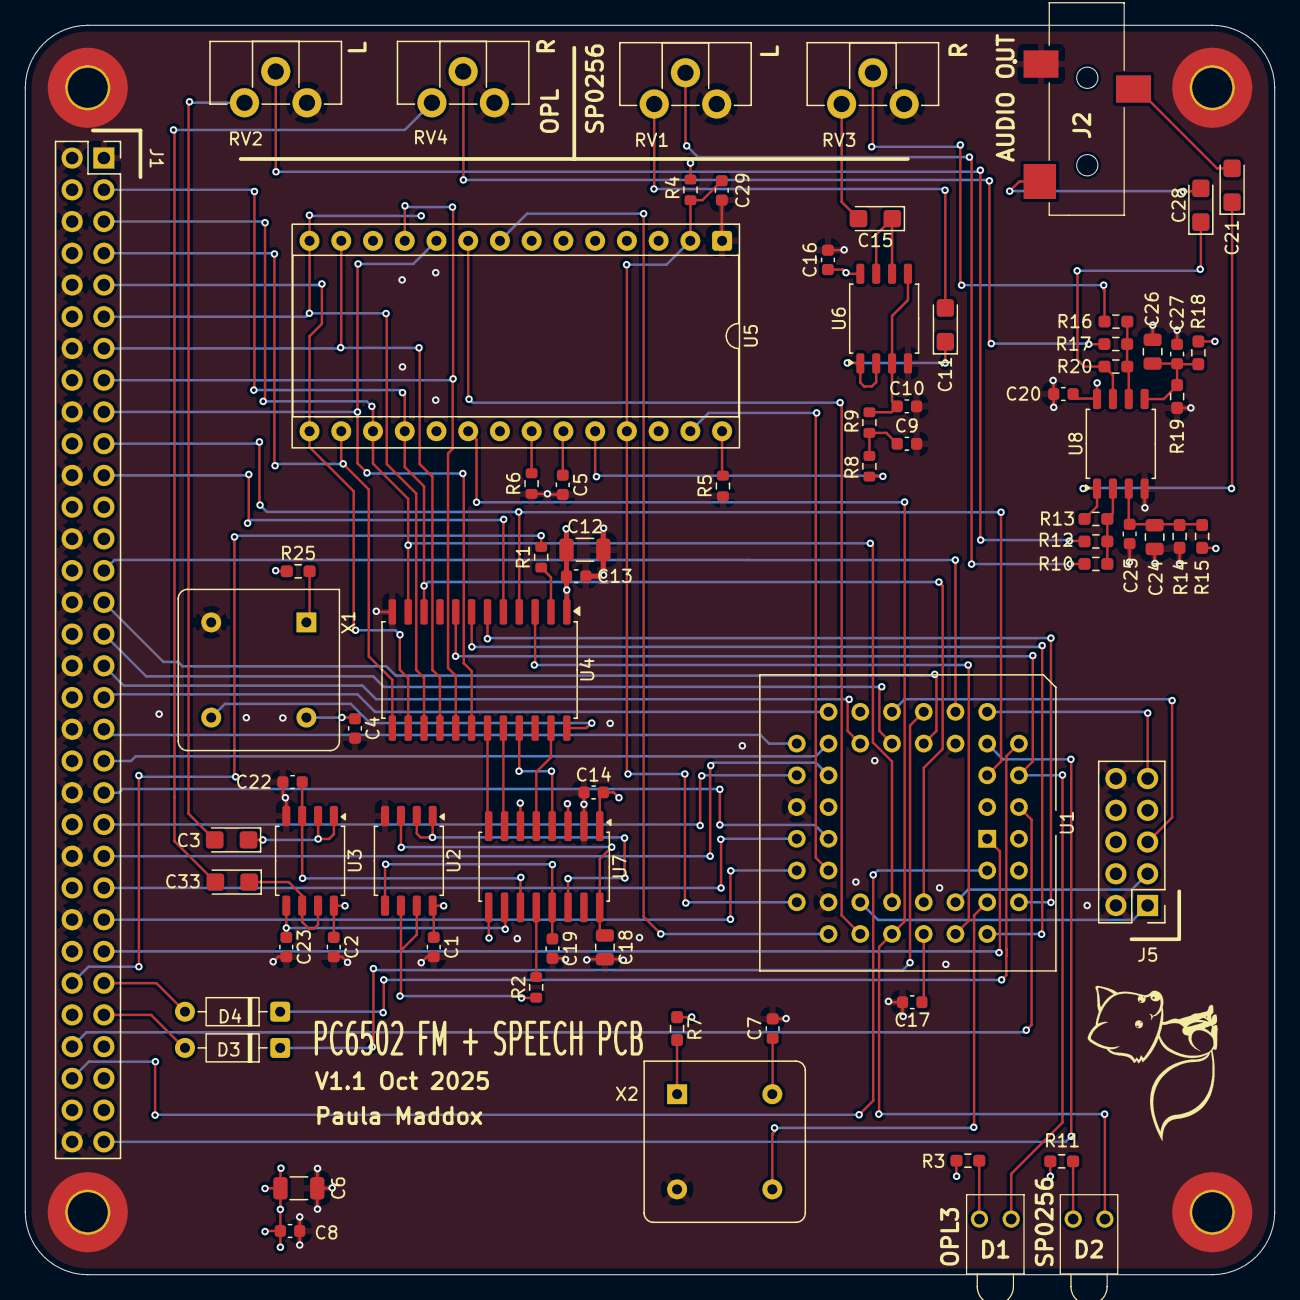
[picture p29: board PC6502-FM-SPEECH.kicad_pcb from above]

Board: 4 copper layers, 100.0 x 100.0 mm, 77 parts (0 on the bottom side), 89 nets.
