TechPaula/PC6502/Schematics/PC6502-AIISLOT/PC6502-AIISLOT.kicad_pcb

## KiCad design Schematics/PC6502-AIISLOT/PC6502-AIISLOT.kicad_pcb (2025-10-12, last stored version)

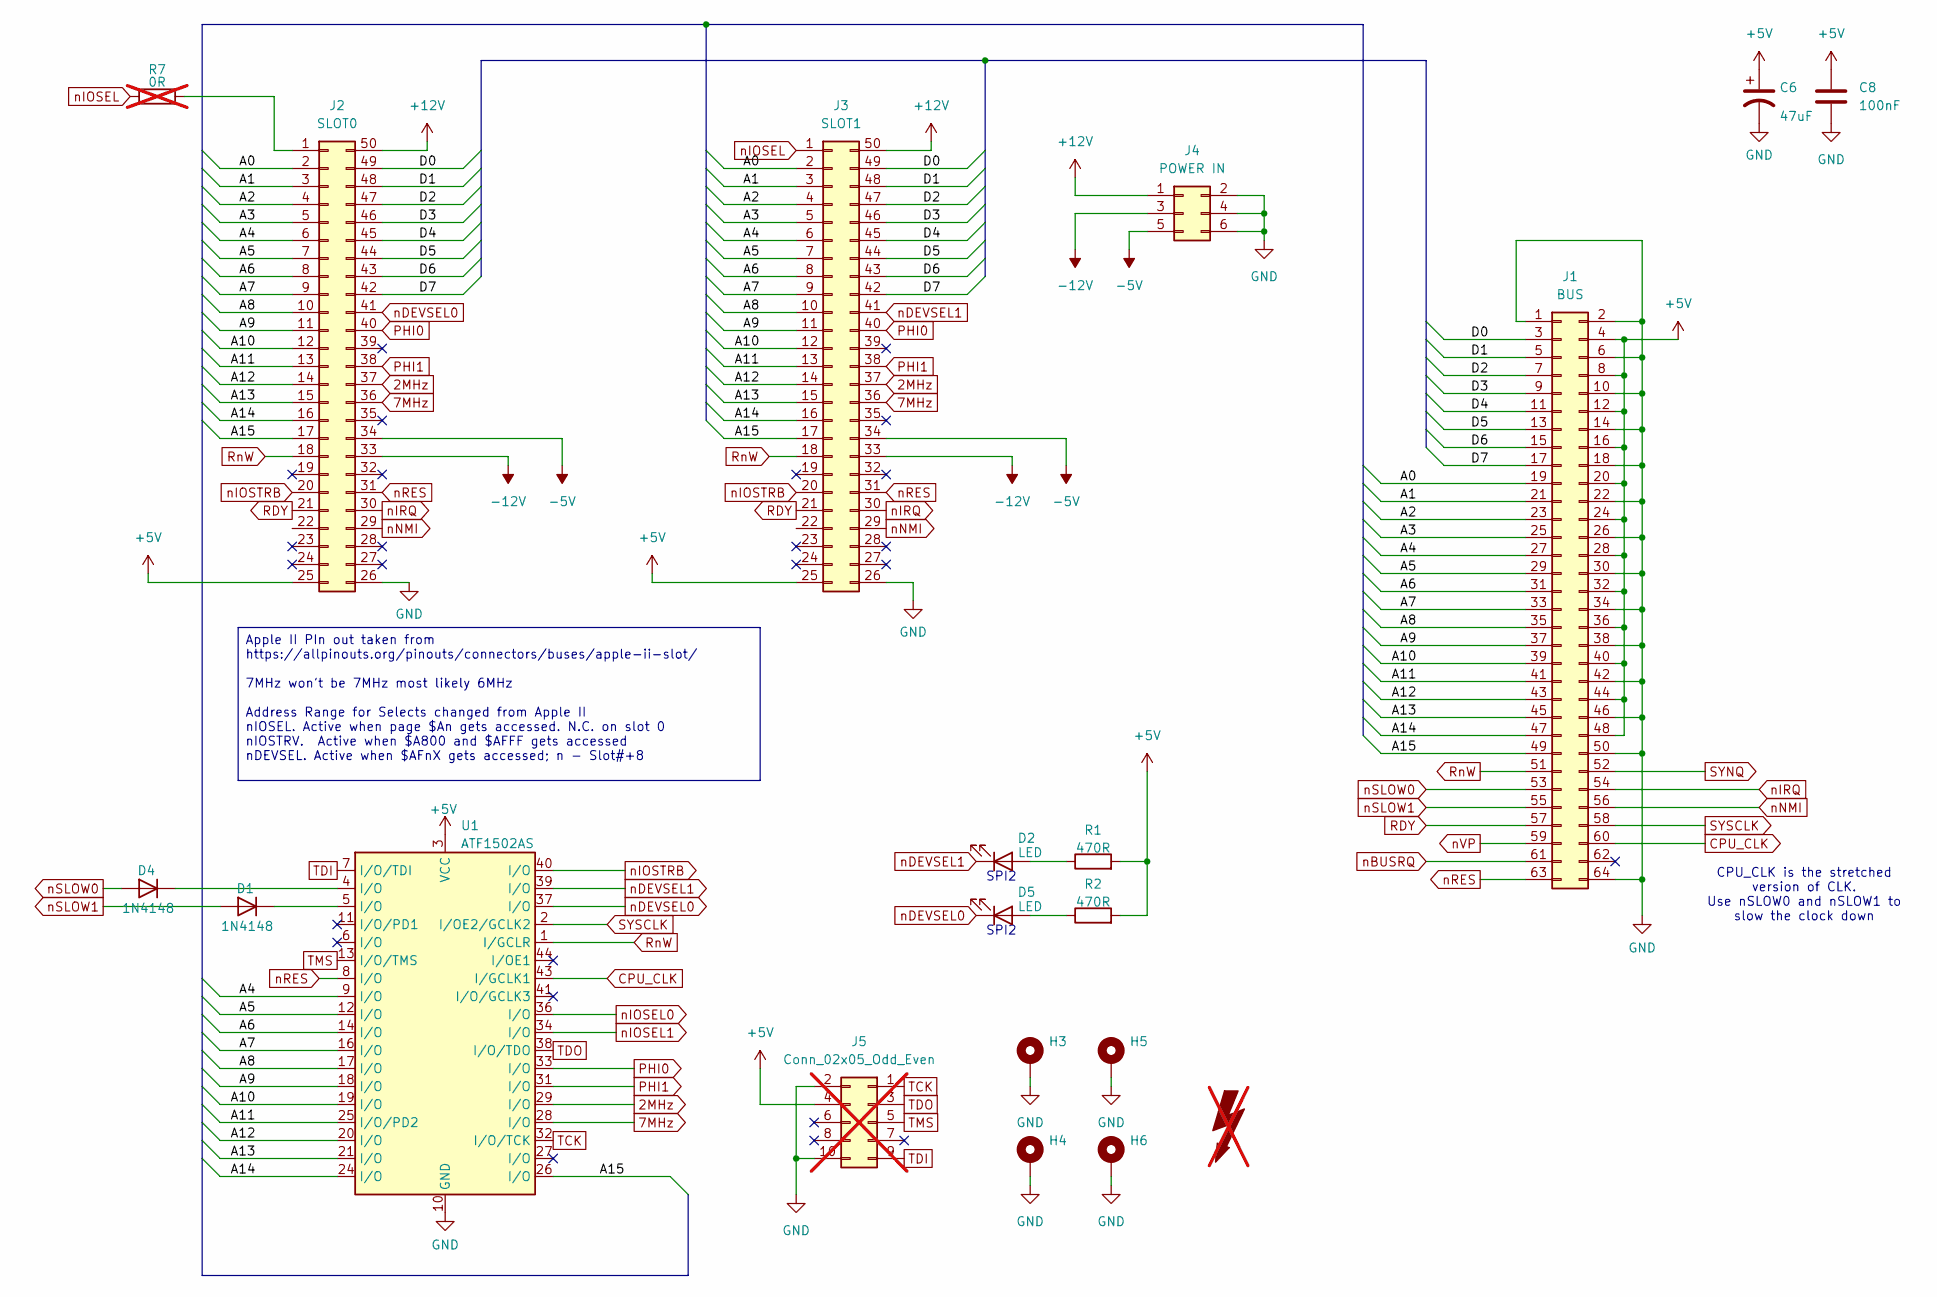
[picture p30: schematic PC6502-AIISLOT.kicad_sch]

Parts:
C6: 47uF; C_1206_3216Metric; LCSC C96123
C8: 100nF; C_0805_2012Metric
D1, D4: 1N4148; D_DO-35_SOD27_P7.62mm_Horizontal; LCSC DNF
D2, D5: LED; LTL4221NHBP
FOX1: SYM_Flash_Large; Fox_avatar_18mm; LCSC DNF; not fitted
H3, H4, H5, H6: MountingHole_Pad; MountingHole_3.2mm_M3_Pad_TopBottom; LCSC DNF
J1: BUS; PinSocket_2x32_P2.54mm_Vertical; LCSC DNF
J2: SLOT0; 55308435_APPLEII
J3: SLOT1; 55308435_APPLEII
J4: POWER IN; PinHeader_2x03_P2.54mm_Horizontal
J5: Conn_02x05_Odd_Even; PinHeader_2x05_P2.54mm_Vertical; LCSC DNF; not fitted
R1, R2: 470R; R_0603_1608Metric_Pad0.98x0.95mm_HandSolder
R7: 0R; R_0603_1608Metric_Pad0.98x0.95mm_HandSolder; not fitted
U1: ATF1502AS; PLCC-44_THT-Socket; LCSC DNF

Connections:
2MHz: J2.37, J3.37, U1.29 (I/O)
7MHz: J2.36, J3.36, U1.28 (I/O)
+5V: C6.1, C8.1, J1.4, J1.8, J1.12, J1.16, J1.20, J1.24, J1.28, J1.32, J1.36, J1.40, J1.44, J1.48, J2.25, J3.25, J5.4, R1.2, R2.2, U1.3 (VCC), U1.15 (VCC), U1.23 (VCC), U1.35 (VCC)
+12V: J2.50, J3.50, J4.1
-5V: J2.34, J3.34, J4.5
-12V: J2.33, J3.33, J4.3
/A0: J1.19, J2.2, J3.2
/A1: J1.21, J2.3, J3.3
/A2: J1.23, J2.4, J3.4
/A3: J1.25, J2.5, J3.5
/A4: J1.27, J2.6, J3.6, U1.9 (I/O)
/A5: J1.29, J2.7, J3.7, U1.12 (I/O)
/A6: J1.31, J2.8, J3.8, U1.14 (I/O)
/A7: J1.33, J2.9, J3.9, U1.16 (I/O)
/A8: J1.35, J2.10, J3.10, U1.17 (I/O)
/A9: J1.37, J2.11, J3.11, U1.18 (I/O)
/A10: J1.39, J2.12, J3.12, U1.19 (I/O)
/A11: J1.41, J2.13, J3.13, U1.25 (I/O/PD2)
/A12: J1.43, J2.14, J3.14, U1.20 (I/O)
/A13: J1.45, J2.15, J3.15, U1.21 (I/O)
/A14: J1.47, J2.16, J3.16, U1.24 (I/O)
/A15: J1.49, J2.17, J3.17, U1.26 (I/O)
/D0: J1.3, J2.49, J3.49
/D1: J1.5, J2.48, J3.48
/D2: J1.7, J2.47, J3.47
/D3: J1.9, J2.46, J3.46
/D4: J1.11, J2.45, J3.45
/D5: J1.13, J2.44, J3.44
/D6: J1.15, J2.43, J3.43
/D7: J1.17, J2.42, J3.42
CPU_CLK: J1.60, U1.43 (I/GCLK1)
GND: C6.2, C8.2, H3.1, H4.1, H5.1, H6.1, J1.1, J1.2, J1.6, J1.10, J1.14, J1.18, J1.22, J1.26, J1.30, J1.34, J1.38, J1.42, J1.46, J1.50, J1.64, J2.26, J3.26, J4.2, J4.4, J4.6, J5.2, J5.10, U1.10 (GND), U1.22 (GND), U1.30 (GND), U1.42 (GND)
unnamed: D1.1 (K), U1.5 (I/O)
unnamed: D2.2 (A), R1.1
unnamed: D4.1 (K), U1.4 (I/O)
unnamed: D5.2 (A), R2.1
unnamed: J2.1, R7.2
PHI0: J2.40, J3.40, U1.33 (I/O)
PHI1: J2.38, J3.38, U1.31 (I/O)
RDY: J1.57, J2.21, J3.21
RnW: J1.51, J2.18, J3.18, U1.1 (I/GCLR)
SYNQ: J1.52
SYSCLK: J1.58, U1.2 (I/OE2/GCLK2)
TCK: J5.1, U1.32 (I/O/TCK)
TDI: J5.9, U1.7 (I/O/TDI)
TDO: J5.3, U1.38 (I/O/TDO)
TMS: J5.5, U1.13 (I/O/TMS)
nBUSRQ: J1.61
nDEVSEL0: D5.1 (K), J2.41, U1.37 (I/O)
nDEVSEL1: D2.1 (K), J3.41, U1.39 (I/O)
nIOSEL: J3.1, R7.1
nIOSEL0: U1.36 (I/O)
nIOSEL1: U1.34 (I/O)
nIOSTRB: J2.20, J3.20, U1.40 (I/O)
nIRQ: J1.54, J2.30, J3.30
nNMI: J1.56, J2.29, J3.29
nRES: J1.63, J2.31, J3.31, U1.8 (I/O)
nSLOW0: D4.2 (A), J1.53
nSLOW1: D1.2 (A), J1.55
nVP: J1.59

Notes on the sheet:
CPU_CLK is the stretched version of CLK. Use nSLOW0 and nSLOW1 to slow the clock down
SPI2
Apple II PIn out taken from https://allpinouts.org/pinouts/connectors/buses/apple-ii-slot/ 7MHz won't be 7MHz most likely 6MHz Address Range for Selects changed from Apple II nIOSEL. Active when page $An gets accessed. N.C. on slot 0 nIOSTRV. Active when $A800 and $AFFF gets accessed nDEVSEL. Activ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

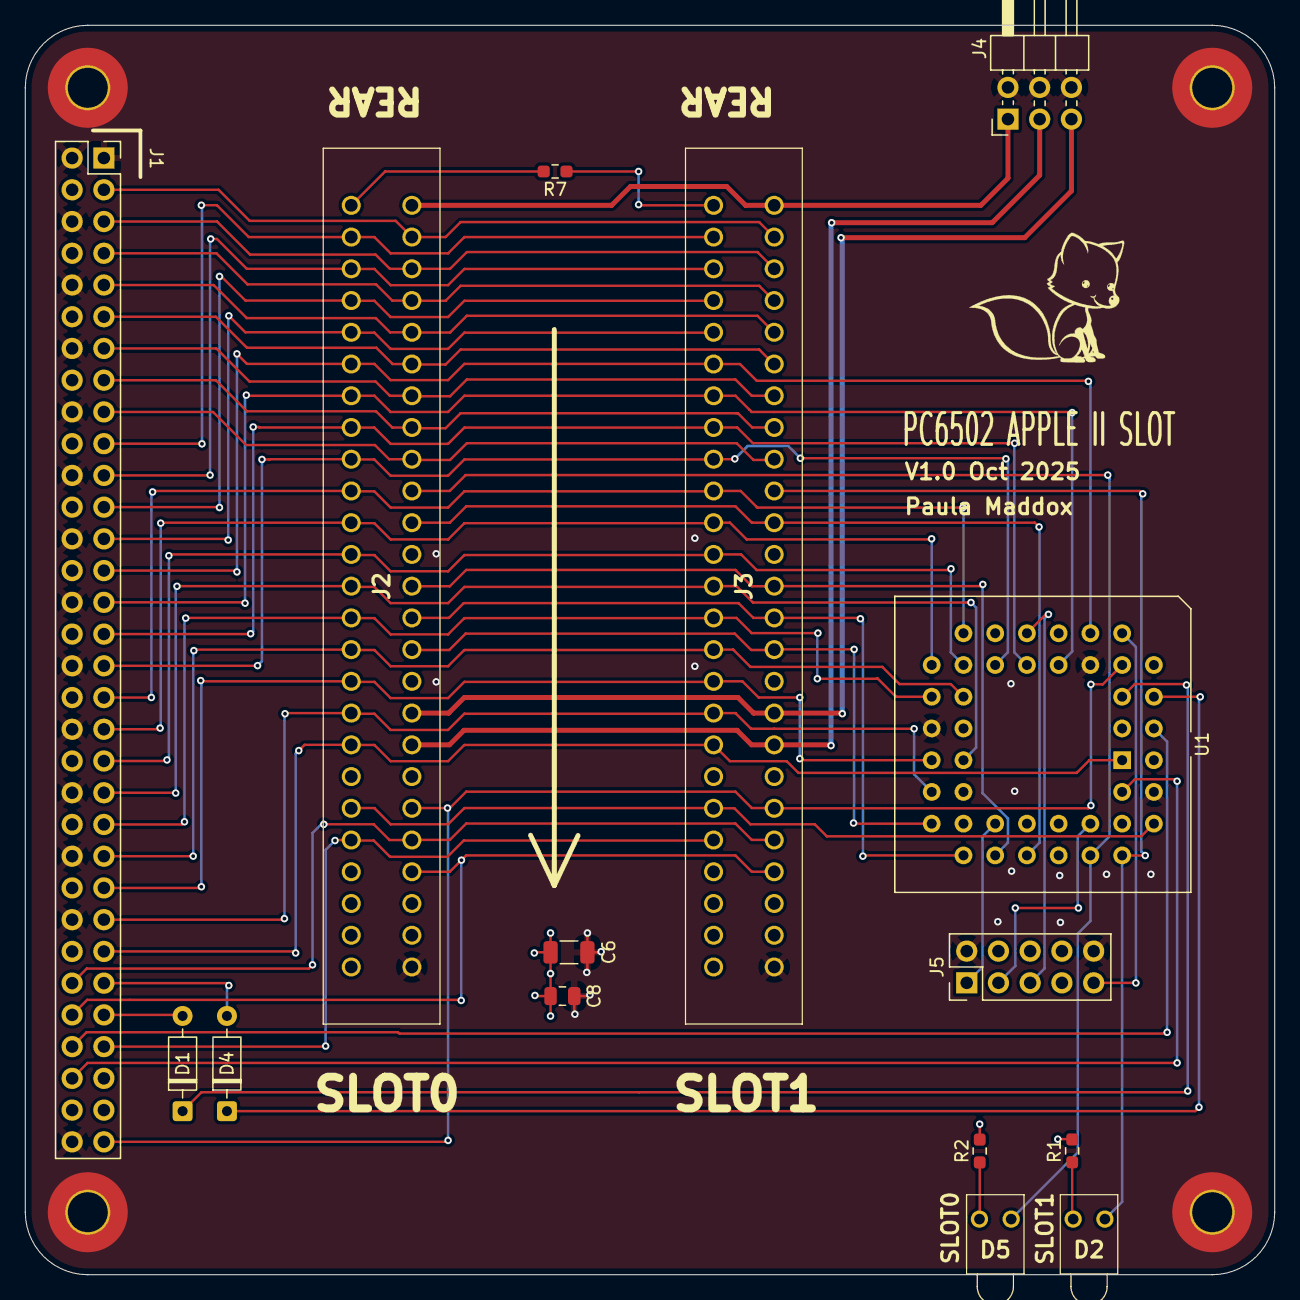
[picture p31: board PC6502-AIISLOT.kicad_pcb from above]

Board: 4 copper layers, 100.0 x 100.0 mm, 20 parts (0 on the bottom side), 55 nets.
