TechPaula/PC6502/Schematics/PC6502-VIA/PC6502-VIA.kicad_pcb

## KiCad design Schematics/PC6502-VIA/PC6502-VIA.kicad_pcb (2025-10-12, last stored version)

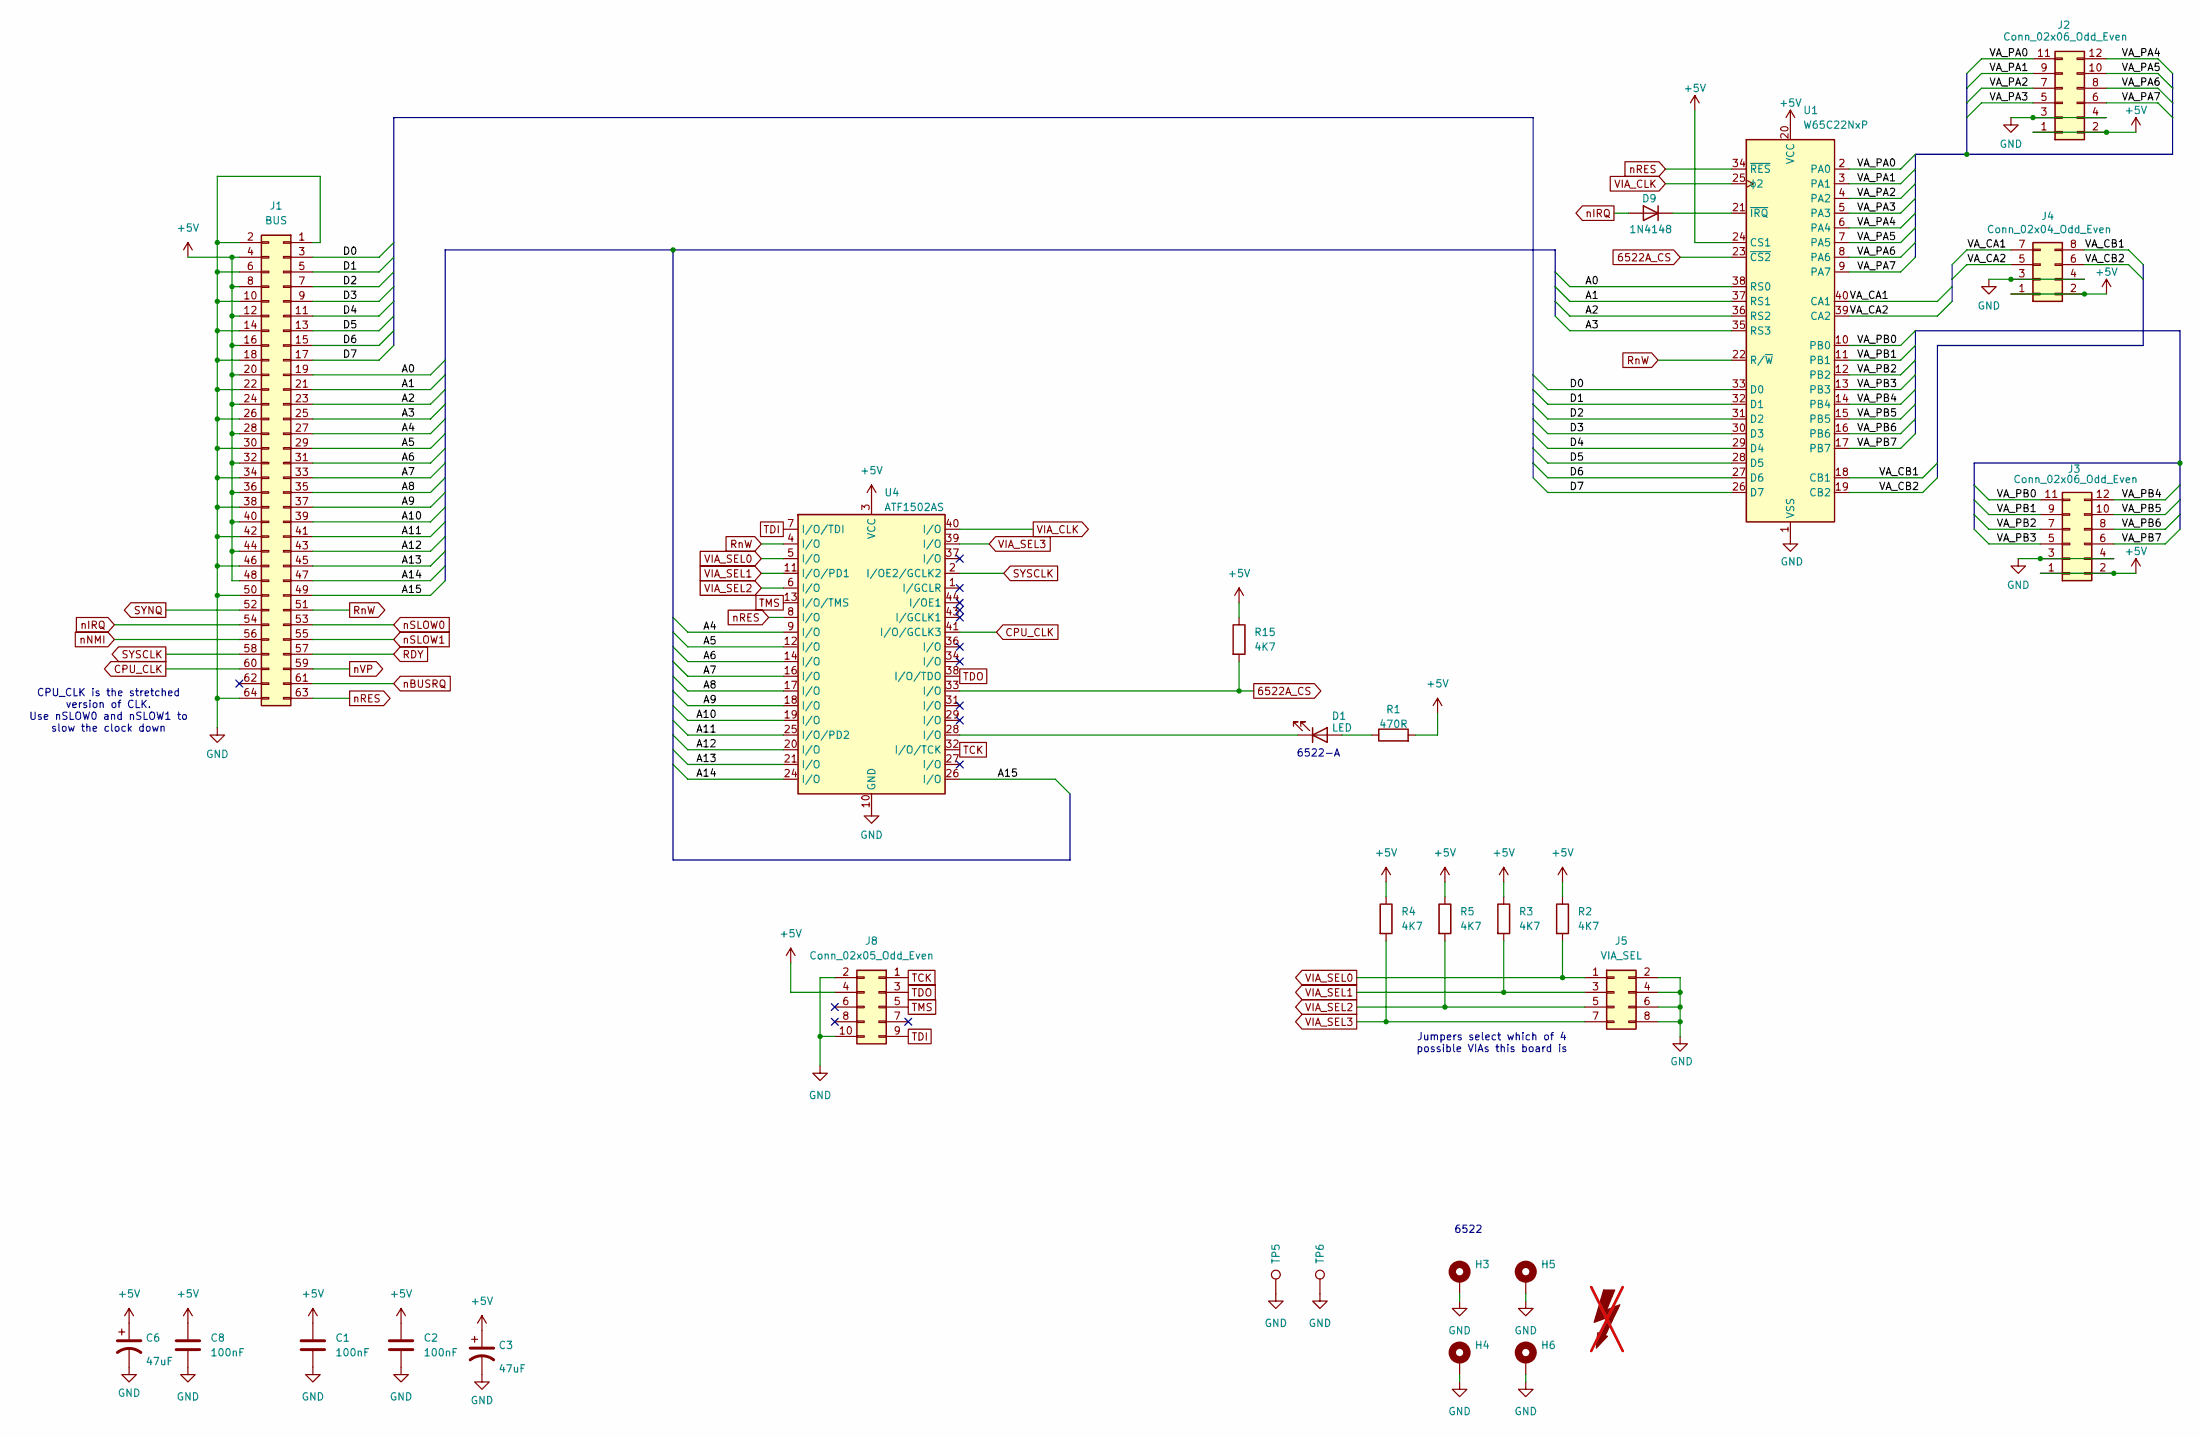
[picture p32: schematic PC6502-VIA.kicad_sch]

Parts:
C1, C2, C8: 100nF; C_0805_2012Metric
C3, C6: 47uF; C_1206_3216Metric; LCSC C96123
D1: LED; LTL4221NHBP
D9: 1N4148; D_DO-35_SOD27_P7.62mm_Horizontal
FOX1: SYM_Flash_Large; Fox_avatar_18mm; LCSC DNF; not fitted
H3, H4, H5, H6: MountingHole_Pad; MountingHole_3.2mm_M3_Pad_TopBottom; LCSC DNF
J1: BUS; PinSocket_2x32_P2.54mm_Vertical; LCSC DNF
J2, J3: Conn_02x06_Odd_Even; PinSocket_2x06_P2.54mm_Horizontal
J4: Conn_02x04_Odd_Even; PinSocket_2x04_P2.54mm_Horizontal
J5: VIA_SEL; PinHeader_2x04_P2.54mm_Horizontal
J8: Conn_02x05_Odd_Even; PinHeader_2x05_P2.54mm_Vertical
R1: 470R; R_0603_1608Metric_Pad0.98x0.95mm_HandSolder
R2, R3, R4, R5, R15: 4K7; R_0603_1608Metric_Pad0.98x0.95mm_HandSolder
TP5, TP6: TestPoint; TestPoint_Loop_D1.80mm_Drill1.0mm_Beaded
U1: W65C22NxP; DIP-40_W15.24mm
U4: ATF1502AS; PLCC-44_THT-Socket

Connections:
6522A_CS: R15.2, U1.23 (~CS2), U4.33 (I/O)
+5V: C1.1, C2.1, C3.1, C6.1, C8.1, J1.4, J1.8, J1.12, J1.16, J1.20, J1.24, J1.28, J1.32, J1.36, J1.40, J1.44, J1.48, J2.1, J2.2, J3.1, J3.2, J4.1, J4.2, J8.4, R1.2, R2.1, R3.1, R4.1, R5.1, R15.1, U1.20 (VCC), U1.24 (CS1), U4.3 (VCC), U4.15 (VCC), U4.23 (VCC), U4.35 (VCC)
/A0: J1.19, U1.38 (RS0)
/A1: J1.21, U1.37 (RS1)
/A2: J1.23, U1.36 (RS2)
/A3: J1.25, U1.35 (RS3)
/A4: J1.27, U4.9 (I/O)
/A5: J1.29, U4.12 (I/O)
/A6: J1.31, U4.14 (I/O)
/A7: J1.33, U4.16 (I/O)
/A8: J1.35, U4.17 (I/O)
/A9: J1.37, U4.18 (I/O)
/A10: J1.39, U4.19 (I/O)
/A11: J1.41, U4.25 (I/O/PD2)
/A12: J1.43, U4.20 (I/O)
/A13: J1.45, U4.21 (I/O)
/A14: J1.47, U4.24 (I/O)
/A15: J1.49, U4.26 (I/O)
/D0: J1.3, U1.33 (D0)
/D1: J1.5, U1.32 (D1)
/D2: J1.7, U1.31 (D2)
/D3: J1.9, U1.30 (D3)
/D4: J1.11, U1.29 (D4)
/D5: J1.13, U1.28 (D5)
/D6: J1.15, U1.27 (D6)
/D7: J1.17, U1.26 (D7)
/VA_CA1: J4.7, U1.40 (CA1)
/VA_CA2: J4.5, U1.39 (CA2)
/VA_CB1: J4.8, U1.18 (CB1)
/VA_CB2: J4.6, U1.19 (CB2)
/VA_PA0: J2.11, U1.2 (PA0)
/VA_PA1: J2.9, U1.3 (PA1)
/VA_PA2: J2.7, U1.4 (PA2)
/VA_PA3: J2.5, U1.5 (PA3)
/VA_PA4: J2.12, U1.6 (PA4)
/VA_PA5: J2.10, U1.7 (PA5)
/VA_PA6: J2.8, U1.8 (PA6)
/VA_PA7: J2.6, U1.9 (PA7)
/VA_PB0: J3.11, U1.10 (PB0)
/VA_PB1: J3.9, U1.11 (PB1)
/VA_PB2: J3.7, U1.12 (PB2)
/VA_PB3: J3.5, U1.13 (PB3)
/VA_PB4: J3.12, U1.14 (PB4)
/VA_PB5: J3.10, U1.15 (PB5)
/VA_PB6: J3.8, U1.16 (PB6)
/VA_PB7: J3.6, U1.17 (PB7)
CPU_CLK: J1.60, U4.41 (I/O/GCLK3)
GND: C1.2, C2.2, C3.2, C6.2, C8.2, H3.1, H4.1, H5.1, H6.1, J1.1, J1.2, J1.6, J1.10, J1.14, J1.18, J1.22, J1.26, J1.30, J1.34, J1.38, J1.42, J1.46, J1.50, J1.64, J2.3, J2.4, J3.3, J3.4, J4.3, J4.4, J5.2, J5.4, J5.6, J5.8, J8.2, J8.10, TP5.1, TP6.1, U1.1 (VSS), U4.10 (GND), U4.22 (GND), U4.30 (GND), U4.42 (GND)
unnamed: D1.2 (A), R1.1
unnamed: D1.1 (K), U4.28 (I/O)
unnamed: D9.1 (K), U1.21 (~IRQ)
RDY: J1.57
RnW: J1.51, U1.22 (R/~W), U4.4 (I/O)
SYNQ: J1.52
SYSCLK: J1.58, U4.2 (I/OE2/GCLK2)
TCK: J8.1, U4.32 (I/O/TCK)
TDI: J8.9, U4.7 (I/O/TDI)
TDO: J8.3, U4.38 (I/O/TDO)
TMS: J8.5, U4.13 (I/O/TMS)
VIA_CLK: U1.25 (ϕ2), U4.40 (I/O)
VIA_SEL0: J5.1, R2.2, U4.5 (I/O)
VIA_SEL1: J5.3, R3.2, U4.11 (I/O/PD1)
VIA_SEL2: J5.5, R5.2, U4.6 (I/O)
VIA_SEL3: J5.7, R4.2, U4.39 (I/O)
nBUSRQ: J1.61
nIRQ: D9.2 (A), J1.54
nNMI: J1.56
nRES: J1.63, U1.34 (~RES), U4.8 (I/O)
nSLOW0: J1.53
nSLOW1: J1.55
nVP: J1.59

Notes on the sheet:
6522-A
6522
CPU_CLK is the stretched version of CLK. Use nSLOW0 and nSLOW1 to slow the clock down
Jumpers select which of 4 possible VIAs this board is

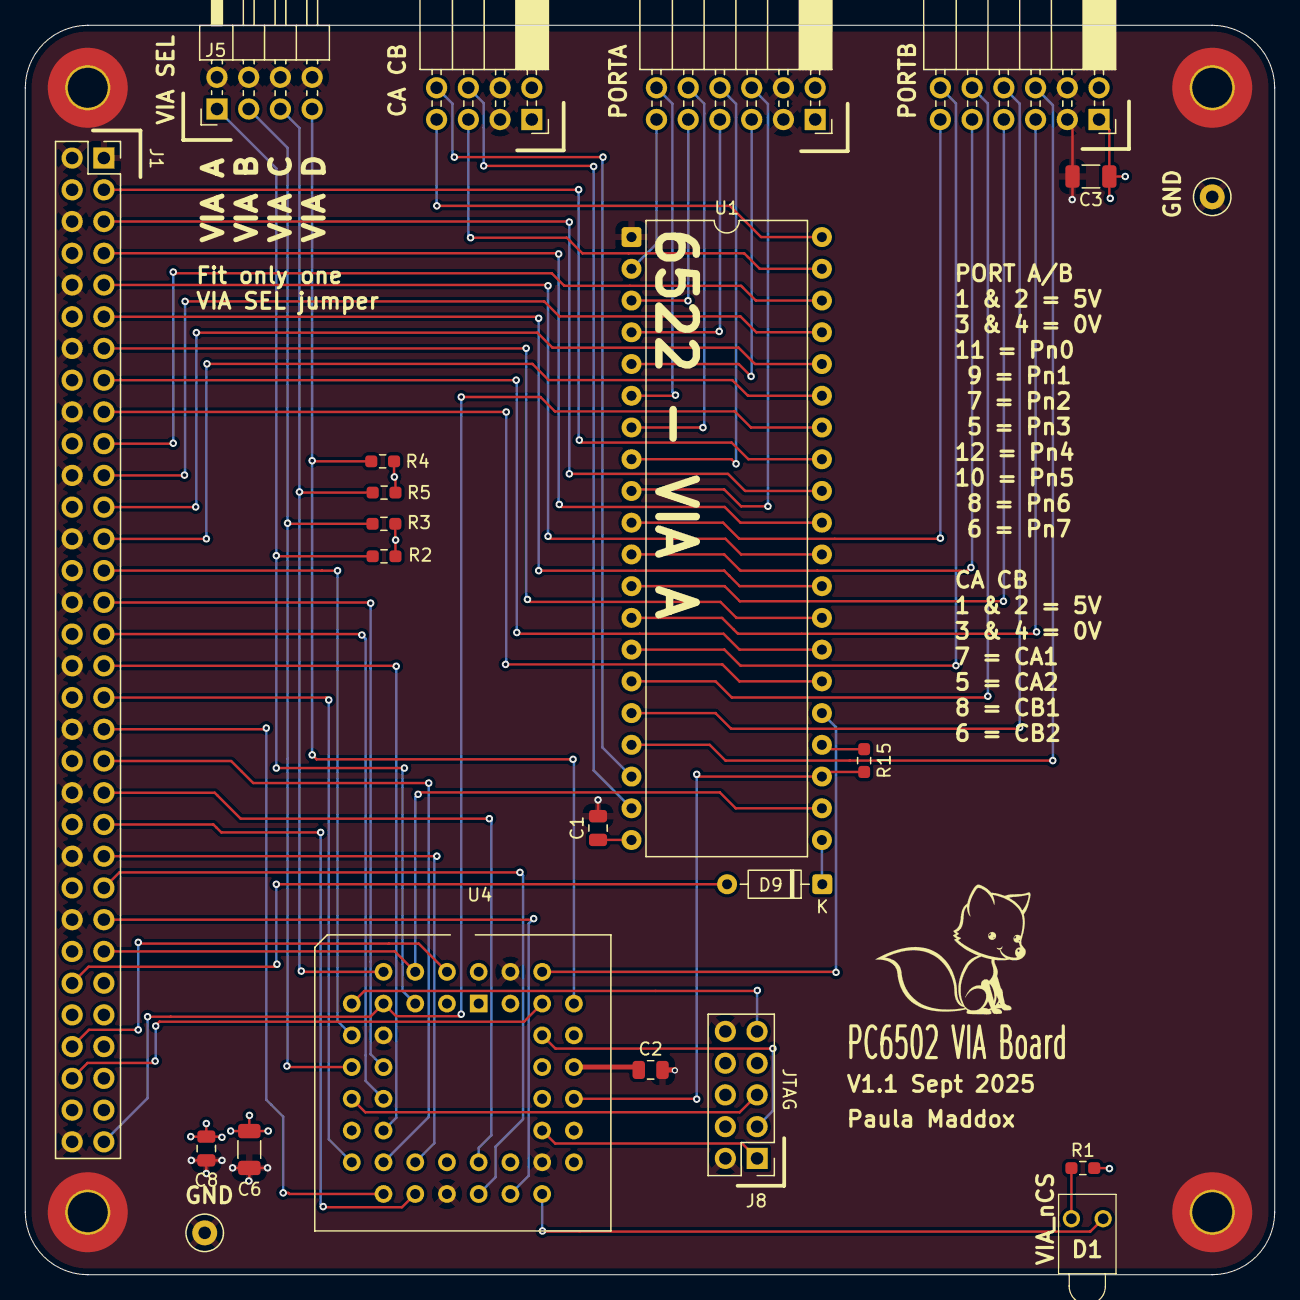
[picture p33: board PC6502-VIA.kicad_pcb from above]

Board: 4 copper layers, 100.0 x 100.0 mm, 28 parts (0 on the bottom side), 64 nets.
