TechPaula/PC6502/Schematics/PC6502-DUALSPI/PC6502-DUALSPI.kicad_pcb

## KiCad design Schematics/PC6502-DUALSPI/PC6502-DUALSPI.kicad_pcb (2025-10-12, last stored version)

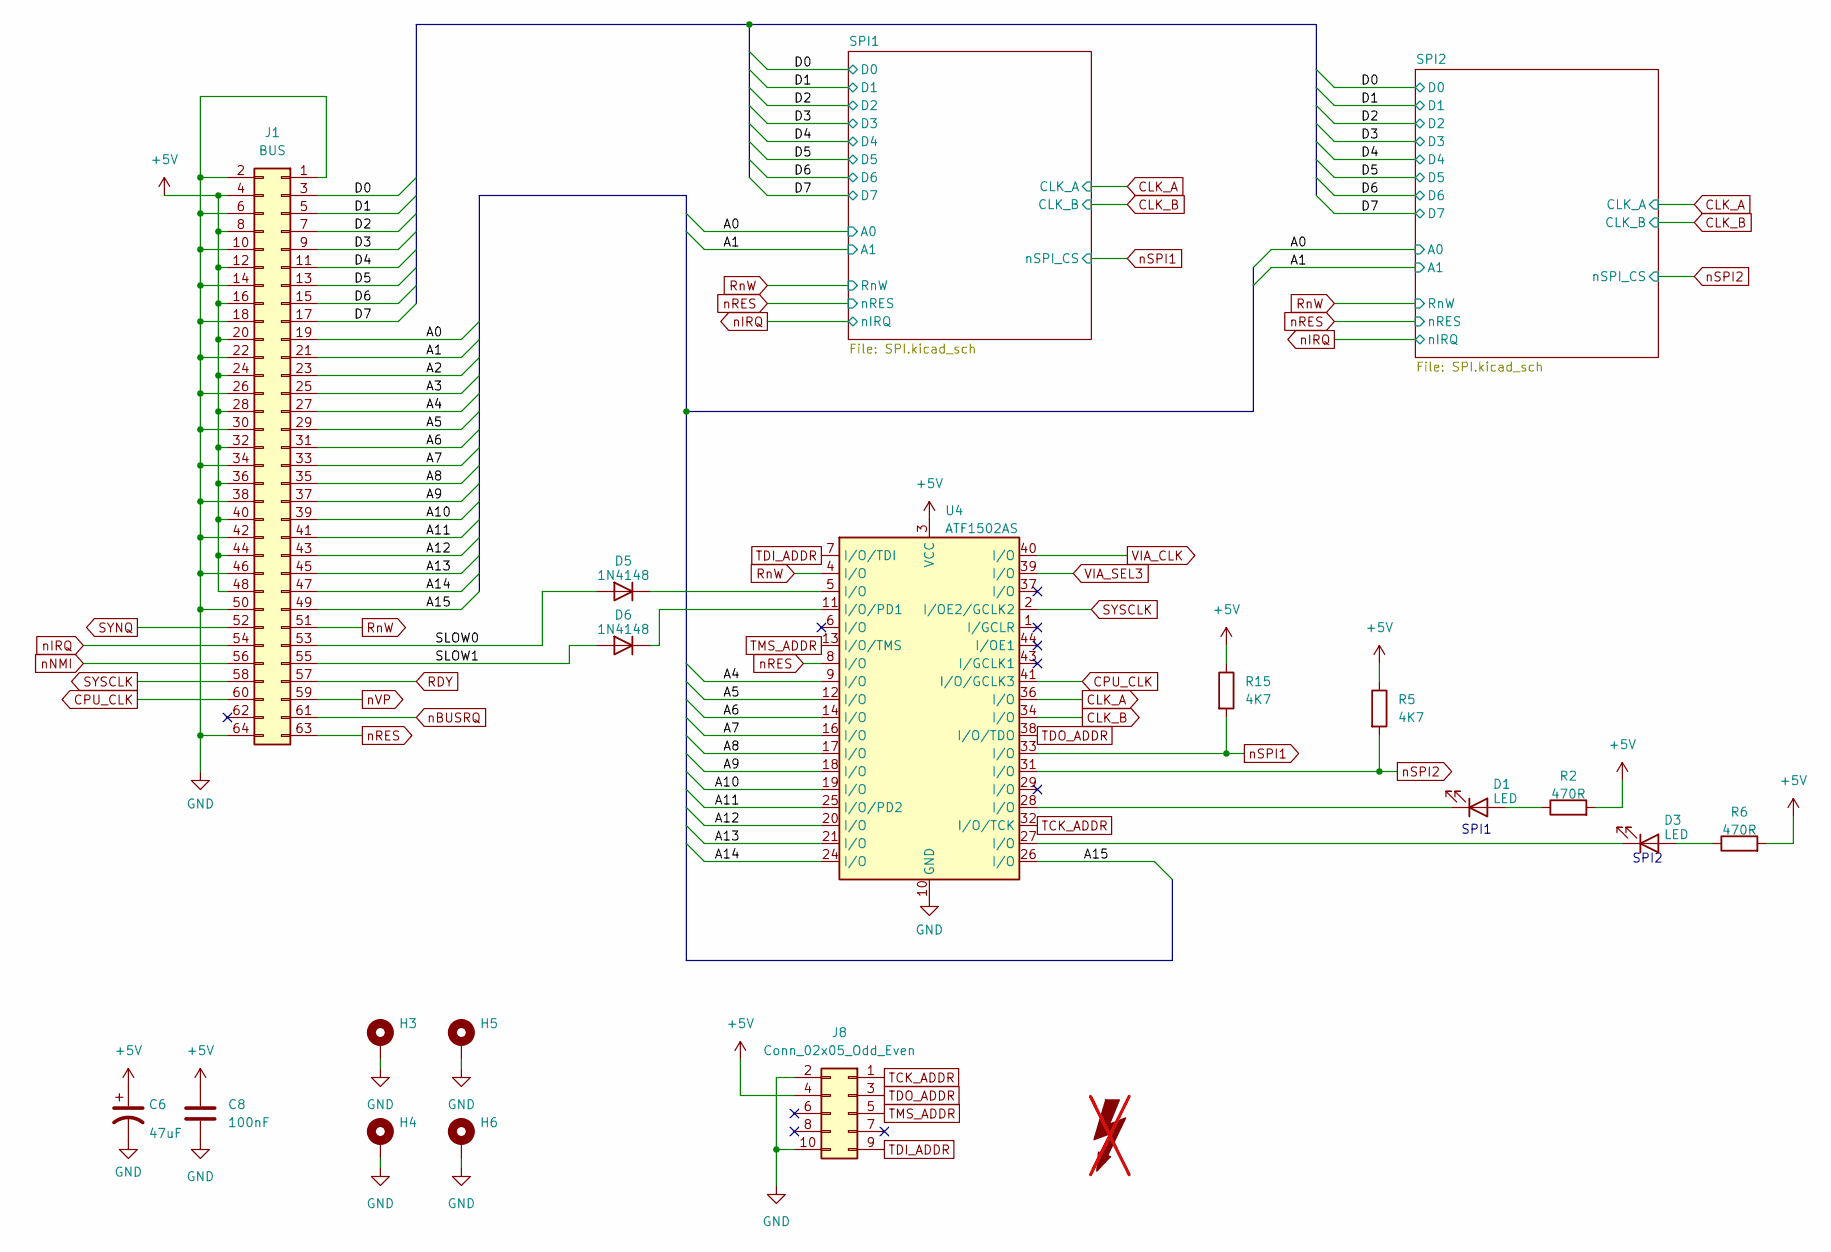
[picture p34: schematic PC6502-DUALSPI.kicad_sch]

Parts:
C6: 47uF; C_1206_3216Metric; LCSC C96123
C8: 100nF; C_0805_2012Metric
D1, D3: LED; LTL4221NHBP
D5, D6: 1N4148; D_DO-35_SOD27_P7.62mm_Horizontal; LCSC DNF
FOX1: SYM_Flash_Large; Fox_avatar_18mm; LCSC DNF; not fitted
H3, H4, H5, H6: MountingHole_Pad; MountingHole_3.2mm_M3_Pad_TopBottom; LCSC DNF
J1: BUS; PinSocket_2x32_P2.54mm_Vertical; LCSC DNF
J8: Conn_02x05_Odd_Even; PinHeader_2x05_P2.54mm_Vertical
R2, R6: 470R; R_0603_1608Metric_Pad0.98x0.95mm_HandSolder
R5, R15: 4K7; R_0603_1608Metric_Pad0.98x0.95mm_HandSolder
U4: ATF1502AS; PLCC-44_THT-Socket

Connections:
+5V: C6.1, C8.1, J1.4, J1.8, J1.12, J1.16, J1.20, J1.24, J1.28, J1.32, J1.36, J1.40, J1.44, J1.48, J8.4, R2.2, R5.1, R6.2, R15.1, U4.3 (VCC), U4.15 (VCC), U4.23 (VCC), U4.35 (VCC); also elsewhere on the board
/A0: J1.19; also elsewhere on the board
/A1: J1.21; also elsewhere on the board
/A2: J1.23
/A3: J1.25
/A4: J1.27, U4.9 (I/O)
/A5: J1.29, U4.12 (I/O)
/A6: J1.31, U4.14 (I/O)
/A7: J1.33, U4.16 (I/O)
/A8: J1.35, U4.17 (I/O)
/A9: J1.37, U4.18 (I/O)
/A10: J1.39, U4.19 (I/O)
/A11: J1.41, U4.25 (I/O/PD2)
/A12: J1.43, U4.20 (I/O)
/A13: J1.45, U4.21 (I/O)
/A14: J1.47, U4.24 (I/O)
/A15: J1.49, U4.26 (I/O)
/D0: J1.3; also elsewhere on the board
/D1: J1.5; also elsewhere on the board
/D2: J1.7; also elsewhere on the board
/D3: J1.9; also elsewhere on the board
/D4: J1.11; also elsewhere on the board
/D5: J1.13; also elsewhere on the board
/D6: J1.15; also elsewhere on the board
/D7: J1.17; also elsewhere on the board
/SLOW0: D5.2 (A), J1.53
/SLOW1: D6.2 (A), J1.55
CLK_A: U4.36 (I/O); also elsewhere on the board
CLK_B: U4.34 (I/O); also elsewhere on the board
CPU_CLK: J1.60, U4.41 (I/O/GCLK3); also elsewhere on the board
GND: C6.2, C8.2, H3.1, H4.1, H5.1, H6.1, J1.1, J1.2, J1.6, J1.10, J1.14, J1.18, J1.22, J1.26, J1.30, J1.34, J1.38, J1.42, J1.46, J1.50, J1.64, J8.2, J8.10, U4.10 (GND), U4.22 (GND), U4.30 (GND), U4.42 (GND); also elsewhere on the board
unnamed: D1.2 (A), R2.1
unnamed: D1.1 (K), U4.28 (I/O)
unnamed: D3.2 (A), R6.1
unnamed: D3.1 (K), U4.27 (I/O)
unnamed: D5.1 (K), U4.5 (I/O)
unnamed: D6.1 (K), U4.11 (I/O/PD1)
RDY: J1.57
RnW: J1.51, U4.4 (I/O); also elsewhere on the board
SYNQ: J1.52
SYSCLK: J1.58, U4.2 (I/OE2/GCLK2); also elsewhere on the board
TCK_ADDR: J8.1, U4.32 (I/O/TCK)
TDI_ADDR: J8.9, U4.7 (I/O/TDI)
TDO_ADDR: J8.3, U4.38 (I/O/TDO)
TMS_ADDR: J8.5, U4.13 (I/O/TMS)
VIA_CLK: U4.40 (I/O)
VIA_SEL3: U4.39 (I/O)
nBUSRQ: J1.61
nIRQ: J1.54; also elsewhere on the board
nNMI: J1.56
nRES: J1.63, U4.8 (I/O); also elsewhere on the board
nSPI1: R15.2, U4.33 (I/O); also elsewhere on the board
nSPI2: R5.2, U4.31 (I/O); also elsewhere on the board
nVP: J1.59

Notes on the sheet:
SPI1
SPI2

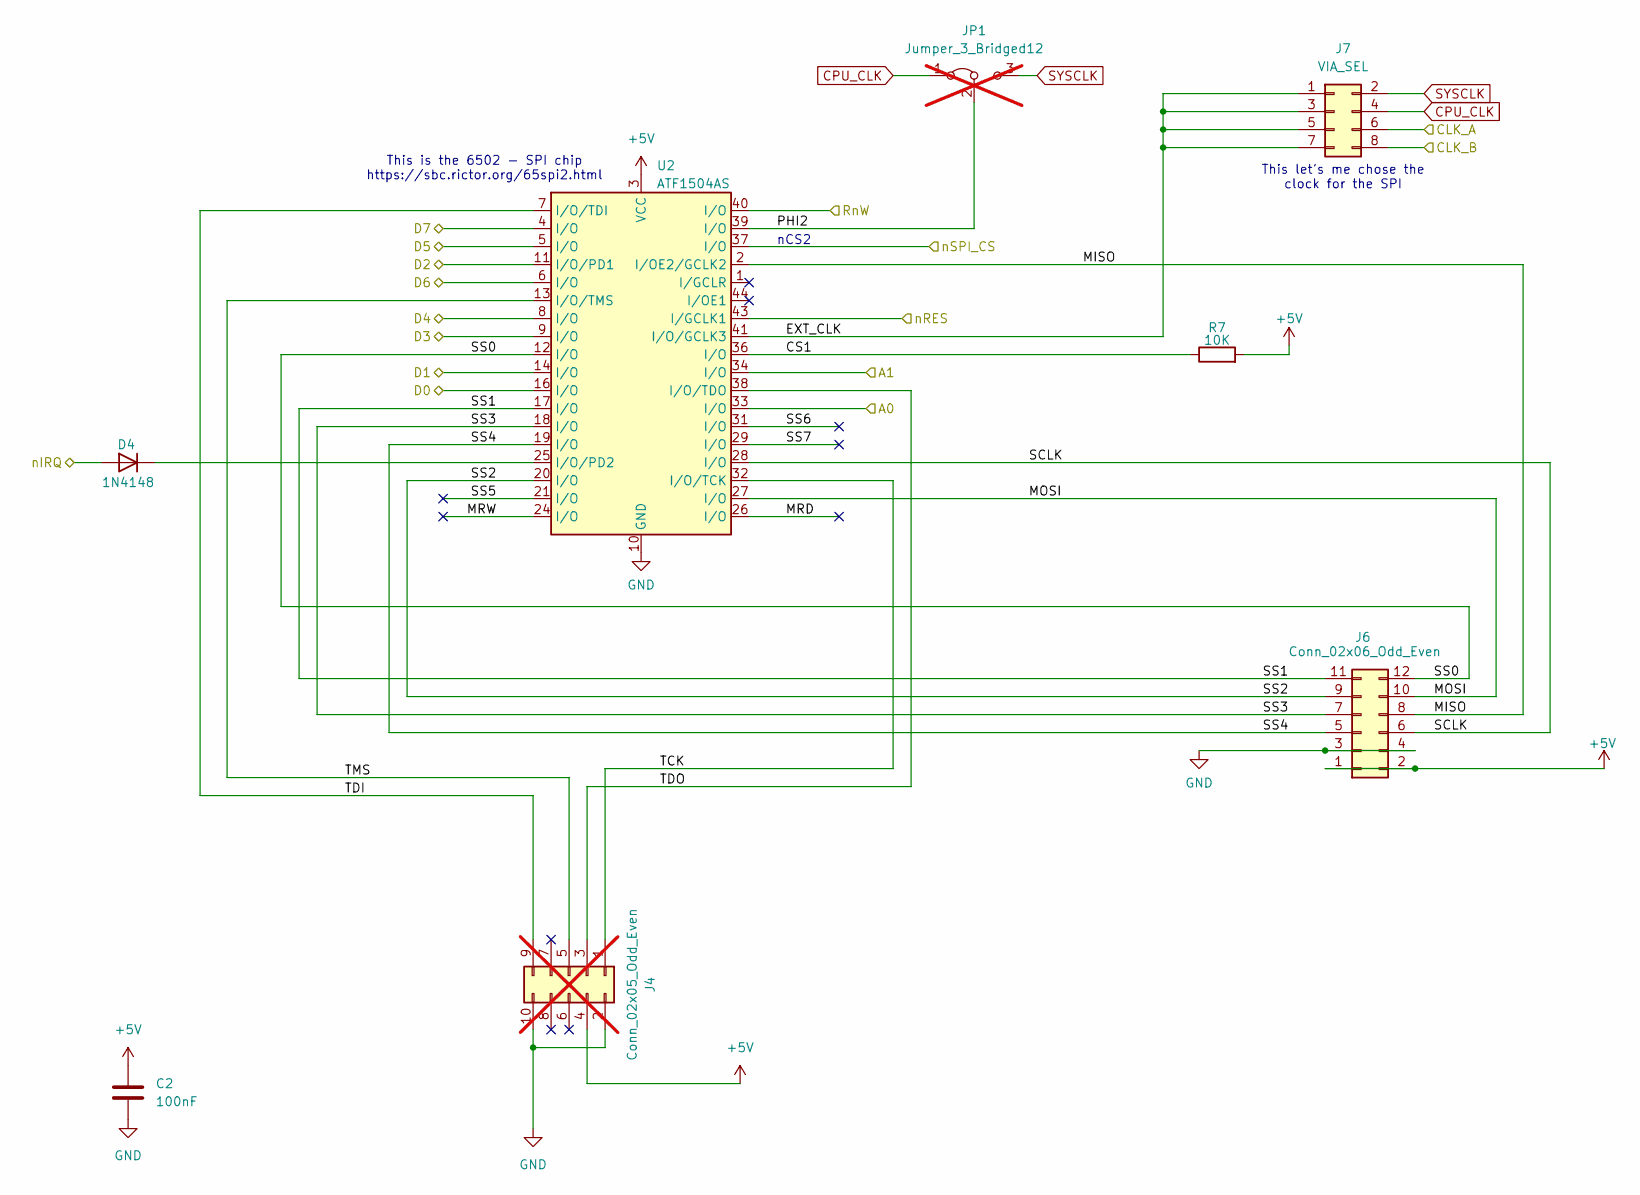
[picture p35: schematic SPI.kicad_sch]

Parts:
C2: 100nF; C_0805_2012Metric
D4: 1N4148; D_DO-35_SOD27_P7.62mm_Horizontal; LCSC DNF
J4: Conn_02x05_Odd_Even; PinHeader_2x05_P2.54mm_Vertical; LCSC DNF; not fitted
J6: Conn_02x06_Odd_Even; PinSocket_2x06_P2.54mm_Horizontal
J7: VIA_SEL; PinHeader_2x04_P2.54mm_Horizontal
JP1: Jumper_3_Bridged12; SolderJumper-3_P1.3mm_Bridged12_RoundedPad1.0x1.5mm_NumberL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; LCSC DNF; not fitted
R7: 10K; R_0603_1608Metric_Pad0.98x0.95mm_HandSolder
U2: ATF1504AS; PLCC-44_THT-Socket; LCSC DNP

Connections:
+5V: C2.1, J4.4, J6.1, J6.2, R7.2, U2.3 (VCC), U2.15 (VCC), U2.23 (VCC), U2.35 (VCC); also elsewhere on the board
/A0: U2.33 (I/O); also elsewhere on the board
/A1: U2.34 (I/O); also elsewhere on the board
/D0: U2.16 (I/O); also elsewhere on the board
/D1: U2.14 (I/O); also elsewhere on the board
/D2: U2.11 (I/O/PD1); also elsewhere on the board
/D3: U2.9 (I/O); also elsewhere on the board
/D4: U2.8 (I/O); also elsewhere on the board
/D5: U2.5 (I/O); also elsewhere on the board
/D6: U2.6 (I/O); also elsewhere on the board
/D7: U2.4 (I/O); also elsewhere on the board
/SPI1/CS1: R7.1, U2.36 (I/O)
/SPI1/EXT_CLK: J7.1, J7.3, J7.5, J7.7, U2.41 (I/O/GCLK3)
/SPI1/MISO: J6.8, U2.2 (I/OE2/GCLK2)
/SPI1/MOSI: J6.10, U2.27 (I/O)
/SPI1/MRD: U2.26 (I/O)
/SPI1/MRW: U2.24 (I/O)
/SPI1/PHI2: JP1.2 (C), U2.39 (I/O)
/SPI1/SCLK: J6.6, U2.28 (I/O)
/SPI1/SS0: J6.12, U2.12 (I/O)
/SPI1/SS1: J6.11, U2.17 (I/O)
/SPI1/SS2: J6.9, U2.20 (I/O)
/SPI1/SS3: J6.7, U2.18 (I/O)
/SPI1/SS4: J6.5, U2.19 (I/O)
/SPI1/SS5: U2.21 (I/O)
/SPI1/SS6: U2.31 (I/O)
/SPI1/SS7: U2.29 (I/O)
/SPI1/TCK: J4.1, U2.32 (I/O/TCK)
/SPI1/TDI: J4.9, U2.7 (I/O/TDI)
/SPI1/TDO: J4.3, U2.38 (I/O/TDO)
/SPI1/TMS: J4.5, U2.13 (I/O/TMS)
CLK_A: J7.6; also elsewhere on the board
CLK_B: J7.8; also elsewhere on the board
CPU_CLK: J7.4, JP1.1 (A); also elsewhere on the board
GND: C2.2, J4.2, J4.10, J6.3, J6.4, U2.10 (GND), U2.22 (GND), U2.30 (GND), U2.42 (GND); also elsewhere on the board
unnamed: D4.1 (K), U2.25 (I/O/PD2)
RnW: U2.40 (I/O); also elsewhere on the board
SYSCLK: J7.2, JP1.3 (B); also elsewhere on the board
nIRQ: D4.2 (A); also elsewhere on the board
nRES: U2.43 (I/GCLK1); also elsewhere on the board
nSPI1: U2.37 (I/O); also elsewhere on the board

Parts of its further copies:
C1: 100nF; C_0805_2012Metric
D2: 1N4148; D_DO-35_SOD27_P7.62mm_Horizontal; LCSC DNF
J2: Conn_02x05_Odd_Even; PinHeader_2x05_P2.54mm_Vertical; LCSC DNF; not fitted
J3: Conn_02x06_Odd_Even; PinSocket_2x06_P2.54mm_Horizontal
J5: VIA_SEL; PinHeader_2x04_P2.54mm_Horizontal
JP2: Jumper_3_Bridged12; SolderJumper-3_P1.3mm_Bridged12_RoundedPad1.0x1.5mm_NumberL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; LCSC DNF; not fitted
R4: 10K; R_0603_1608Metric_Pad0.98x0.95mm_HandSolder
U1: ATF1504AS; PLCC-44_THT-Socket; LCSC DNP

Connections of its further copies:
+5V: C1.1, J2.4, J3.1, J3.2, R4.2, U1.3 (VCC), U1.15 (VCC), U1.23 (VCC), U1.35 (VCC); also elsewhere on the board
/A0: U1.33 (I/O); also elsewhere on the board
/A1: U1.34 (I/O); also elsewhere on the board
/D0: U1.16 (I/O); also elsewhere on the board
/D1: U1.14 (I/O); also elsewhere on the board
/D2: U1.11 (I/O/PD1); also elsewhere on the board
/D3: U1.9 (I/O); also elsewhere on the board
/D4: U1.8 (I/O); also elsewhere on the board
/D5: U1.5 (I/O); also elsewhere on the board
/D6: U1.6 (I/O); also elsewhere on the board
/D7: U1.4 (I/O); also elsewhere on the board
/SPI2/CS1: R4.1, U1.36 (I/O)
/SPI2/EXT_CLK: J5.1, J5.3, J5.5, J5.7, U1.41 (I/O/GCLK3)
/SPI2/MISO: J3.8, U1.2 (I/OE2/GCLK2)
/SPI2/MOSI: J3.10, U1.27 (I/O)
/SPI2/MRD: U1.26 (I/O)
/SPI2/MRW: U1.24 (I/O)
/SPI2/PHI2: JP2.2 (C), U1.39 (I/O)
/SPI2/SCLK: J3.6, U1.28 (I/O)
/SPI2/SS0: J3.12, U1.12 (I/O)
/SPI2/SS1: J3.11, U1.17 (I/O)
/SPI2/SS2: J3.9, U1.20 (I/O)
/SPI2/SS3: J3.7, U1.18 (I/O)
/SPI2/SS4: J3.5, U1.19 (I/O)
/SPI2/SS5: U1.21 (I/O)
/SPI2/SS6: U1.31 (I/O)
/SPI2/SS7: U1.29 (I/O)
/SPI2/TCK: J2.1, U1.32 (I/O/TCK)
/SPI2/TDI: J2.9, U1.7 (I/O/TDI)
/SPI2/TDO: J2.3, U1.38 (I/O/TDO)
/SPI2/TMS: J2.5, U1.13 (I/O/TMS)
CLK_A: J5.6; also elsewhere on the board
CLK_B: J5.8; also elsewhere on the board
CPU_CLK: J5.4, JP2.1 (A); also elsewhere on the board
GND: C1.2, J2.2, J2.10, J3.3, J3.4, U1.10 (GND), U1.22 (GND), U1.30 (GND), U1.42 (GND); also elsewhere on the board
unnamed: D2.1 (K), U1.25 (I/O/PD2)
RnW: U1.40 (I/O); also elsewhere on the board
SYSCLK: J5.2, JP2.3 (B); also elsewhere on the board
nIRQ: D2.2 (A); also elsewhere on the board
nRES: U1.43 (I/GCLK1); also elsewhere on the board
nSPI2: U1.37 (I/O); also elsewhere on the board

Notes on the sheet:
This let's me chose the clock for the SPI
This is the 6502 - SPI chip https://sbc.rictor.org/65spi2.html
nCS2

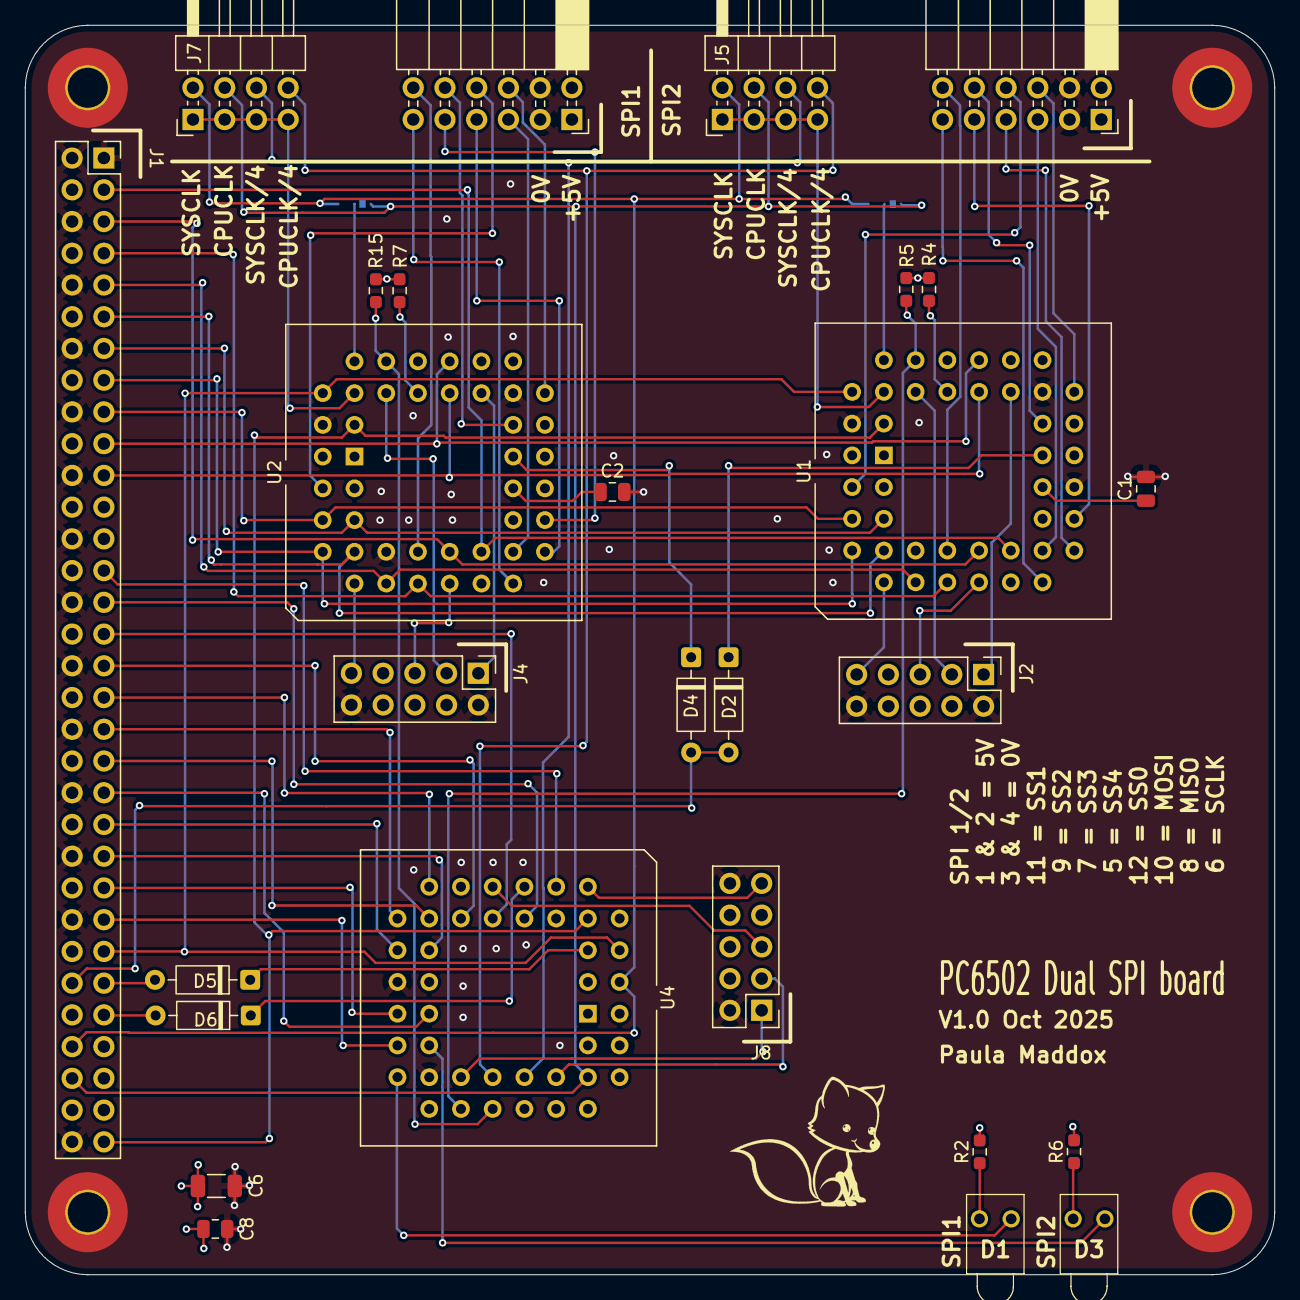
[picture p36: board PC6502-DUALSPI.kicad_pcb from above]

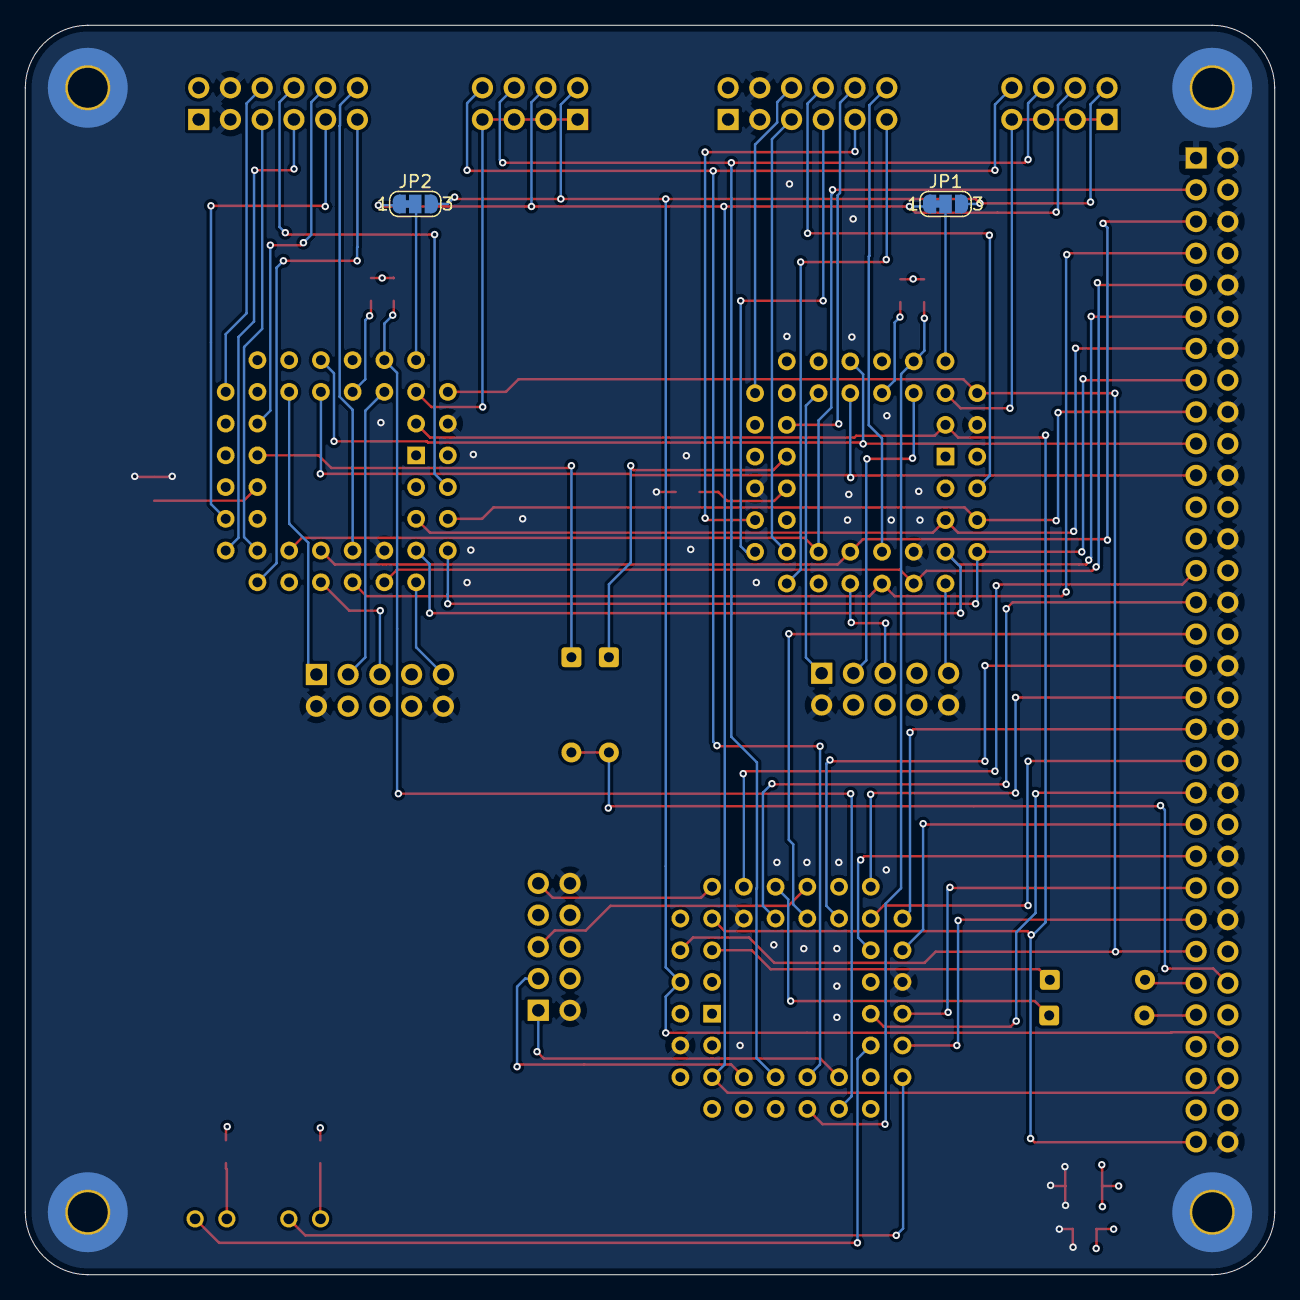
[picture p37: board PC6502-DUALSPI.kicad_pcb from below]

Board: 4 copper layers, 100.0 x 100.0 mm, 34 parts (2 on the bottom side), 77 nets.
