TechPaula/PC6502/Schematics/PC6502-STORAGE/PC6502-STORAGE.kicad_pcb

## KiCad design Schematics/PC6502-STORAGE/PC6502-STORAGE.kicad_pcb (2025-10-12, last stored version)

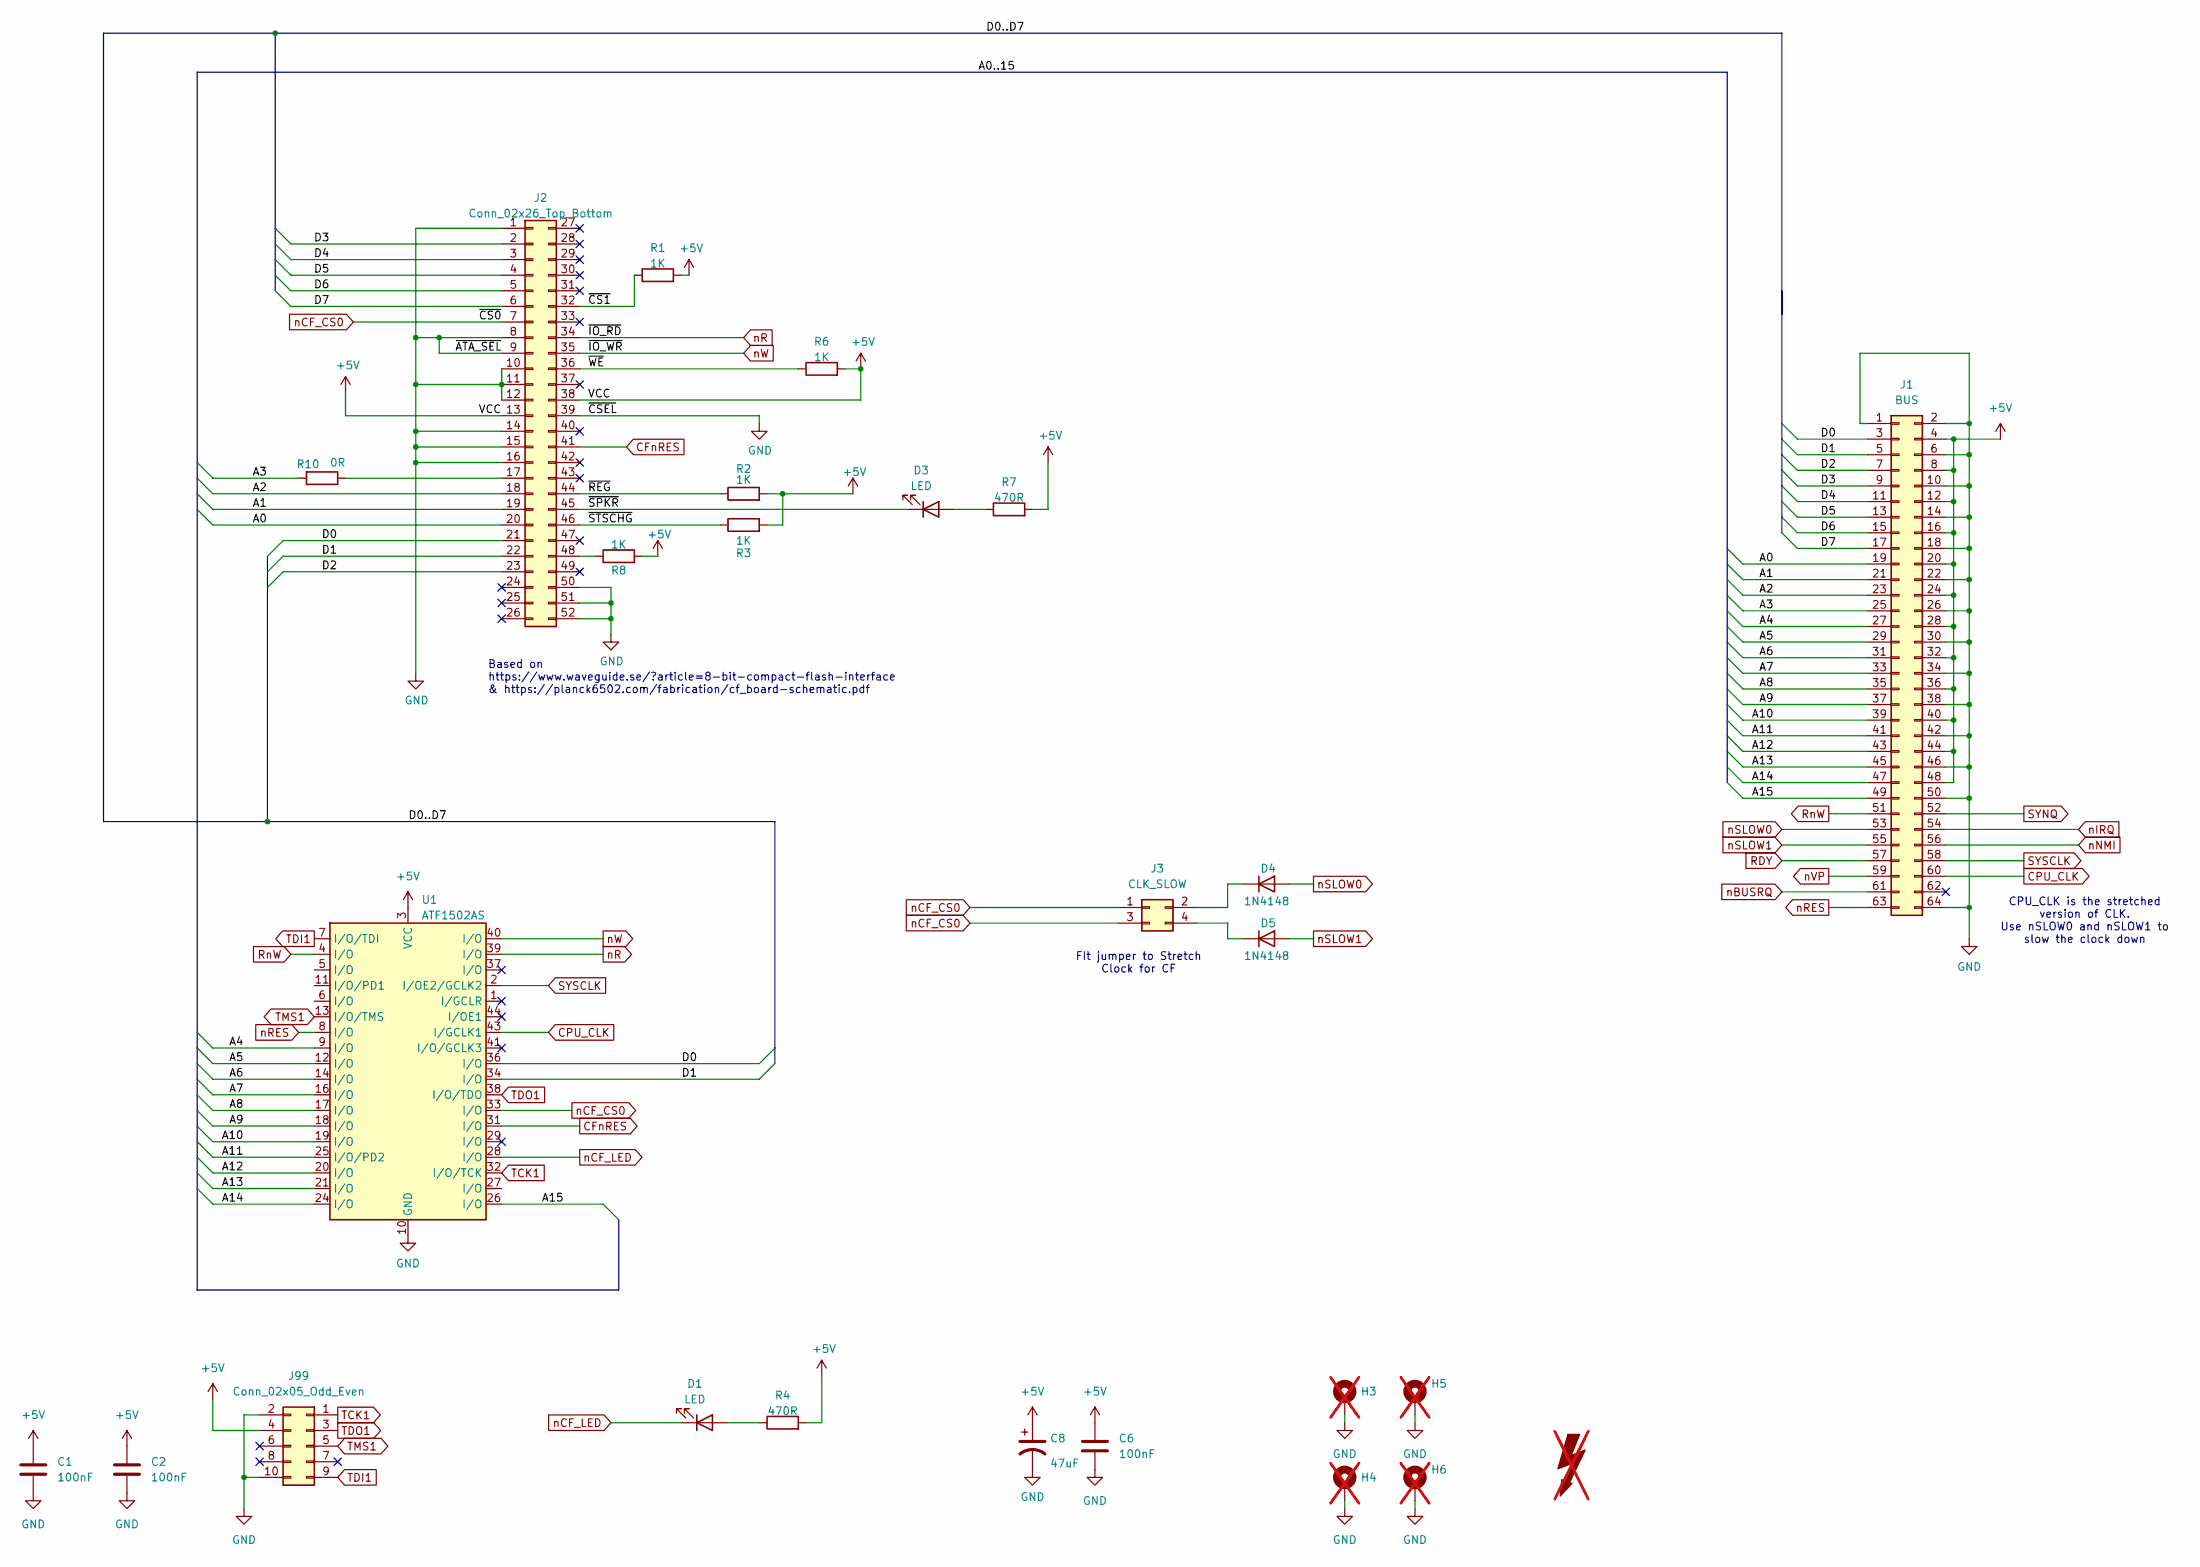
[picture p38: schematic PC6502-STORAGE.kicad_sch]

Parts:
C1, C2, C6: 100nF; C_0805_2012Metric
C8: 47uF; C_1206_3216Metric; LCSC C96123
D1, D3: LED; LTL4221NHBP; LCSC DNF
D4, D5: 1N4148; D_DO-35_SOD27_P7.62mm_Horizontal; LCSC DNF
FOX1: SYM_Flash_Large; Fox_avatar_18mm; LCSC DNF; not fitted
H3, H4, H5, H6: MountingHole_Pad; MountingHole_3.2mm_M3_Pad_TopBottom; LCSC DNF; not fitted
J1: BUS; PinSocket_2x32_P2.54mm_Vertical; LCSC DNF
J2: Conn_02x26_Top_Bottom; SD-SMD_CFH-L3C1LBL01MN0; LCSC C444350
J3: CLK_SLOW; PinHeader_2x02_P2.54mm_Horizontal; LCSC DNF
J99: Conn_02x05_Odd_Even; PinHeader_2x05_P2.54mm_Vertical; LCSC DNF
R1, R2, R3, R6, R8: 1K; R_0603_1608Metric_Pad0.98x0.95mm_HandSolder
R4, R7: 470R; R_0603_1608Metric_Pad0.98x0.95mm_HandSolder
R10: 0R; R_0603_1608Metric_Pad0.98x0.95mm_HandSolder
U1: ATF1502AS; PLCC-44_THT-Socket; LCSC DNP

Connections:
+5V: C1.1, C2.1, C6.1, C8.1, J1.4, J1.8, J1.12, J1.16, J1.20, J1.24, J1.28, J1.32, J1.36, J1.40, J1.44, J1.48, J2.13, J2.38, J99.4, R1.2, R2.2, R3.2, R4.2, R6.2, R7.2, R8.2, U1.3 (VCC), U1.15 (VCC), U1.23 (VCC), U1.35 (VCC)
/A0: J1.19, J2.20
/A1: J1.21, J2.19
/A2: J1.23, J2.18
/A3: J1.25, R10.2
/A4: J1.27, U1.9 (I/O)
/A5: J1.29, U1.12 (I/O)
/A6: J1.31, U1.14 (I/O)
/A7: J1.33, U1.16 (I/O)
/A8: J1.35, U1.17 (I/O)
/A9: J1.37, U1.18 (I/O)
/A10: J1.39, U1.19 (I/O)
/A11: J1.41, U1.25 (I/O/PD2)
/A12: J1.43, U1.20 (I/O)
/A13: J1.45, U1.21 (I/O)
/A14: J1.47, U1.24 (I/O)
/A15: J1.49, U1.26 (I/O)
/D0: J1.3, J2.21, U1.36 (I/O)
/D1: J1.5, J2.22, U1.34 (I/O)
/D2: J1.7, J2.23
/D3: J1.9, J2.2
/D4: J1.11, J2.3
/D5: J1.13, J2.4
/D6: J1.15, J2.5
/D7: J1.17, J2.6
/~CS1: J2.32, R1.1
/~REG: J2.44, R2.1
/~SPKR: D3.1 (K), J2.45
/~STSCHG: J2.46, R3.1
/~WE: J2.36, R6.1
CFnRES: J2.41, U1.31 (I/O)
CPU_CLK: J1.60, U1.43 (I/GCLK1)
GND: C1.2, C2.2, C6.2, C8.2, H3.1, H4.1, H5.1, H6.1, J1.1, J1.2, J1.6, J1.10, J1.14, J1.18, J1.22, J1.26, J1.30, J1.34, J1.38, J1.42, J1.46, J1.50, J1.64, J2.1, J2.8, J2.9, J2.10, J2.11, J2.12, J2.14, J2.15, J2.16, J2.39, J2.50, J2.51, J2.52, J99.2, J99.10, U1.10 (GND), U1.22 (GND), U1.30 (GND), U1.42 (GND)
unnamed: D1.2 (A), R4.1
unnamed: D3.2 (A), R7.1
unnamed: D4.1 (K), J3.2
unnamed: D5.1 (K), J3.4
unnamed: J2.17, R10.1
unnamed: J2.48, R8.1
RDY: J1.57
RnW: J1.51, U1.4 (I/O)
SYNQ: J1.52
SYSCLK: J1.58, U1.2 (I/OE2/GCLK2)
TCK1: J99.1, U1.32 (I/O/TCK)
TDI1: J99.9, U1.7 (I/O/TDI)
TDO1: J99.3, U1.38 (I/O/TDO)
TMS1: J99.5, U1.13 (I/O/TMS)
nBUSRQ: J1.61
nCF_CS0: J2.7, J3.1, J3.3, U1.33 (I/O)
nCF_LED: D1.1 (K), U1.28 (I/O)
nIRQ: J1.54
nNMI: J1.56
nR: J2.34, U1.39 (I/O)
nRES: J1.63, U1.8 (I/O)
nSLOW0: D4.2 (A), J1.53
nSLOW1: D5.2 (A), J1.55
nVP: J1.59
nW: J2.35, U1.40 (I/O)

Notes on the sheet:
FIt jumper to Stretch Clock for CF
Based on https://www.waveguide.se/?article=8-bit-compact-flash-interface & https://planck6502.com/fabrication/cf_board-schematic.pdf
CPU_CLK is the stretched version of CLK. Use nSLOW0 and nSLOW1 to slow the clock down

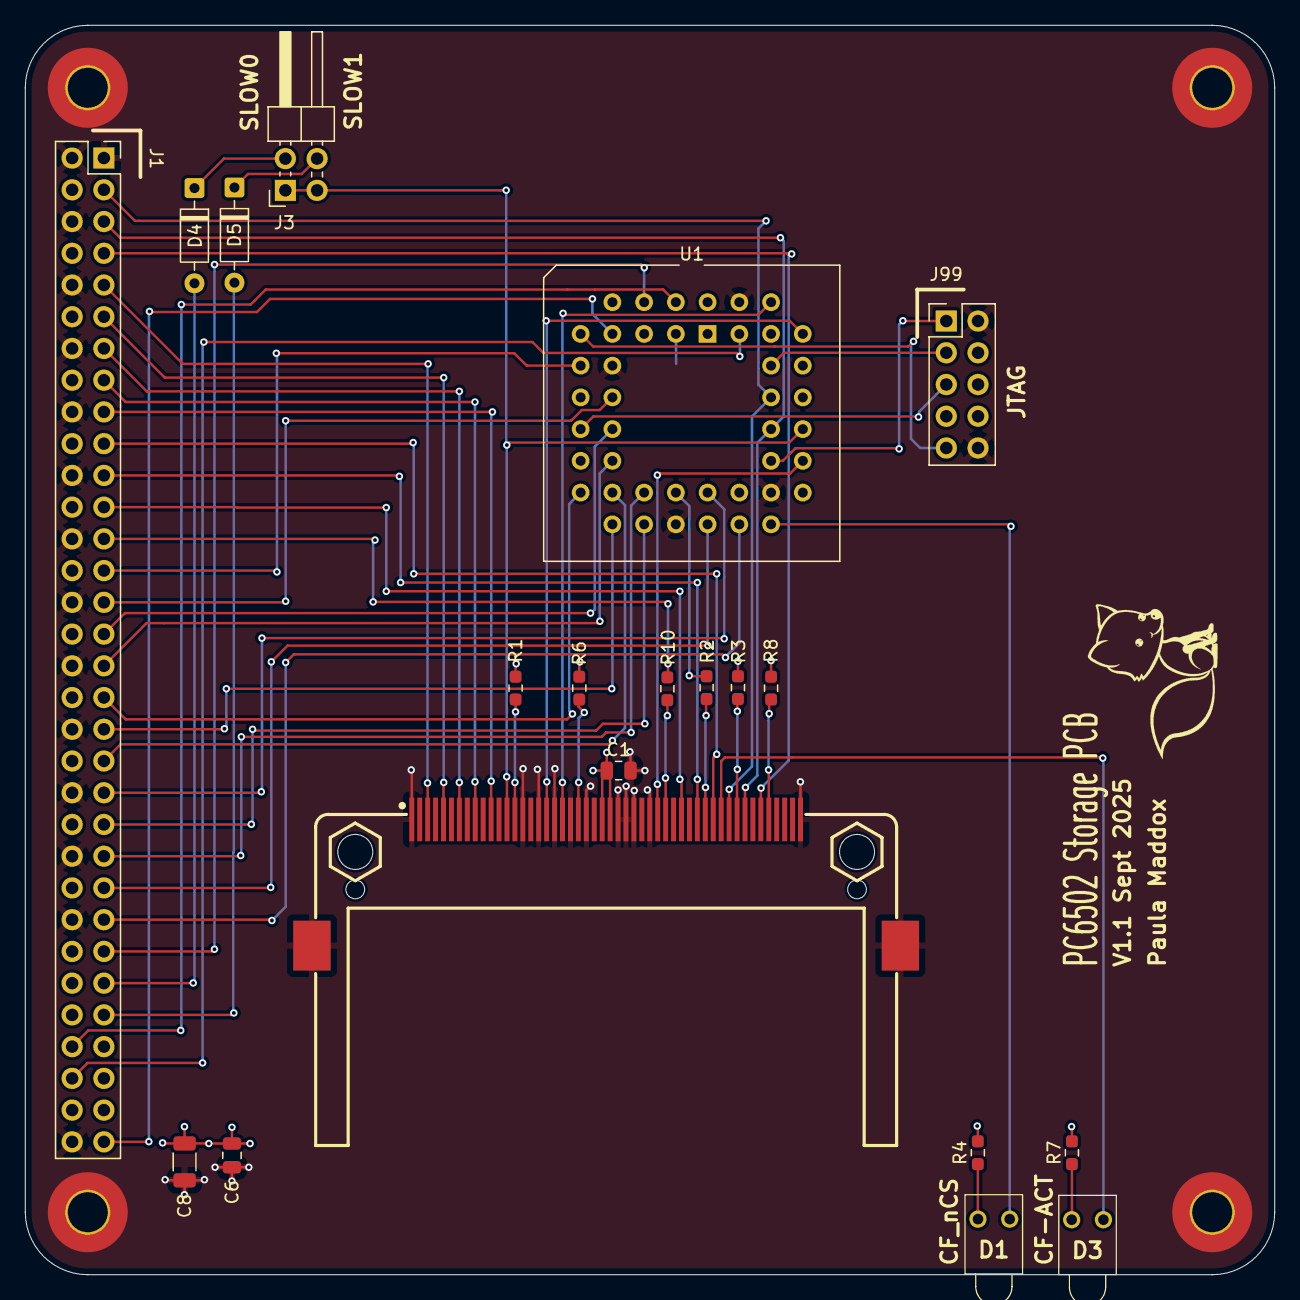
[picture p39: board PC6502-STORAGE.kicad_pcb from above]

Board: 4 copper layers, 100.0 x 100.0 mm, 26 parts (1 on the bottom side), 52 nets.
