TechPaula/PC6502/Schematics/PC6502-POWER/PC6502-POWER.kicad_pcb

## KiCad design Schematics/PC6502-POWER/PC6502-POWER.kicad_pcb (2025-09-21, last stored version)

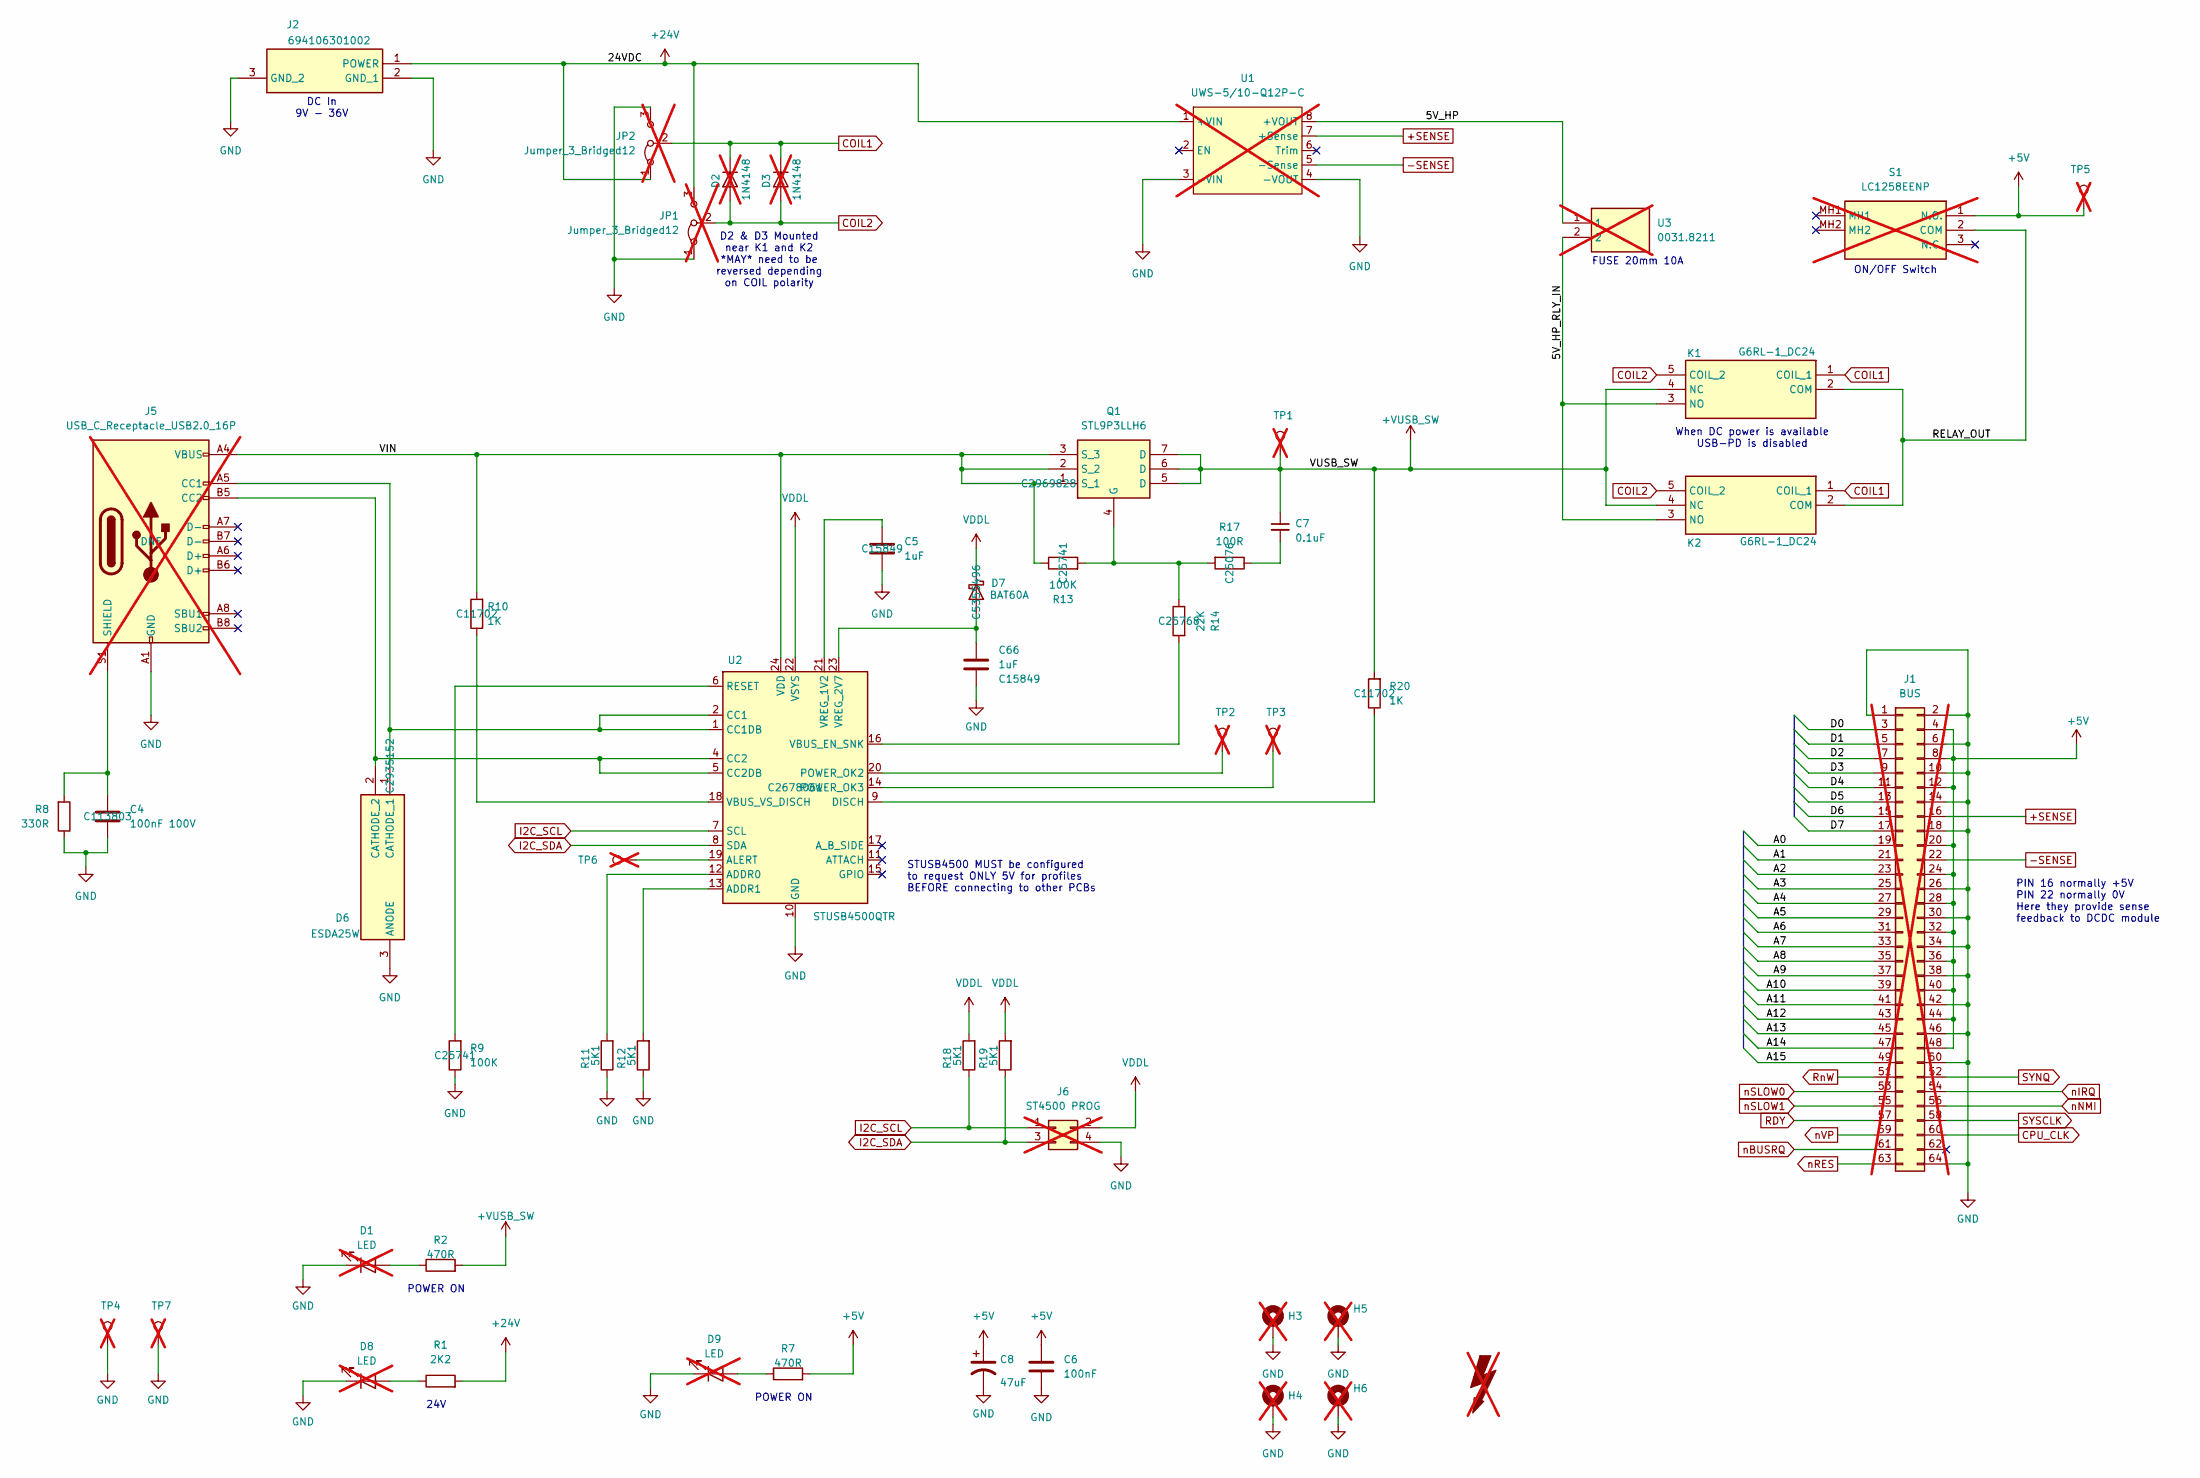
[picture p40: schematic PC6502-POWER.kicad_sch]

Parts:
C4: 100nF 100V; C_0603_1608Metric; LCSC C113803
C5, C66: 1uF; C_0603_1608Metric; LCSC C15849
C6: 100nF; C_0805_2012Metric; LCSC C49678
C7: 0.1uF; C_0603_1608Metric; LCSC C113803
C8: 47uF; C_1206_3216Metric; LCSC C96123
D1, D8, D9: LED; LTL4221NHBP; LCSC DNF; not fitted
D2, D3: 1N4148; D_DO-35_SOD27_P7.62mm_Horizontal; LCSC DNF; not fitted
D6: ESDA25W; SOT65P210X110-3N; Mouser Part Number 511-ESDA25W
D7: BAT60A; D_SOD-323; LCSC C5355496
FOX1: SYM_Flash_Large; Fox_avatar_18mm; LCSC DNF; not fitted
H3, H4, H5, H6: MountingHole_Pad; MountingHole_3.2mm_M3_Pad_TopBottom; LCSC DNF; not fitted
J1: BUS; PinSocket_2x32_P2.54mm_Vertical; LCSC DNF; not fitted
J2: 694106301002; 694106301002_1; Mouser Part Number 710-694106301002
J5: USB_C_Receptacle_USB2.0_16P; USB_C_Receptacle_HCTL_HC-TYPE-C-16P-01A; LCSC DNF; not fitted
J6: ST4500 PROG; PinHeader_2x02_P2.54mm_Horizontal; LCSC DNF; not fitted
JP1, JP2: Jumper_3_Bridged12; SolderJumper-3_P1.3mm_Bridged12_RoundedPad1.0x1.5mm_NumberL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; LCSC DNF; not fitted
K1, K2: G6RL-1_DC24; G6RL1DC24; Mouser Part Number 653-G6RL-1-DC24
Q1: STL9P3LLH6; STL20N6F7; Manufacturer_Part_Number STL9P3LLH6; Mouser Part Number 511-STL9P3LLH6
R1: 2K2; R_0603_1608Metric_Pad0.98x0.95mm_HandSolder; LCSC C4190
R2, R7: 470R; R_0603_1608Metric_Pad0.98x0.95mm_HandSolder; LCSC C23179
R8: 330R; R_0402_1005Metric; LCSC C25104
R9, R13: 100K; R_0402_1005Metric; LCSC C25741
R10, R20: 1K; R_0402_1005Metric; LCSC C11702
R11, R12, R18, R19: 5K1; R_0402_1005Metric; LCSC C25905
R14: 22K; R_0402_1005Metric; LCSC C25768
R17: 100R; R_0402_1005Metric; LCSC C25076
S1: LC1258EENP; Mouser Part Number 612-LC1258EENP; not fitted
TP1, TP2, TP3, TP4, TP5, TP6, TP7: TestPoint; TestPoint_Loop_D1.80mm_Drill1.0mm_Beaded; LCSC DNF; not fitted
U1: UWS-5/10-Q12P-C; UWS510Q48PC; LCSC DNF; not fitted
U2: STUSB4500QTR; QFN-24-1EP_4x4mm_P0.5mm_EP2.7x2.7mm; LCSC C2678061
U3: 0031.8211; 00318211; Mouser Part Number 693-0031.8211; not fitted

Connections:
+5V: C6.1, C8.1, J1.4, J1.8, J1.12, J1.20, J1.24, J1.28, J1.32, J1.36, J1.40, J1.44, J1.48, R7.2, S1.1 (N.O.), TP5.1
+24V: J2.1 (POWER), JP1.3 (B), JP2.1 (A), R1.2, U1.1 (+VIN)
+SENSE: J1.16, U1.7 (+Sense)
+VUSB_SW: C7.1, K1.4 (NC), K2.4 (NC), Q1.5 (D), Q1.6 (D), Q1.7 (D), R2.2, R20.2, TP1.1
-SENSE: J1.22, U1.5 (-Sense)
/5V_HP: U1.8 (+VOUT), U3.1
/5V_HP_RLY_IN: K1.3 (NO), K2.3 (NO), U3.2
/A0: J1.19
/A1: J1.21
/A2: J1.23
/A3: J1.25
/A4: J1.27
/A5: J1.29
/A6: J1.31
/A7: J1.33
/A8: J1.35
/A9: J1.37
/A10: J1.39
/A11: J1.41
/A12: J1.43
/A13: J1.45
/A14: J1.47
/A15: J1.49
/D0: J1.3
/D1: J1.5
/D2: J1.7
/D3: J1.9
/D4: J1.11
/D5: J1.13
/D6: J1.15
/D7: J1.17
/RELAY_OUT: K1.2 (COM), K2.2 (COM), S1.2 (COM)
/VIN: J5.A4 (VBUS), J5.A9 (VBUS), J5.B4 (VBUS), J5.B9 (VBUS), Q1.1 (S_1), Q1.2 (S_2), Q1.3 (S_3), R10.2, R13.1, U2.24 (VDD)
COIL1: D2.1 (K), D3.1 (K), JP2.2 (C), K1.1 (COIL_1), K2.1 (COIL_1)
COIL2: D2.2 (A), D3.2 (A), JP1.2 (C), K1.5 (COIL_2), K2.5 (COIL_2)
CPU_CLK: J1.60
GND: C4.2, C5.2, C6.2, C8.2, C66.2, D1.1 (K), D6.3 (ANODE), D8.1 (K), D9.1 (K), H3.1, H4.1, H5.1, H6.1, J1.1, J1.2, J1.6, J1.10, J1.14, J1.18, J1.26, J1.30, J1.34, J1.38, J1.42, J1.46, J1.50, J1.64, J2.2 (GND_1), J2.3 (GND_2), J5.A1 (GND), J5.A12 (GND), J5.B1 (GND), J5.B12 (GND), J6.4, JP1.1 (A), JP2.3 (B), R8.1, R9.1, R11.1, R12.1, TP4.1, TP7.1, U1.3 (-VIN), U1.4 (-VOUT), U2.10 (GND), U2.25 (GND)
I2C_SCL: J6.1, R18.1, U2.7 (SCL)
I2C_SDA: J6.3, R19.1, U2.8 (SDA)
unnamed: C7.2, R17.1
unnamed: D1.2 (A), R2.1
unnamed: D6.1 (CATHODE_1), J5.A5 (CC1), U2.1 (CC1DB), U2.2 (CC1)
unnamed: D6.2 (CATHODE_2), J5.B5 (CC2), U2.4 (CC2), U2.5 (CC2DB)
unnamed: C66.1, D7.2 (A), U2.23 (VREG_2V7)
unnamed: D8.2 (A), R1.1
unnamed: D9.2 (A), R7.1
unnamed: C4.1, J5.S1 (SHIELD), R8.2
unnamed: Q1.4 (G), R13.2, R14.1, R17.2
unnamed: R11.2, U2.12 (ADDR0)
unnamed: R12.2, U2.13 (ADDR1)
unnamed: TP6.1, U2.19 (ALERT)
unnamed: R20.1, U2.9 (DISCH)
unnamed: TP2.1, U2.20 (POWER_OK2)
unnamed: TP3.1, U2.14 (POWER_OK3)
unnamed: R9.2, U2.6 (RESET)
unnamed: R14.2, U2.16 (VBUS_EN_SNK)
unnamed: R10.1, U2.18 (VBUS_VS_DISCH)
unnamed: C5.1, U2.21 (VREG_1V2)
RDY: J1.57
RnW: J1.51
SYNQ: J1.52
SYSCLK: J1.58
VDDL: D7.1 (K), J6.2, R18.2, R19.2, U2.22 (VSYS)
nBUSRQ: J1.61
nIRQ: J1.54
nNMI: J1.56
nRES: J1.63
nSLOW0: J1.53
nSLOW1: J1.55
nVP: J1.59

Notes on the sheet:
D2 & D3 Mounted near K1 and K2 *MAY* need to be reversed depending on COIL polarity
PIN 16 normally +5V PIN 22 normally 0V Here they provide sense feedback to DCDC module
POWER ON
DC In 9V - 36V
ON/OFF Switch
24V
When DC power is available USB-PD is disabled
STUSB4500 MUST be configured to request ONLY 5V for profiles BEFORE connecting to other PCBs
FUSE 20mm 10A

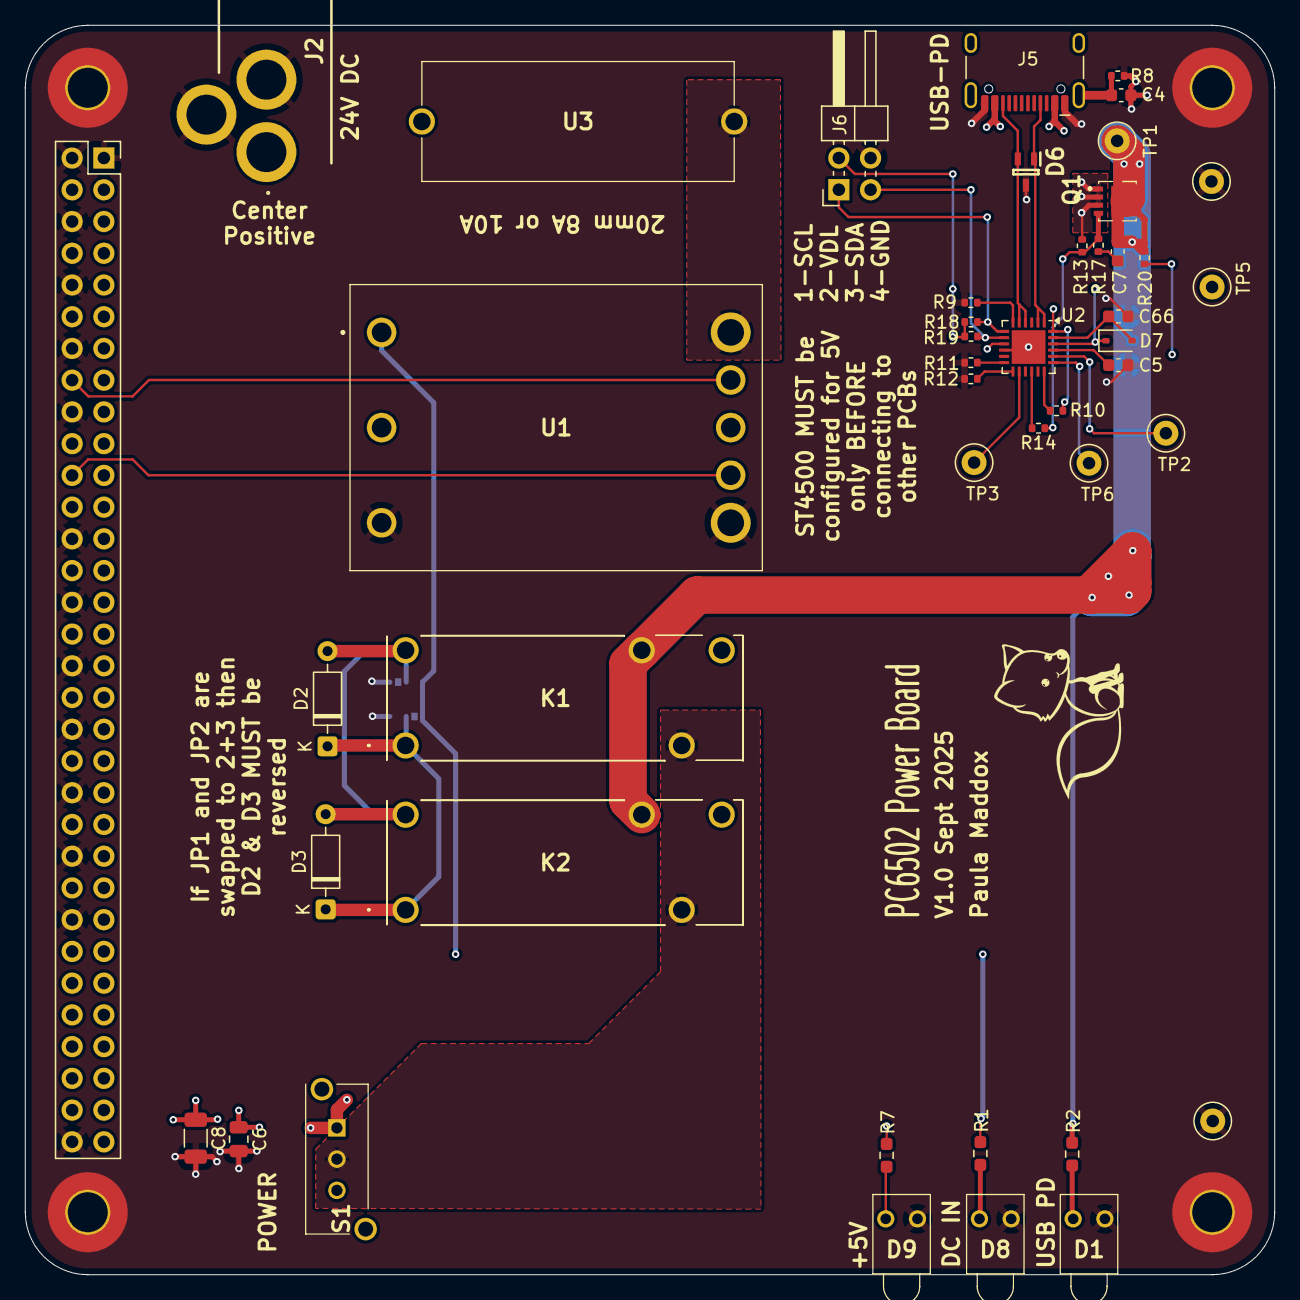
[picture p41: board PC6502-POWER.kicad_pcb from above]

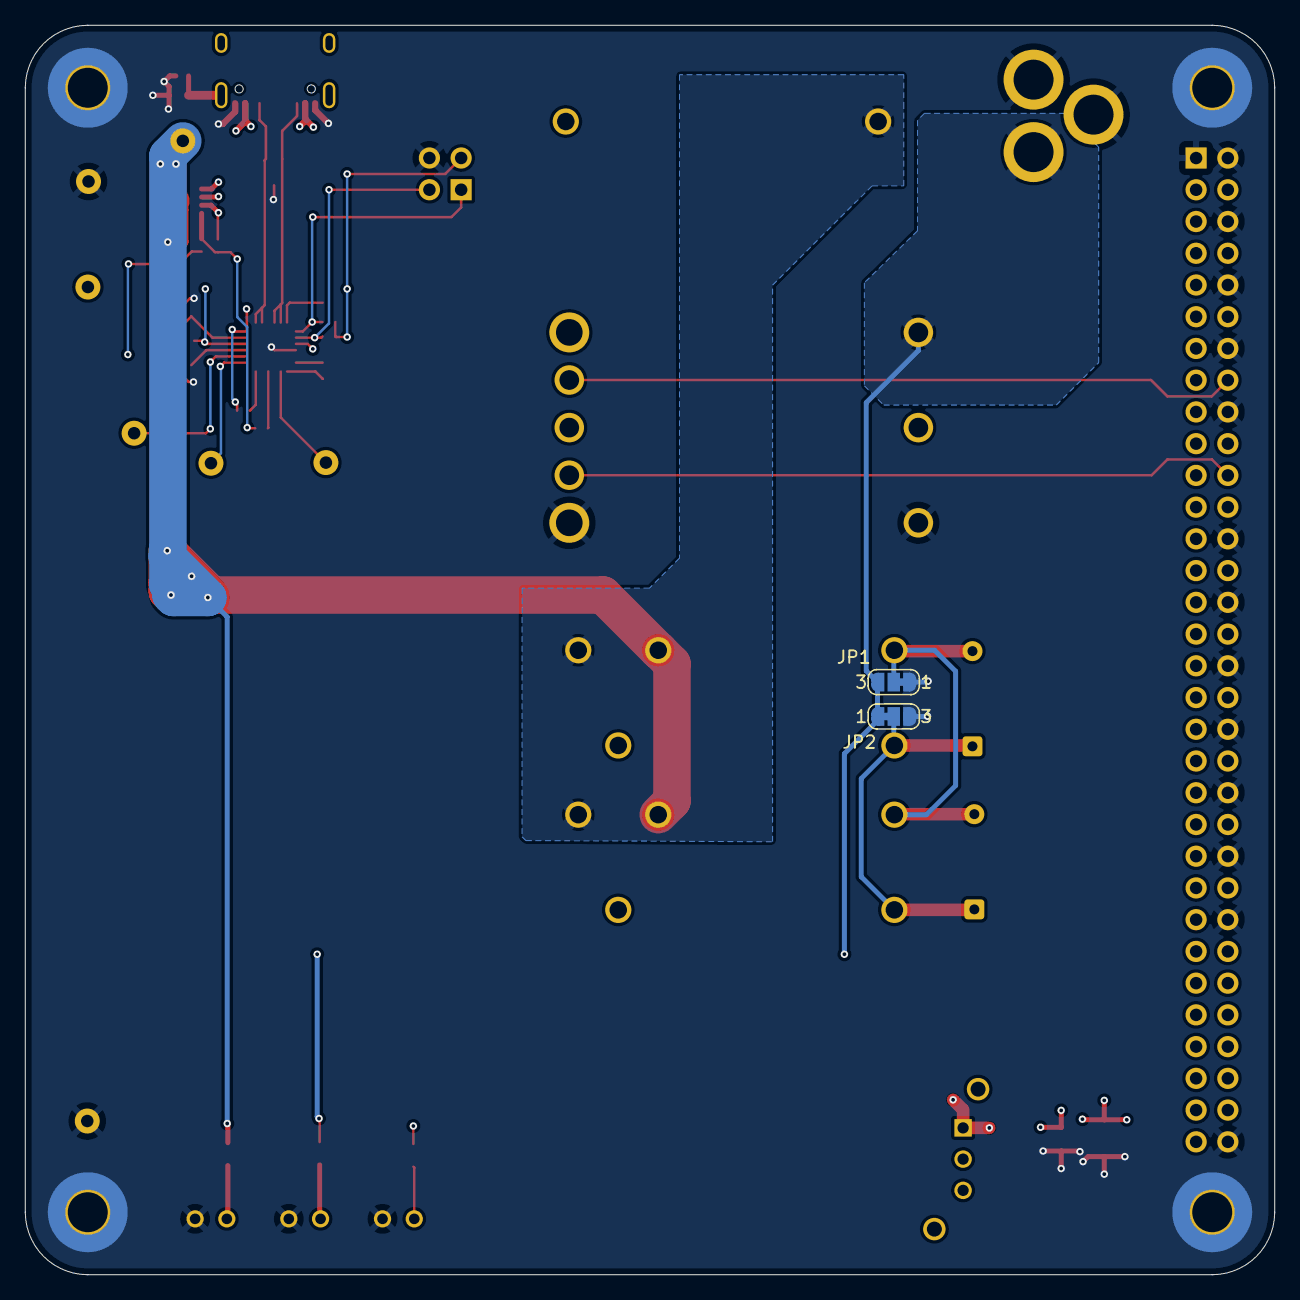
[picture p42: board PC6502-POWER.kicad_pcb from below]

Board: 4 copper layers, 100.0 x 100.0 mm, 52 parts (2 on the bottom side), 34 nets.
