TechPaula/PC6502/Schematics/PC6502-TEMPLATE/PC6502-TEMPLATE.kicad_pcb

## KiCad design Schematics/PC6502-TEMPLATE/PC6502-TEMPLATE.kicad_pcb (2025-09-11, last stored version)

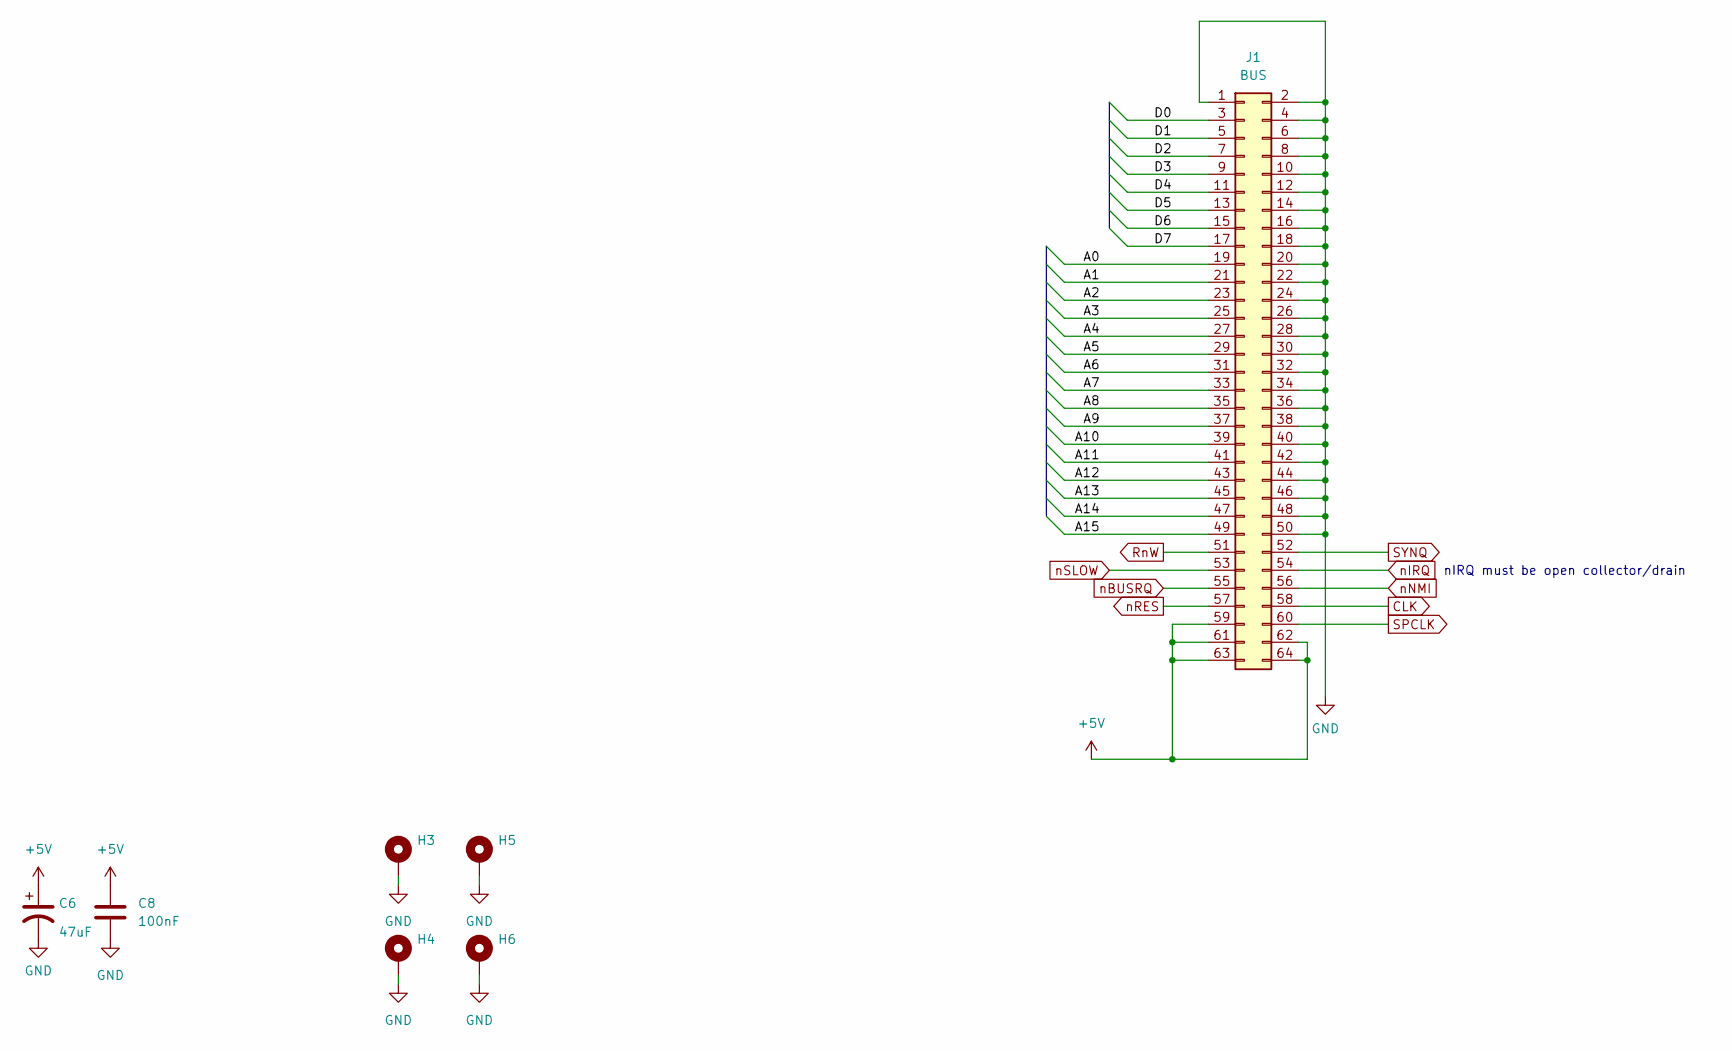
[picture p43: schematic PC6502-TEMPLATE.kicad_sch]

Parts:
C6: 47uF; C_1206_3216Metric; LCSC C96123
C8: 100nF; C_0805_2012Metric
H3, H4, H5, H6: MountingHole_Pad; MountingHole_3.2mm_M3_Pad_TopBottom; LCSC DNF
J1: BUS; PinSocket_2x32_P2.54mm_Vertical; LCSC DNF

Connections:
+5V: C6.1, C8.1, J1.59, J1.61, J1.62, J1.63, J1.64
/A0: J1.19
/A1: J1.21
/A2: J1.23
/A3: J1.25
/A4: J1.27
/A5: J1.29
/A6: J1.31
/A7: J1.33
/A8: J1.35
/A9: J1.37
/A10: J1.39
/A11: J1.41
/A12: J1.43
/A13: J1.45
/A14: J1.47
/A15: J1.49
/D0: J1.3
/D1: J1.5
/D2: J1.7
/D3: J1.9
/D4: J1.11
/D5: J1.13
/D6: J1.15
/D7: J1.17
CLK: J1.58
GND: C6.2, C8.2, H3.1, H4.1, H5.1, H6.1, J1.1, J1.2, J1.4, J1.6, J1.8, J1.10, J1.12, J1.14, J1.16, J1.18, J1.20, J1.22, J1.24, J1.26, J1.28, J1.30, J1.32, J1.34, J1.36, J1.38, J1.40, J1.42, J1.44, J1.46, J1.48, J1.50
RnW: J1.51
SPCLK: J1.60
SYNQ: J1.52
nBUSRQ: J1.55
nIRQ: J1.54
nNMI: J1.56
nRES: J1.57
nSLOW: J1.53

Notes on the sheet:
nIRQ must be open collector/drain

Board: 4 copper layers, 7 parts (0 on the bottom side), 2 nets, no tracks yet.
