TechPaula/PC6502/(commit log)

2025-09-11 Initial Commit
    PCBs and CPLD code
    [MemoryMap.ods, PC6502-CPU.kicad_pcb, PC6502-CPU.kicad_sch, PC6502-TEMPLATE.kicad_pcb, PC6502-TEMPLATE.kicad_sch, PC6502-VIA.kicad_pcb, PC6502-VIA.kicad_sch, bom.csv]
2025-09-11 Updated Schematics
2025-09-11 Updated Template and .gitignore
    [PC6502-TEMPLATE.kicad_pcb, PC6502-TEMPLATE.kicad_sch]
2025-09-11 Added firmware
    Added my modified version of Grant Searl's 6502 code.
    It builds with the correct addresses but is not yet tested.
    [osi_bas.cfg]
2025-09-11 Updated RAM memory map
    [MemoryMap.ods]
2025-09-13 Add Power/Storage PCB
    Also tidied template
    [PC6502-CPU.kicad_sch, PC6502-PWRSTOR.kicad_pcb, PC6502-PWRSTOR.kicad_sch, PC6502-TEMPLATE.kicad_sch, PC6502-VIA.kicad_sch, SDCard.kicad_sch, ST4500_PWR.kicad_sch]
2025-09-14 Further routing
    So far all DDR tracks are 22.4mm in length, or within 0.5mm (~2.5pS)
    [8BitNCO.kicad_sch, PC6502-SOUND_GEN_A.kicad_pcb, PC6502-SOUND_GEN_A.kicad_sch]
2025-09-20 Created V1.1 Schematic and PCB
    A LOT of changes from v1.00;
    removed clock stretcher (will now live in the CPLD)
    moved the USB interface direct to the PCB
    changed power pins
    Added extra capacitance
    Used Grant Searle's OSI basic and memory map to bring up the board
    [60FAKE50.kicad_sch, 8BitNCO.kicad_sch, PC6502-CPU.kicad_pcb, PC6502-CPU.kicad_sch, PC6502-SOUND_GEN_A.kicad_pcb, PC6502-SOUND_GEN_A.kicad_sch]
2025-09-20 FT245 WRITE signal correction
    I had it marked as active low when it's active high, updated.
    [PC6502-CPU.kicad_pcb, PC6502-CPU.kicad_sch]
2025-09-20 FT245 label change
    [60FAKE50.kicad_sch, PC6502-CPU.kicad_sch]
2025-09-21 V1.1 CPU, VIA and POWER PCBs uploaded
    A simpler CPU board (direct link to FT245R, 74161 removed and some tidying of tracks). Fixed a couple of floating inputs to RAM/ROM
    VIA is much simpler, having just the one VIA chip.
    POWER board has USB-PD and a 24VDC input for higher power stuff in the future.
    [60FAKE50.kicad_sch, PC6502-CPU.kicad_pcb, PC6502-CPU.kicad_sch, PC6502-POWER.kicad_pcb, PC6502-POWER.kicad_sch, PC6502-PWRSTOR.kicad_pcb, PC6502-PWRSTOR.kicad_sch, PC6502-STORAGE.kicad_pcb]
2025-09-27 Tidy up and simplify
    Created schematic for FM & Speech sound board
    Made Storage board just for Compact Flash (CF) storage
    Routed Storage PCB
    [60FAKE50.kicad_sch, OPL3_DAC.kicad_sch, Output.kicad_sch, PC6502-CPU.kicad_sch, PC6502-FM-SPEECH.kicad_pcb, PC6502-FM-SPEECH.kicad_sch, PC6502-POWER.kicad_sch, PC6502-STORAGE.kicad_pcb]
2025-10-02 Updated following testing
    New CPLD code for CPU and VIA
    Fixed mistakes with CPU Board and upped to Rev 1.2 (My Rev 1.1 has mods on)
    Updated README
    [PC6502-CPU.kicad_pcb, PC6502-CPU.kicad_sch, PC6502-FM-SPEECH.kicad_sch, PC6502-FM-SPEECH.step, PC6502-POWER.step, PC6502-STORAGE.step, positions.csv]
2025-10-12 Ordered Storage, FM/Speech, Dual SPI and APPLE II slot PCBs
    [PC6502-AIISLOT.kicad_pcb, PC6502-AIISLOT.kicad_sch, PC6502-CPU.kicad_sch, PC6502-DUALSPI.kicad_pcb, PC6502-DUALSPI.kicad_sch, PC6502-FM-SPEECH.kicad_pcb, PC6502-STORAGE.kicad_pcb, PC6502-VIA.kicad_pcb]
2025-10-14 CPU CPLD UPDATE!!
    CPU will now run at 14MHz with the updated code in the CPLD
    Begun assembly of Speech/FM board
    [PC6502-AIISLOT.kicad_sch, PC6502-FM-SPEECH.kicad_pcb, PC6502-FM-SPEECH.kicad_sch]
2025-10-16 SP0256 Speech synth working
    SP0256 now working, couple of extra wires needed, but PCB and schematics updated.
    Test code (SP0256_TEST3.BAS) created.
    CPLD updated.
    [PC6502-FM-SPEECH.kicad_pcb, PC6502-FM-SPEECH.kicad_sch, SP0256-AL2.kicad_sch, bom.csv, designators.csv, positions.csv]
2025-10-19 Added more images / dual SPI CPLD code
    Added more photos,
    Added dual SPI CPLD code
    Added basic test code for dual SPI
    [PC6502-DUALSPI.kicad_sch]
2025-10-23 Updated Schematics and CPLD files
    Files updated for the CPU & FM Speech board
    Also revised CPLDs for CPU, VIA and Compact Flasg
    [OPL3_DAC.kicad_sch, PC6502-CPU.kicad_pcb, PC6502-CPU.kicad_sch, PC6502-FM-SPEECH.kicad_pcb, PC6502-FM-SPEECH.kicad_sch]
2025-10-23 Updated silk screen
    Updated silk screen on CPU board to V1.3
    [PC6502-CPU.kicad_pcb]
2025-10-24 Fixed output on FM/Speech card
    The ring and sleeve were the wrong way around.
    [Output.kicad_sch, PC6502-FM-SPEECH.kicad_pcb]
2025-11-02 KEYBoard/TFT interface schematics
    Rev 1.00 boards ordered.
    [PC6502-KEYTFT.kicad_pcb, PC6502-KEYTFT.kicad_sch, TFT_TA8875.kicad_sch, bom.csv, designators.csv, positions.csv]
2025-11-02 Keyboard files created and ordered.
    [Dual_QDSP-2118.kicad_sch, KeyMatrix.kicad_sch, PC6502_KEYBED.kicad_pcb, PC6502_KEYBED.kicad_sch, bom.csv, designators.csv, positions.csv]
2025-11-02 Created PMOD level shifter
    Made a simple 5V - 3,3V level shifter so I can test a display.
    [PMOD-LEVEL-SHIFTER.kicad_pcb, PMOD-LEVEL-SHIFTER.kicad_sch, bom.csv, designators.csv, positions.csv]
2025-11-12 Keyboard code and schematics
    Updated the Schematics and have a mostly functioning keyboard (can't turn off caps lock yet)
    [Dual_QDSP-2118.kicad_sch, PC6502_KEYBED.kicad_pcb, PC6502_KEYBED.kicad_sch]
2025-11-15 Updated CPU to Rev 1.4
    VErsion 1.4 of CPU board connects A15 direct to RAM and should allow me to get more than 32K of RAM available.
    [PC6502-CPU.kicad_pcb, PC6502-CPU.kicad_sch, bom.csv, designators.csv, positions.csv]
2025-11-15 KeyTFT to Rev 1.1
    COmplete revamp of Schamtic and PCB, to make things simpler, and hopefully a bit quicker.
    [PC6502-KEYTFT.kicad_pcb, PC6502-KEYTFT.kicad_sch, bom.csv, designators.csv, positions.csv]
2025-11-15 Begun work on Firmware
    Added placeholders for LOAD, SAVE and DIR
    Added script to build files
    Modified osi_bas.s to make it build with newer versions of ca65/ld65
    [osi_bas.cfg]
2025-11-15 rework broken BASIC source file
    [osi_bas.cfg]
2025-11-18 Added EhBASIC to repository
    There is now EhBASIC and EhBASIC with Wozmon ported to the PC6502.
    Thank you to SHONKY for sorting this :)
    [basic.cfg, osi_bas.cfg]
2025-11-20 Working on SPI display test
2025-11-21 Added keybed image
    fully assembled keybed image.
2025-11-23 Working on spi display configuration
    sadly not working
2025-11-23 display debugging
    added output from teensy console
2025-11-29 CPLD Updates
    This Updates the CPU CPLD to work with V1.4 of the CPU board and gives BOTH nSLOW pins control of CPU clock stretching
    Also added the CPLD code for the KEYTFT PCB
2025-12-06 Finally got display text working!
    [PC6502-KEYTFT.kicad_sch]
2025-12-14 Added basic tests for display, added transputer link adapter
    [LinkAdapter.kicad_sch, PC6502-CPU.kicad_sch, PC6502-TRANSPUTER.kicad_pcb, PC6502-TRANSPUTER.kicad_sch, TRAM_CONN.kicad_sch, bom.csv, designators.csv, positions.csv]
2025-12-24 Updated Transputer CPLD and Basic code
    writing and reading to/from the TRAM now works!
    [PC6502-TRANSPUTER.kicad_pcb]
2025-12-24 Added Dual transputer host card
    [LEDs.kicad_sch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]
2025-12-24 added image of transputer PCB
2025-12-28 Found an issue with Sound/Speech PCB, resolved
    [PC6502-FM-SPEECH.kicad_sch]
2025-12-28 Update KeyTFT CPLD
    [8BitNCO.kicad_sch, Buttons.kicad_sch, PC6502-KEYTFT.kicad_sch, PC6502-SOUND_GEN_A.kicad_pcb, PC6502-SOUND_GEN_A.kicad_sch, ROM-EMU.kicad_pcb, ROM-EMU.kicad_sch]
2025-12-29 Updated KeyTFT Schematic to include mods
    [PC6502-KEYTFT.kicad_pcb, PC6502-KEYTFT.kicad_sch]
2026-03-21 Changes I forgot to commit
    [PC6502-KEYTFT.kicad_pcb, PC6502-KEYTFT.kicad_sch]
